k3rnL/open-cinema-hardware/docs/rear-io-mechanical.md

# Current rear I/O mechanical model

Use [A9: PCB and connectors only](pcb-only-assembly-A9.md). The owner designs the backplate and L brackets. The [A8 PCB layout and connector evidence](horizontal-assembly-A8.md) remain applicable; its plate/bracket geometry is historical.
