k3rnL/open-cinema-hardware/boards/rear-io/exports/rear-io-A0-top.png

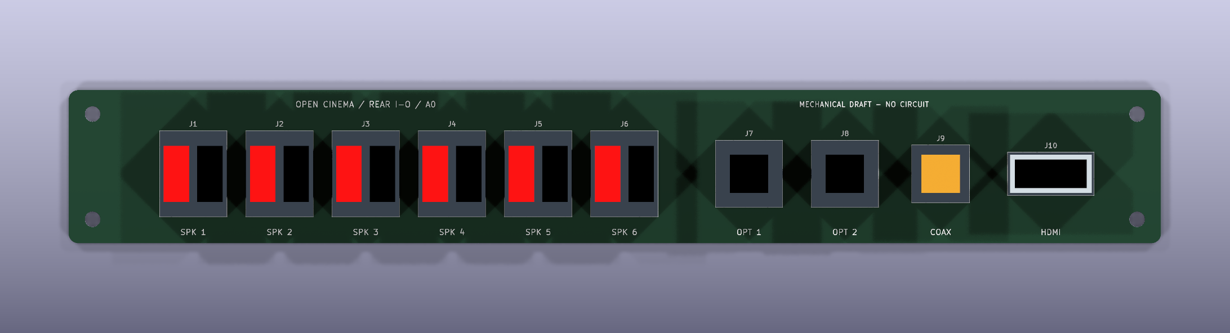
boards/rear-io/exports/rear-io-A0-top.png
