k3rnL/open-cinema-hardware/boards/rear-io/exports/rear-io-A1-front.png

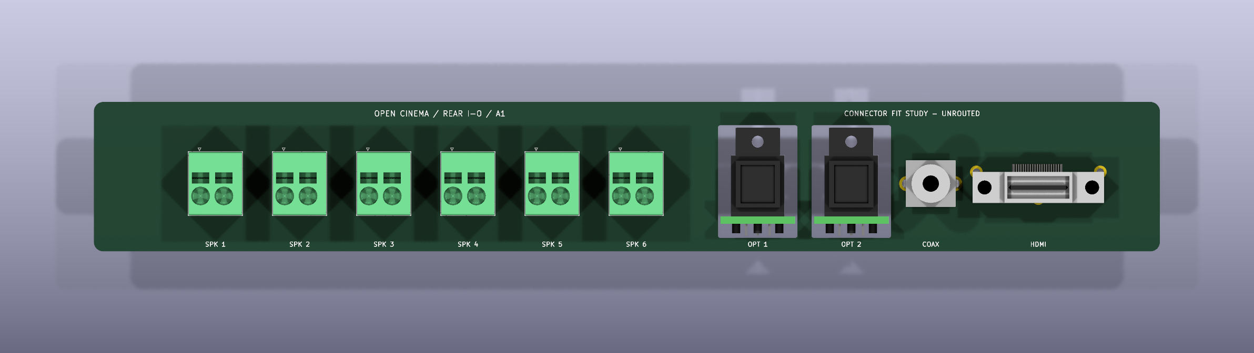
boards/rear-io/exports/rear-io-A1-front.png
