k3rnL/open-cinema-hardware/boards/rear-io/exports/rear-io-A1-oblique.png

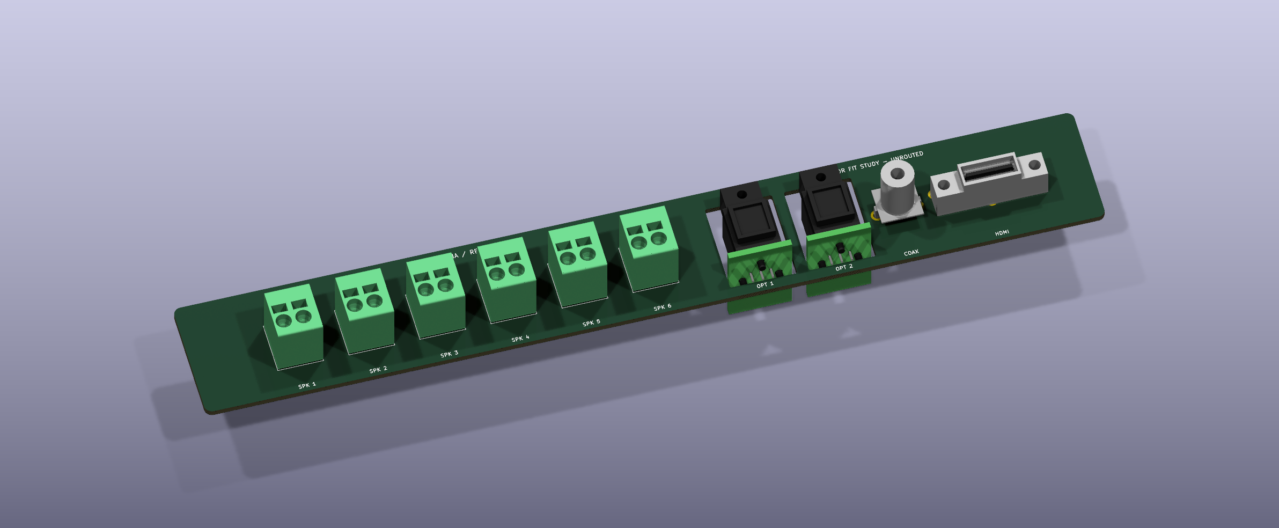
boards/rear-io/exports/rear-io-A1-oblique.png
