k3rnL/open-cinema-hardware/boards/rear-io/exports/rear-io-A3-oblique.png

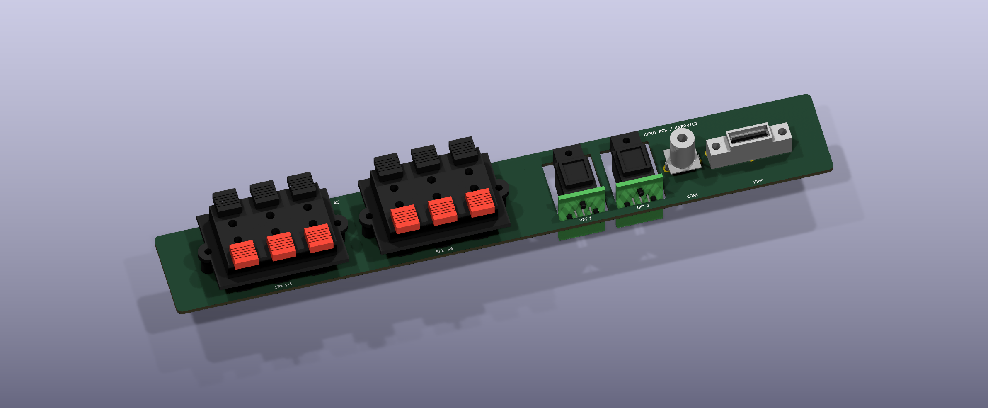
boards/rear-io/exports/rear-io-A3-oblique.png
