k3rnL/open-cinema-hardware/boards/rear-io/exports/rear-io-A8-context.png

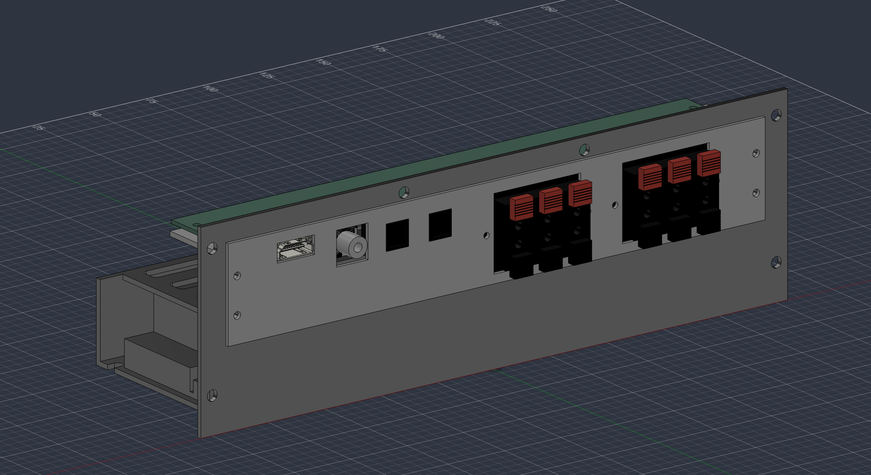
boards/rear-io/exports/rear-io-A8-context.png
