k3rnL/open-cinema-hardware/boards/rear-io/exports/rear-io-A8-live-enclosure.png

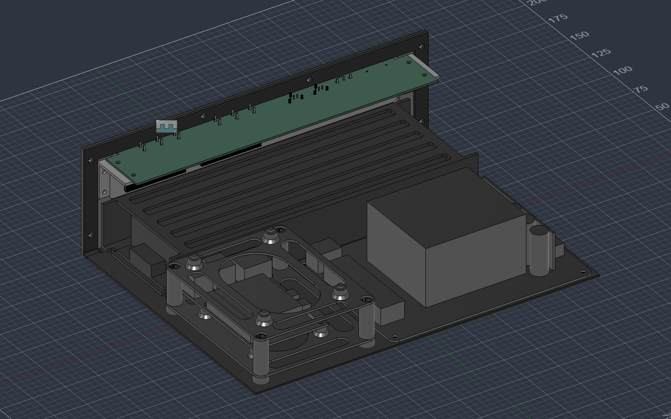
boards/rear-io/exports/rear-io-A8-live-enclosure.png
