k3rnL/open-cinema-hardware/mechanical/reference/2026-11-03-owner-A7-depth-top.png

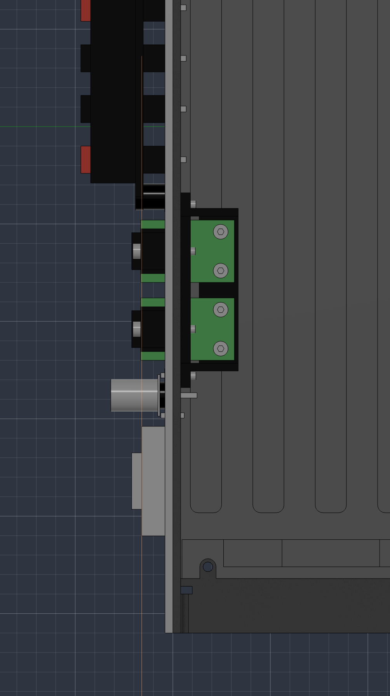
mechanical/reference/2026-11-03-owner-A7-depth-top.png
