k3rnL/open-cinema-hardware/mechanical/reference/rear-panel-220x35.png

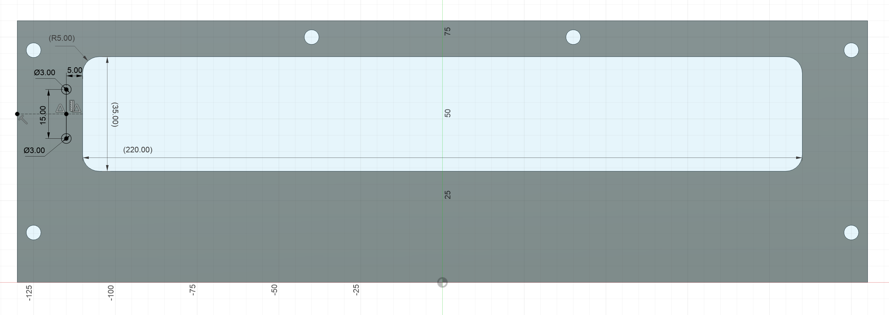
mechanical/reference/rear-panel-220x35.png
