k3rnL/open-cinema-hardware/mechanical/reference/rear-panel-fixing-reference.png

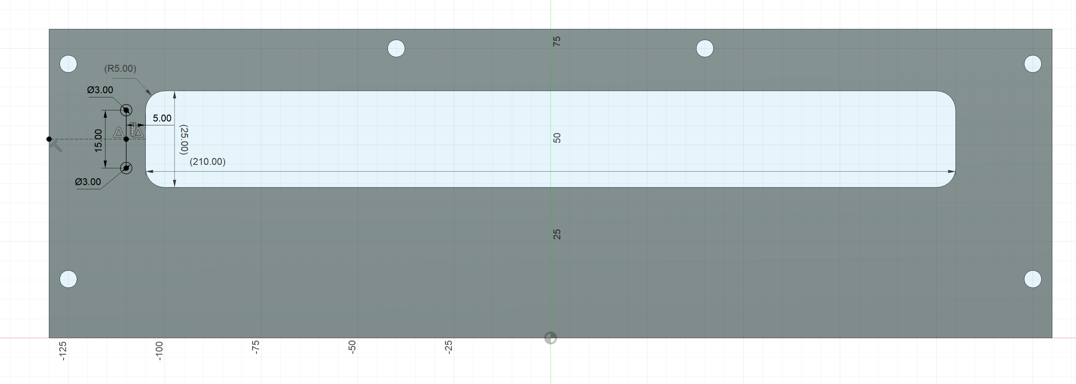
mechanical/reference/rear-panel-fixing-reference.png
