k3rnL/open-cinema-hardware/mechanical/reference/rear-panel-frame.png

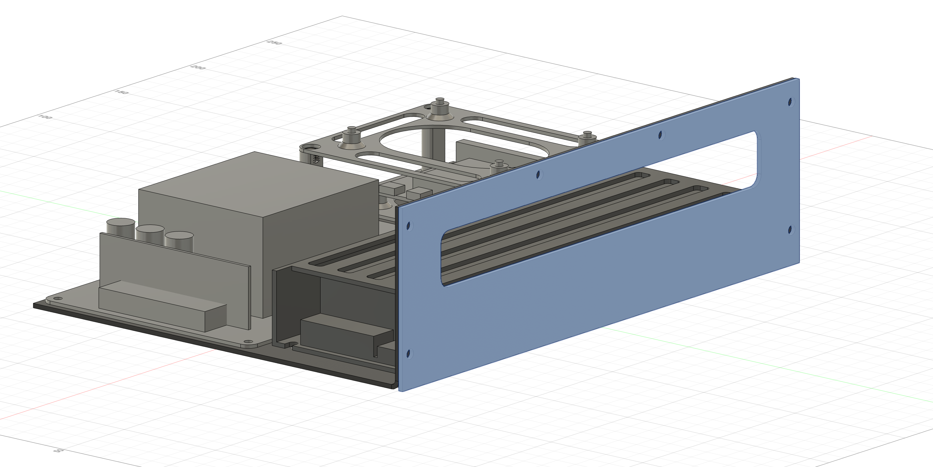
mechanical/reference/rear-panel-frame.png
