k3rnL/open-cinema-hardware/mechanical/reference/rear-panel-free-space.png

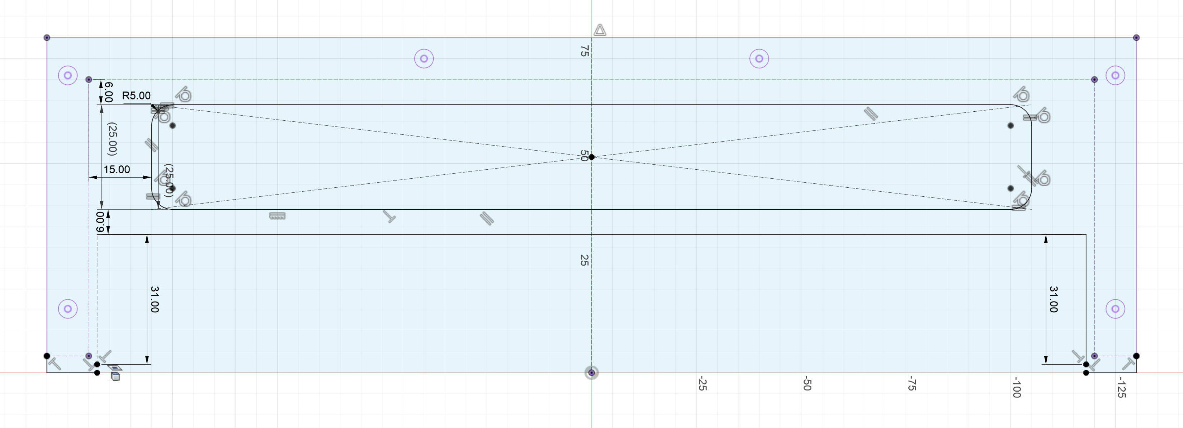
mechanical/reference/rear-panel-free-space.png
