k3rnL/open-cinema-hardware/docs/sourcing-A7.md

# A7 sourcing — accepted FE6930 selection

2026-11-03. JLCPCB is preferred; the owner permits Global Sourcing/pre-order and outside suppliers. No purchases or supplier requests have been made. This worksheet covers the mechanical connector selection, not a finished PCBA BOM.

| Qty | Exact part | Procurement route |
| --- | --- | --- |
| 2 | **Cliff FE6930** eight-contact speaker block | [DigiKey 4654-FE6930-ND](https://www.digikey.com/en/products/detail/cliff-electronic-components-ltd/FE6930/25552004); retrieved page showed active, 151 in stock, minimum 1. Web result can be cached; recheck at checkout. Outside purchase is permitted. No confirmed JLC stock/acceptance claimed |
| 2 | Cliff **FCR684205R / ORJ5** optical receiver | [DigiKey 4654-FCR684205R-ND](https://www.digikey.com/en/products/detail/cliff-electronic-components-ltd/FCR684205R/15283094); distributor stock checked in the earlier same-day A6 audit. JLC Global Sourcing subject to acceptance, otherwise external purchase |
| 1 | Same Sky **RCJ-021** RCA | [JLC C4992555](https://jlcpcb.com/partdetail/CUI-RCJ021/C4992555), zero public stock in A6 audit; external [DigiKey CP-1406-ND](https://www.digikey.co.uk/en/products/detail/same-sky-formerly-cui-devices/RCJ-021/408493) alternative |
| 1 | Amphenol **10078837-001LF** HDMI | [JLC C7159430](https://jlcpcb.com/partdetail/AmphenolICC-10078837001LF/C7159430), 2400 shown in the earlier same-day live catalogue audit; confirm with eventual PCBA order |

FE6930 selection is now accepted for the fit model, superseding A6's unresolved PT-603B candidate. The manufacturer publishes **7 A at 60 V AC**; exact geometry/rating evidence and pair mapping are in [connector selection](connector-selection-A7.md). Do not substitute an unbranded lookalike based only on a photograph.

If JLC cannot procure/assemble these through-hole parts, buy them externally and populate them after PCB manufacture. Consignment is only an option if JLC accepts the parts and process. Distributor stock is not JLC inventory, and Global Sourcing supplies subsequent PCBA rather than loose parts. [Earlier catalogue audit and policy sources](sourcing-A6.md).

The optical cradle and M2 fasteners are separate mechanical purchases; see [assembly](assembly-and-optical-support-A7.md). No cradle manufacturing quote, final speaker fastening stack, physical sample fit, production footprint approval or solder process qualification exists yet. The board has no circuitry and is not ready for a production order.
