k3rnL/open-cinema-hardware/boards/rear-io-A12/bom-draft.csv

ref | value | mpn | fp | dnp | source
U6 | TLV75533PDRVR | TLV75533PDRVR | Package_SON:WSON-6-1EP_2x2mm_P0.65mm_EP1x1.6mm | False | https://www.ti.com/lit/ds/symlink/tlv755p.pdf
J21 | 5V regulated input | TSW-102-07-G-S | Connector_PinHeader_2.54mm:PinHeader_1x02_P2.54mm_Vertical | False | https://www.samtec.com/products/tsw-102-07-g-s
J20 | PI CONTROL / NOT PI PINOUT | TSW-106-07-G-D | Connector_PinHeader_2.54mm:PinHeader_2x06_P2.54mm_Vertical | False | https://www.samtec.com/products/tsw-106-07-g-d
C1 | 4.7uF | CL10A475KO8NNNC | Capacitor_SMD:C_0603_1608Metric | False
C2 | 4.7uF | CL10A475KO8NNNC | Capacitor_SMD:C_0603_1608Metric | False
C3 | 10uF | CL10A106KP8NNNC | Capacitor_SMD:C_0603_1608Metric | False
R1 | 4.7k | RC0603FR-074K7L | Resistor_SMD:R_0603_1608Metric | True
R2 | 4.7k | RC0603FR-074K7L | Resistor_SMD:R_0603_1608Metric | True
R3 | 10k | RC0603FR-0710KL | Resistor_SMD:R_0603_1608Metric | False
R6 | 10k | RC0603FR-0710KL | Resistor_SMD:R_0603_1608Metric | False
U1 | CS8416K-CZZR | CS8416K-CZZR | Package_SO:TSSOP-28_4.4x9.7mm_P0.65mm | False | https://statics.cirrus.com/pubs/proDatasheet/CS8416_DS578F5.pdf
J7 | FCR684205R | FCR684205R | OpenCinema_Connectors:Cliff_FCR684205R | False
C11 | 100nF | CL10B104KB8NNNC | Capacitor_SMD:C_0603_1608Metric | False
C13 | 100nF | CL10B104KB8NNNC | Capacitor_SMD:C_0603_1608Metric | False
C15 | 30pF C0G | CL10C300JB8NNNC | Capacitor_SMD:C_0603_1608Metric | False
J8 | FCR684205R | FCR684205R | OpenCinema_Connectors:Cliff_FCR684205R | False
C12 | 100nF | CL10B104KB8NNNC | Capacitor_SMD:C_0603_1608Metric | False
C14 | 100nF | CL10B104KB8NNNC | Capacitor_SMD:C_0603_1608Metric | False
C16 | 30pF C0G | CL10C300JB8NNNC | Capacitor_SMD:C_0603_1608Metric | False
J9 | RCJ-011 | RCJ-011 | OpenCinema_Connectors:SameSky_RCJ_011_Horizontal_A8 | False
R10 | 75R 1% | RC0603FR-0775RL | Resistor_SMD:R_0603_1608Metric | False
C17 | 10nF | CL10B103KB8NNNC | Capacitor_SMD:C_0603_1608Metric | False
C18 | 10nF | CL10B103KB8NNNC | Capacitor_SMD:C_0603_1608Metric | False
FB1 | 600R @100MHz | BLM18AG601SN1D | Inductor_SMD:L_0603_1608Metric | False
C19 | 100nF | CL10B104KB8NNNC | Capacitor_SMD:C_0603_1608Metric | False
C20 | 10uF | CL10A106KP8NNNC | Capacitor_SMD:C_0603_1608Metric | False
C21 | 100nF | CL10B104KB8NNNC | Capacitor_SMD:C_0603_1608Metric | False
C22 | 100nF | CL10B104KB8NNNC | Capacitor_SMD:C_0603_1608Metric | False
C23 | 1nF C0G | CL10C102JB8NNNC | Capacitor_SMD:C_0603_1608Metric | False
C24 | 22nF X7R | CL10B223KB8NNNC | Capacitor_SMD:C_0603_1608Metric | False
R11 | 3k 1% | RC0603FR-073KL | Resistor_SMD:R_0603_1608Metric | False
R12 | 47k | RC0603FR-0747KL | Resistor_SMD:R_0603_1608Metric | False
R13 | 47k | RC0603FR-0747KL | Resistor_SMD:R_0603_1608Metric | False
R14 | 10k | RC0603FR-0710KL | Resistor_SMD:R_0603_1608Metric | False
R15 | 10k | RC0603FR-0710KL | Resistor_SMD:R_0603_1608Metric | False
U4 | DS90LV047ATMTC/NOPB | DS90LV047ATMTC/NOPB | Package_SO:TSSOP-16_4.4x5mm_P0.65mm | False | https://www.ti.com/lit/ds/symlink/ds90lv047a.pdf
J22 | 3 LVDS PAIRS / PROVISIONAL | TSW-110-07-G-D | Connector_PinHeader_2.54mm:PinHeader_2x10_P2.54mm_Vertical | False | https://www.samtec.com/products/tsw-110-07-g-d
C32 | 100nF | CL10B104KB8NNNC | Capacitor_SMD:C_0603_1608Metric | False
SP1 | KLS1-WP-6P-03B / UNQUALIFIED | L-KLS1-WP-6P-03B-B/R | OpenCinema_Connectors:KLS1_WP_6P_03B_Horizontal_A8 | False
J31 | AMP WIRE SOLDER PADS | PCB_SOLDER_PADS_1SQMM | Connector_Wire:SolderWire-1sqmm_1x06_P5.4mm_D1.4mm_OD2.7mm | False
SP2 | KLS1-WP-6P-03B / UNQUALIFIED | L-KLS1-WP-6P-03B-B/R | OpenCinema_Connectors:KLS1_WP_6P_03B_Horizontal_A8 | False
J32 | AMP WIRE SOLDER PADS | PCB_SOLDER_PADS_1SQMM | Connector_Wire:SolderWire-1sqmm_1x06_P5.4mm_D1.4mm_OD2.7mm | False
U7 | ADV7511KSTZ / ARC candidate | ADV7511KSTZ | Package_QFP:LQFP-100_14x14mm_P0.5mm | False | https://www.analog.com/media/en/technical-documentation/user-guides/ADV7511_Hardware_Users_Guide.pdf
R40 | 887R 1% | RC0603FR-07887RL | Resistor_SMD:R_0603_1608Metric | False
R41 | 2k 1% | RC0603FR-072KL | Resistor_SMD:R_0603_1608Metric | False
R42 | 2k 1% | RC0603FR-072KL | Resistor_SMD:R_0603_1608Metric | False
Y1 | 12 MHz / ASV-12.000MHZ-E-T | ASV-12.000MHZ-E-T | Oscillator:Oscillator_SMD_Abracon_ASV-4Pin_7.0x5.1mm | False | https://abracon.com/Oscillators/ASV.pdf
R43 | 33R | RC0603FR-0733RL | Resistor_SMD:R_0603_1608Metric | False
C40 | 100nF | CL10B104KB8NNNC | Capacitor_SMD:C_0603_1608Metric | False
J10 | 10029449-001RLF / ARC ONLY | 10029449-001RLF | OpenCinema_Connectors:HDMI_A_Amphenol_10029449-x01xLF_Horizontal | False
C41 | 1uF 16V | CL10B105KO8NNNC | Capacitor_SMD:C_0603_1608Metric | False
C42 | 1uF 16V | CL10B105KO8NNNC | Capacitor_SMD:C_0603_1608Metric | False
R44 | 49.9R 1% | RC0603FR-0749R9L | Resistor_SMD:R_0603_1608Metric | False
R45 | 49.9R 1% | RC0603FR-0749R9L | Resistor_SMD:R_0603_1608Metric | False
R46 | 10k | RC0603FR-0710KL | Resistor_SMD:R_0603_1608Metric | False
R47 | 2k 1% | RC0603FR-072KL | Resistor_SMD:R_0603_1608Metric | False
R48 | 2k 1% | RC0603FR-072KL | Resistor_SMD:R_0603_1608Metric | False
R49 | 27k 1% | RC0603FR-0727KL | Resistor_SMD:R_0603_1608Metric | False
D1 | BAS116,215 | BAS116,215 | Package_TO_SOT_SMD:SOT-23 | False | https://assets.nexperia.com/documents/data-sheet/BAS116.pdf
R50 | 33R | RC0603FR-0733RL | Resistor_SMD:R_0603_1608Metric | False
C43 | 100nF | CL10B104KB8NNNC | Capacitor_SMD:C_0603_1608Metric | False
R51 | 0R / chassis bond DNP | RC0603JR-070RL | Resistor_SMD:R_0603_1608Metric | True
U10 | TPD4E05U06DQAR | TPD4E05U06DQAR | Package_SON:USON-10_2.5x1.0mm_P0.5mm | False | https://www.ti.com/lit/ds/symlink/tpd4e05u06.pdf
U11 | TPD4E05U06DQAR | TPD4E05U06DQAR | Package_SON:USON-10_2.5x1.0mm_P0.5mm | False | https://www.ti.com/lit/ds/symlink/tpd4e05u06.pdf
U8 | TLV75518PDRVR | TLV75518PDRVR | Package_SON:WSON-6-1EP_2x2mm_P0.65mm_EP1x1.6mm | False | https://www.ti.com/lit/ds/symlink/tlv755p.pdf
C44 | 4.7uF | CL10A475KO8NNNC | Capacitor_SMD:C_0603_1608Metric | False
C45 | 4.7uF | CL10A475KO8NNNC | Capacitor_SMD:C_0603_1608Metric | False
L1 | 10uH / SRN4018-100M | SRN4018-100M | Inductor_SMD:L_Bourns-SRN4018 | False | https://www.bourns.com/docs/product-datasheets/srn4018.pdf
C46 | 10uF | CL10A106KP8NNNC | Capacitor_SMD:C_0603_1608Metric | False
L2 | 10uH / SRN4018-100M | SRN4018-100M | Inductor_SMD:L_Bourns-SRN4018 | False | https://www.bourns.com/docs/product-datasheets/srn4018.pdf
C47 | 10uF | CL10A106KP8NNNC | Capacitor_SMD:C_0603_1608Metric | False
L3 | 10uH / SRN4018-100M | SRN4018-100M | Inductor_SMD:L_Bourns-SRN4018 | False | https://www.bourns.com/docs/product-datasheets/srn4018.pdf
C48 | 10uF | CL10A106KP8NNNC | Capacitor_SMD:C_0603_1608Metric | False
C50 | 100nF / U7 pin 1 | CL10B104KB8NNNC | Capacitor_SMD:C_0603_1608Metric | False
C51 | 100nF / U7 pin 19 | CL10B104KB8NNNC | Capacitor_SMD:C_0603_1608Metric | False
C52 | 100nF / U7 pin 49 | CL10B104KB8NNNC | Capacitor_SMD:C_0603_1608Metric | False
C53 | 100nF / U7 pin 76 | CL10B104KB8NNNC | Capacitor_SMD:C_0603_1608Metric | False
C54 | 100nF / U7 pin 77 | CL10B104KB8NNNC | Capacitor_SMD:C_0603_1608Metric | False
C55 | 100nF / U7 pin 24 | CL10B104KB8NNNC | Capacitor_SMD:C_0603_1608Metric | False
C56 | 100nF / U7 pin 25 | CL10B104KB8NNNC | Capacitor_SMD:C_0603_1608Metric | False
C57 | 100nF / U7 pin 29 | CL10B104KB8NNNC | Capacitor_SMD:C_0603_1608Metric | False
C58 | 100nF / U7 pin 34 | CL10B104KB8NNNC | Capacitor_SMD:C_0603_1608Metric | False
C59 | 100nF / U7 pin 41 | CL10B104KB8NNNC | Capacitor_SMD:C_0603_1608Metric | False
C60 | 100nF / U7 pin 21 | CL10B104KB8NNNC | Capacitor_SMD:C_0603_1608Metric | False
C61 | 100nF / U7 pin 26 | CL10B104KB8NNNC | Capacitor_SMD:C_0603_1608Metric | False
C62 | 100nF / U7 pin 47 | CL10B104KB8NNNC | Capacitor_SMD:C_0603_1608Metric | False
U9 | TPS2553DBVR | TPS2553DBVR | Package_TO_SOT_SMD:SOT-23-6 | False | https://www.ti.com/lit/ds/symlink/tps2553.pdf
R52 | 226k 1% | RC0603FR-07226KL | Resistor_SMD:R_0603_1608Metric | False
R53 | 10k | RC0603FR-0710KL | Resistor_SMD:R_0603_1608Metric | False
R54 | 10k | RC0603FR-0710KL | Resistor_SMD:R_0603_1608Metric | False
C63 | 1uF 16V | CL10B105KO8NNNC | Capacitor_SMD:C_0603_1608Metric | False
C64 | 100nF | CL10B104KB8NNNC | Capacitor_SMD:C_0603_1608Metric | False
J24 | HDMI POWER FAULT / GND | TSW-102-07-G-S | Connector_PinHeader_2.54mm:PinHeader_1x02_P2.54mm_Vertical | False | https://www.samtec.com/products/tsw-102-07-g-s
D2 | TPD1E10B06DYAR | TPD1E10B06DYAR | Diode_SMD:D_SOD-523 | False | https://www.ti.com/lit/ds/symlink/tpd1e10b06.pdf
