k3rnL/open-cinema-hardware/boards/rear-io/connector-placement.csv

ref | label | footprint | rear_x | depth | angle | mpn
SP1 | 3 speaker pairs - candidate | KLS1_WP_6P_03B_Horizontal_A8 | -75 | 0 | 0 | L-KLS1-WP-6P-03B-B/R
SP2 | 3 speaker pairs - candidate | KLS1_WP_6P_03B_Horizontal_A8 | -18 | 0 | 0 | L-KLS1-WP-6P-03B-B/R
J7 | Optical | Cliff_FCR684205R | 25 | 9 | 0 | FCR684205R
J8 | Optical | Cliff_FCR684205R | 44 | 9 | 0 | FCR684205R
J9 | Coax | SameSky_RCJ_011_Horizontal_A8 | 64 | 7 | 0 | RCJ-011
J10 | HDMI | HDMI_A_Amphenol_10029449-x01xLF_Horizontal | 89 | 2.7 | 180 | 10029449-001RLF
H1 | PCB mounting reference | MountingHole_D3_Reference_A8 | -110 | 12 | 0 | D3 reference
H2 | PCB mounting reference | MountingHole_D3_Reference_A8 | -110 | 30 | 0 | D3 reference
H3 | PCB mounting reference | MountingHole_D3_Reference_A8 | 110 | 12 | 0 | D3 reference
H4 | PCB mounting reference | MountingHole_D3_Reference_A8 | 110 | 30 | 0 | D3 reference
