k3rnL/open-cinema-hardware/boards/rear-io/exports/rear-io-A8-assembly.step

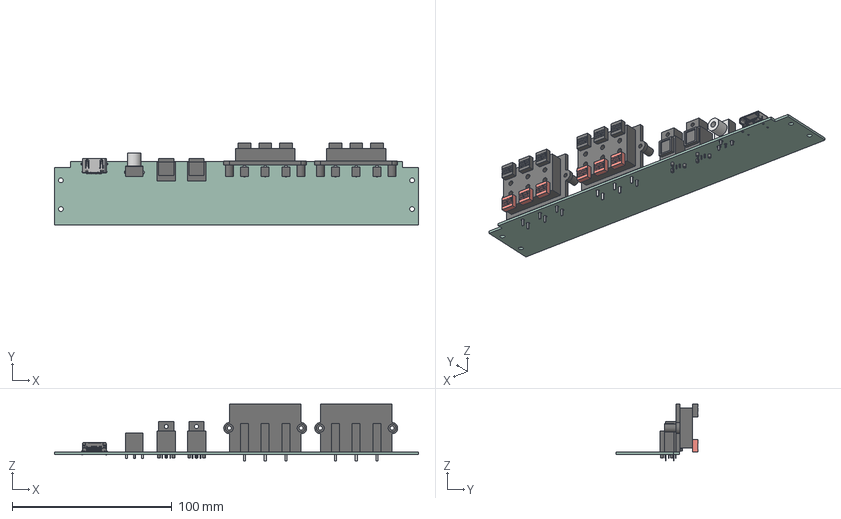
[picture p26: CAD file, 2026-11-03]
boards/rear-io/exports/rear-io-A8-assembly.step
228.0 x 51.4 x 35.5 mm
HDMI_A_Amphenol_10029449-x01xLF_Horizontal
Cliff_FCR684205R x 2
Same Sky RCJ-011 horizontal
KLS right-angle candidate - current rating UNVERIFIED x 2
rear-io_PCB
