k3rnL/open-cinema-hardware/boards/rear-io/exports/rear-io-A7-assembly.step

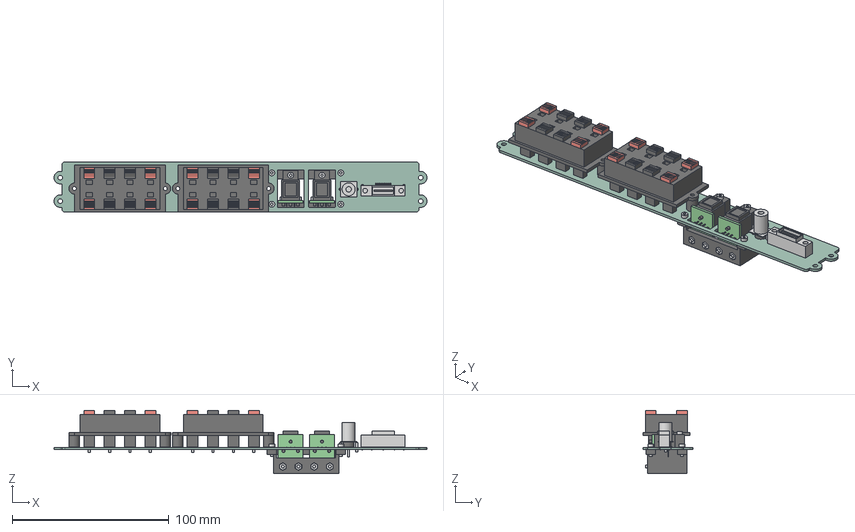
[picture p27: CAD file, 2026-11-03]
boards/rear-io/exports/rear-io-A7-assembly.step
238.0 x 32.0 x 40.4 mm
Cradle_and_M2_fasteners
Optical_daughterboard_assembly x 2
SameSky_RCJ-021
Amphenol_10078837-001LF
Cliff FE6930 - 8 contacts - straight rear tails x 2
rear-io_PCB
