k3rnL/open-cinema-hardware/boards/rear-io/models/optical-daughterboard-assembly.step

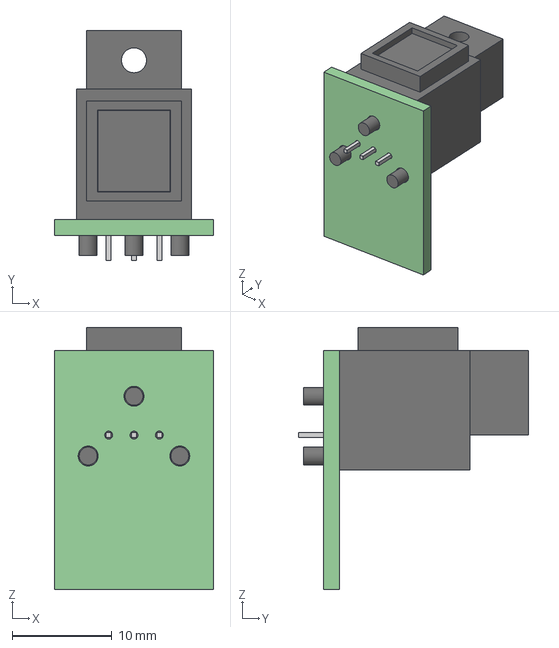
[picture p28: CAD file, 2026-11-03]
boards/rear-io/models/optical-daughterboard-assembly.step
16.0 x 23.1 x 26.3 mm
