k3rnL/open-cinema-hardware/boards/rear-io/exports/rear-io-A4-assembly.step

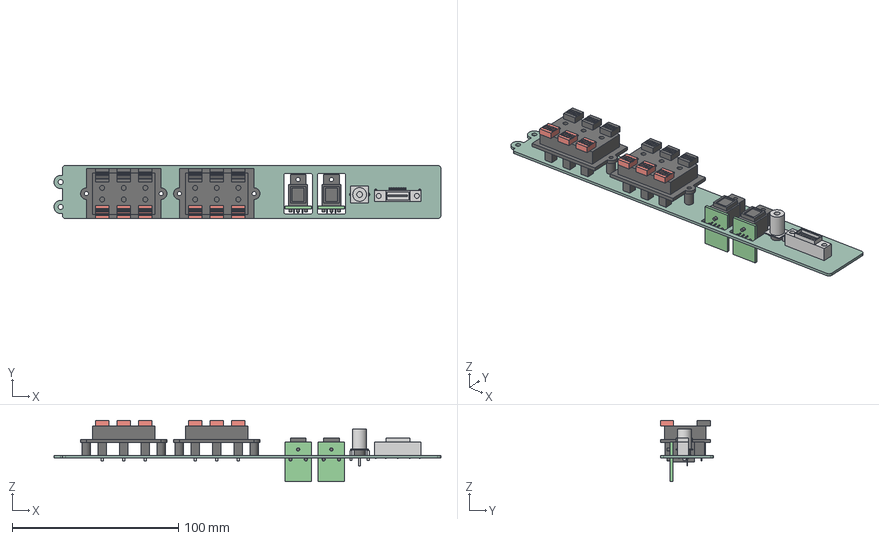
[picture p31: CAD file, 2026-11-03]
boards/rear-io/exports/rear-io-A4-assembly.step
233.0 x 32.0 x 37.0 mm
Optical_daughterboard_assembly x 2
DragonCity_PT-603B - straight rear tails x 2
SameSky_RCJ-021
Amphenol_10078837-001LF
rear-io_PCB
