k3rnL/open-cinema-hardware/boards/rear-io/exports/rear-io-A2-assembly.step

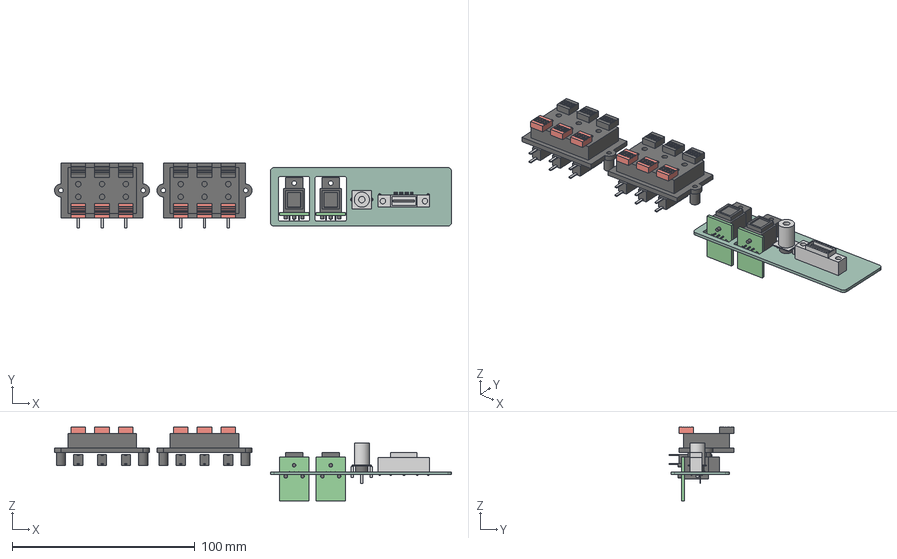
[picture p32: CAD file, 2026-11-03]
boards/rear-io/exports/rear-io-A2-assembly.step
217.0 x 35.5 x 40.2 mm
Optical_daughterboard_assembly x 2
KLS1-WP-6P-03B - mechanical candidate x 2
Amphenol_10078837-001LF
SameSky_RCJ-021
rear-io_PCB
