k3rnL/open-cinema-hardware/boards/rear-io/exports/rear-io-A1-assembly.step

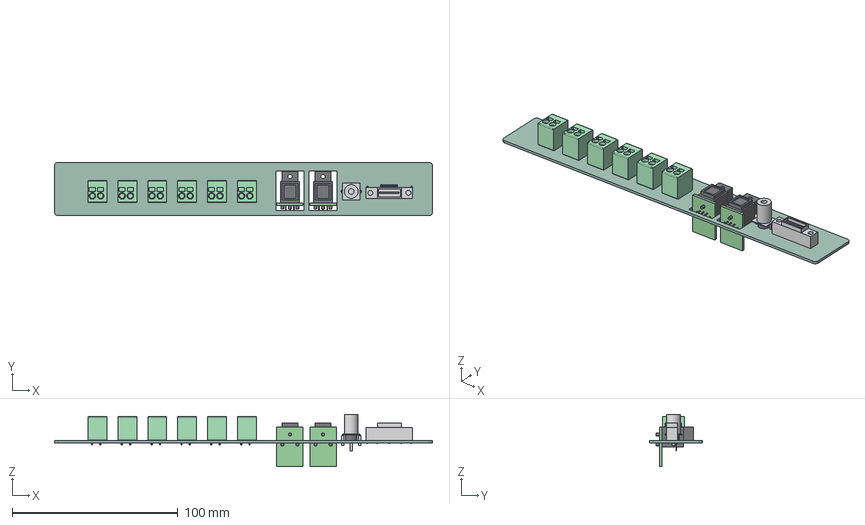
[picture p33: CAD file, 2026-11-03]
boards/rear-io/exports/rear-io-A1-assembly.step
228.0 x 32.0 x 31.6 mm
Amphenol_10078837-001LF
a63837e4-a09d-11ed-8f45-a0cec80452fd_part x 6
a6383c44-a09d-11ed-8f45-a0cec80452fd_part x 6
a6383f14-a09d-11ed-8f45-a0cec80452fd_part x 6
Optical_daughterboard_assembly x 2
SameSky_RCJ-021
rear-io_PCB
