k3rnL/open-cinema-hardware/boards/rear-io-A10/exports/rear-io-A10-rigid.step

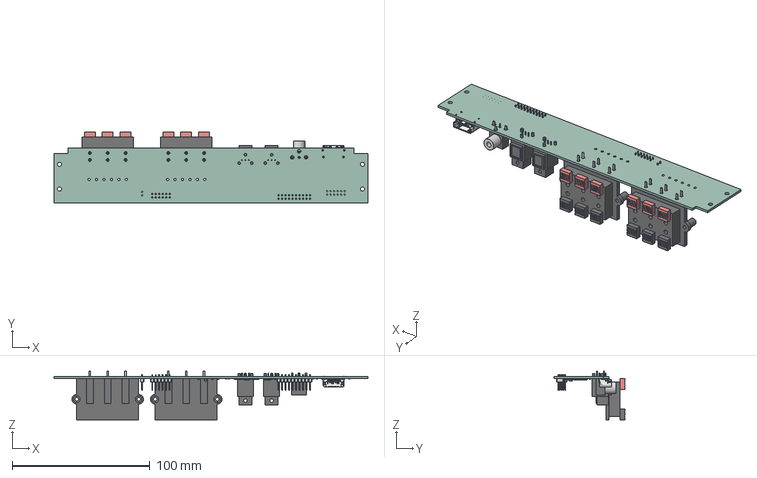
[picture p34: CAD file, 2026-11-03]
boards/rear-io-A10/exports/rear-io-A10-rigid.step
228.0 x 51.4 x 35.5 mm
