k3rnL/open-cinema-hardware/boards/rear-io-A10/models/SOT-23-5.step

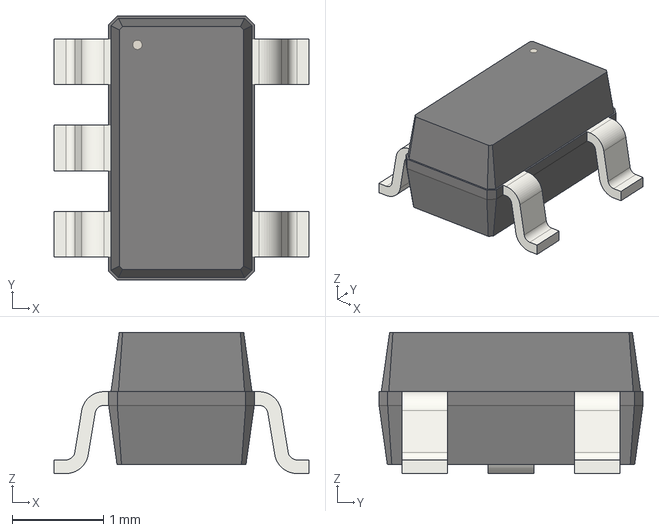
[picture p35: CAD file, 2026-11-03]
boards/rear-io-A10/models/SOT-23-5.step
2.80 x 2.90 x 1.55 mm
