k3rnL/open-cinema-hardware/boards/rear-io-A12/exports/rear-io-A12-rigid.step

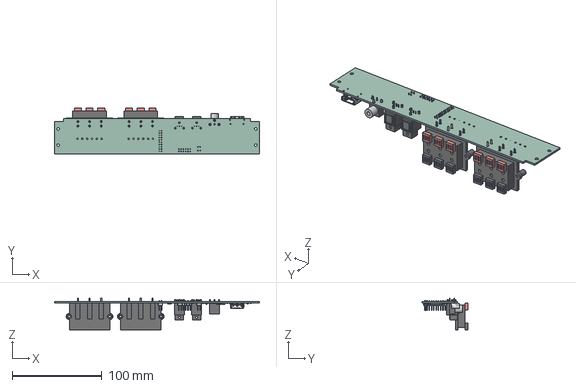
[picture p37: CAD file, 2026-11-04]
boards/rear-io-A12/exports/rear-io-A12-rigid.step
228.0 x 51.4 x 35.5 mm
