k3rnL/open-cinema-hardware/boards/rear-io-A12/models/D_SOD-523.step

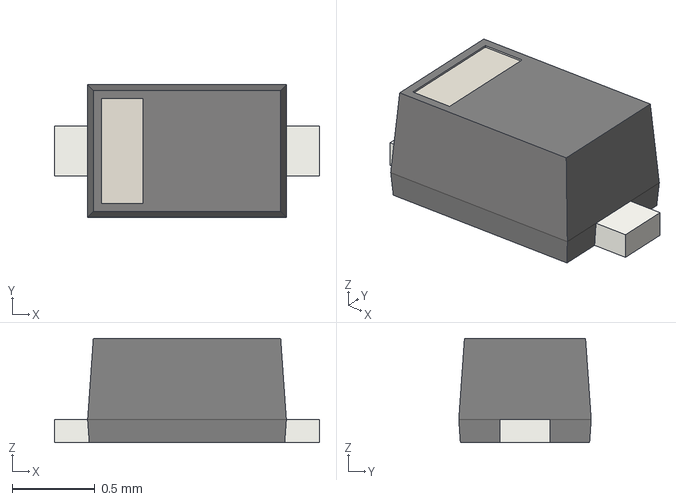
[picture p38: CAD file, 2026-11-04]
boards/rear-io-A12/models/D_SOD-523.step
1.60 x 0.8 x 0.63 mm
