k3rnL/open-cinema-hardware/boards/rear-io/models/RCJ-011_A8.step

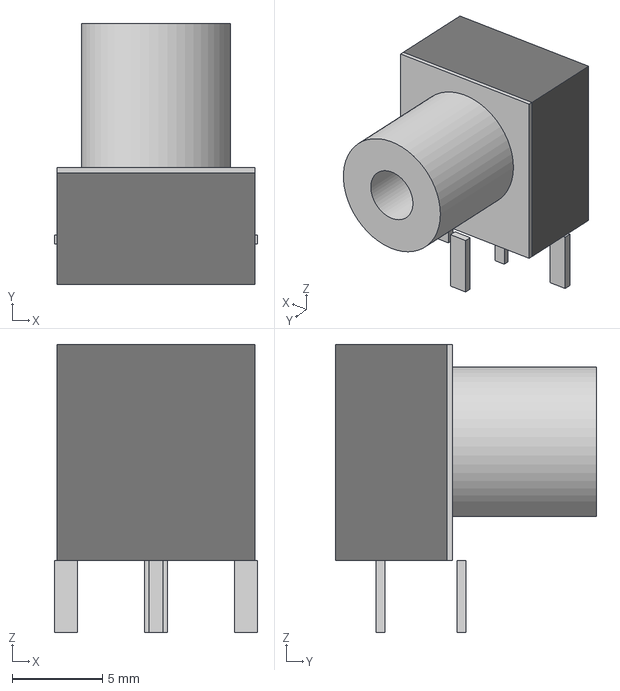
[picture p39: CAD file, 2026-11-03]
boards/rear-io/models/RCJ-011_A8.step
11.3 x 14.5 x 16.0 mm
