k3rnL/open-cinema-hardware/boards/rear-io-A12/models/SOT-23-6.step

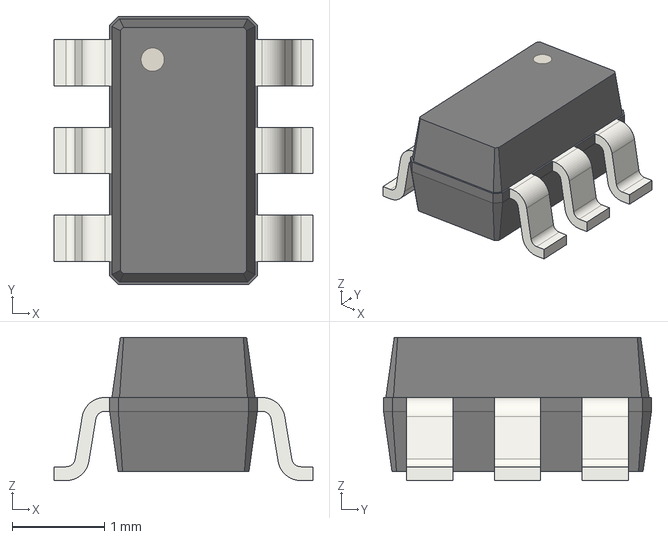
[picture p40: CAD file, 2026-11-04]
boards/rear-io-A12/models/SOT-23-6.step
2.80 x 2.90 x 1.55 mm
