k3rnL/open-cinema-hardware/boards/rear-io/models/HDMI_A_Amphenol_10029449-x01xLF_Horizontal.step

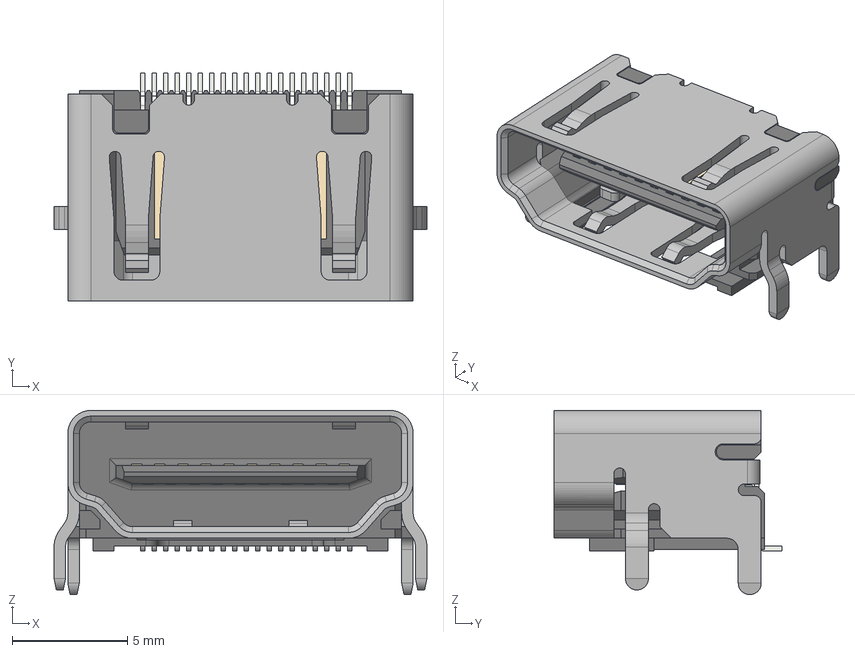
[picture p41: CAD file, 2026-11-03]
boards/rear-io/models/HDMI_A_Amphenol_10029449-x01xLF_Horizontal.step
16.2 x 9.90 x 8.00 mm
