k3rnL/open-cinema-hardware/boards/rear-io-A12/models/USON-10_2.5x1.0mm_P0.5mm.step

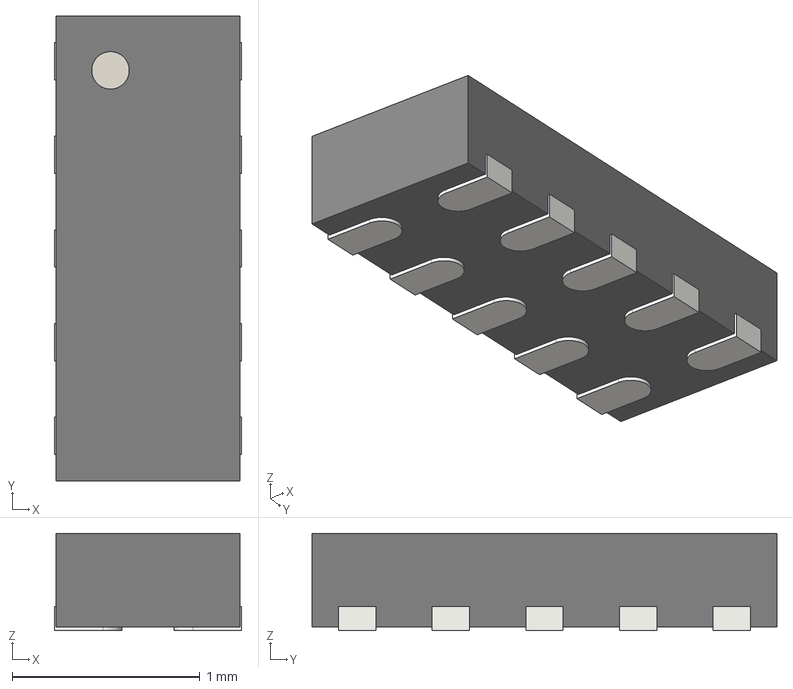
[picture p42: CAD file, 2026-11-04]
boards/rear-io-A12/models/USON-10_2.5x1.0mm_P0.5mm.step
1.00 x 2.48 x 0.52 mm
