k3rnL/open-cinema-hardware/boards/rear-io/models/KLS1-WP-6P-03B_horizontal_A8.step

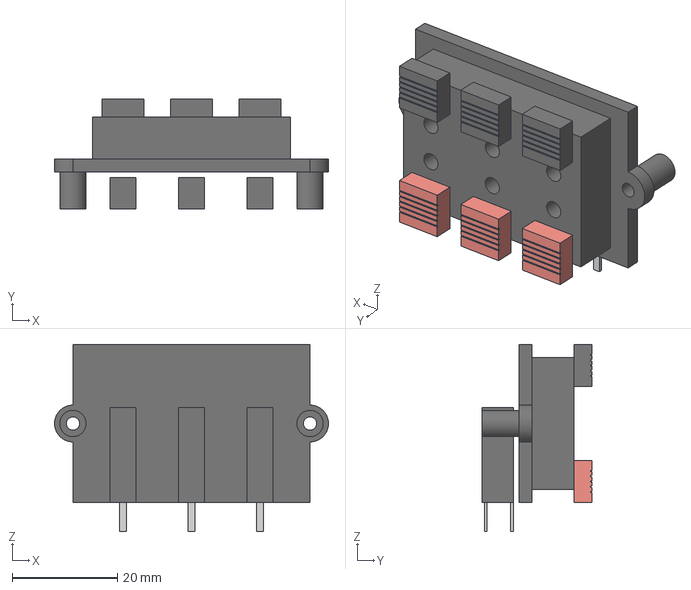
[picture p43: CAD file, 2026-11-03]
boards/rear-io/models/KLS1-WP-6P-03B_horizontal_A8.step
52.0 x 20.9 x 35.5 mm
