k3rnL/open-cinema-hardware/boards/rear-io-A12/models/WSON-6-1EP_2x2mm_P0.65mm_EP1x1.6mm.step

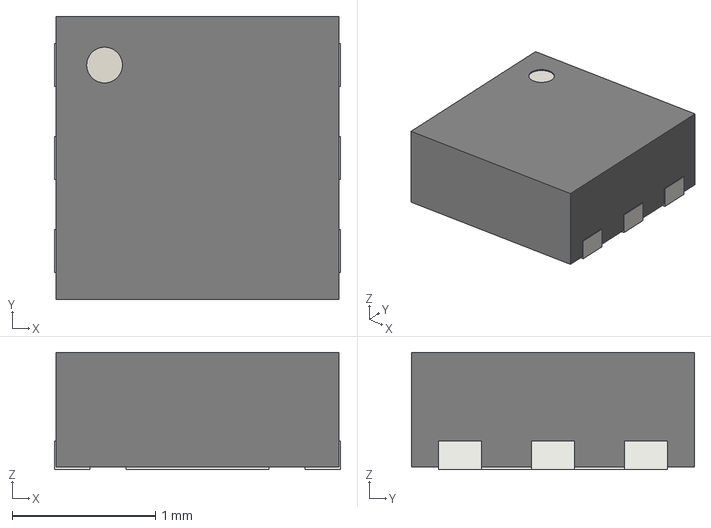
[picture p44: CAD file, 2026-11-04]
boards/rear-io-A12/models/WSON-6-1EP_2x2mm_P0.65mm_EP1x1.6mm.step
2.00 x 1.98 x 0.82 mm
