k3rnL/open-cinema-hardware/boards/rear-io/exports/rear-io-A8-outline.dxf

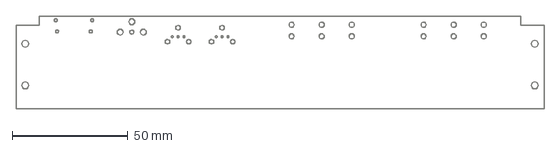
[picture p45: CAD file, 2026-11-03]
boards/rear-io/exports/rear-io-A8-outline.dxf
228.0 x 39.8 mm
