k3rnL/open-cinema-hardware/boards/rear-io/models/Cliff_FE6930.step

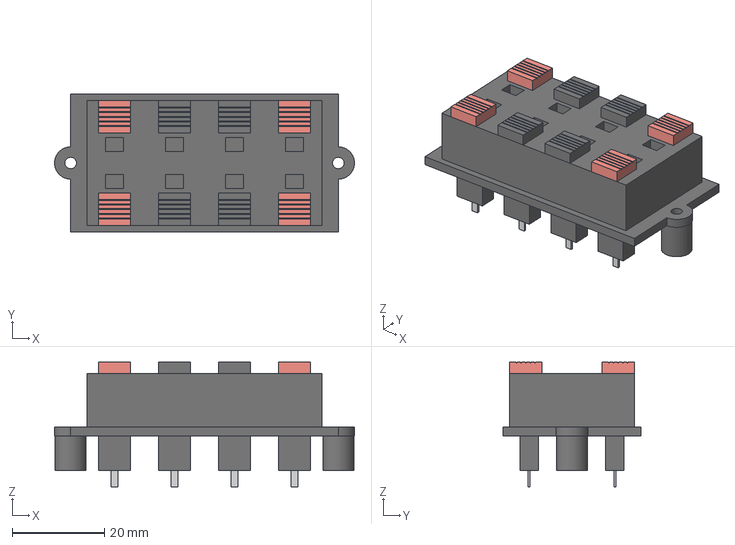
[picture p46: CAD file, 2026-11-03]
boards/rear-io/models/Cliff_FE6930.step
65.0 x 30.0 x 27.0 mm
