k3rnL/open-cinema-hardware/boards/rear-io-A12/models/SOT-23.step

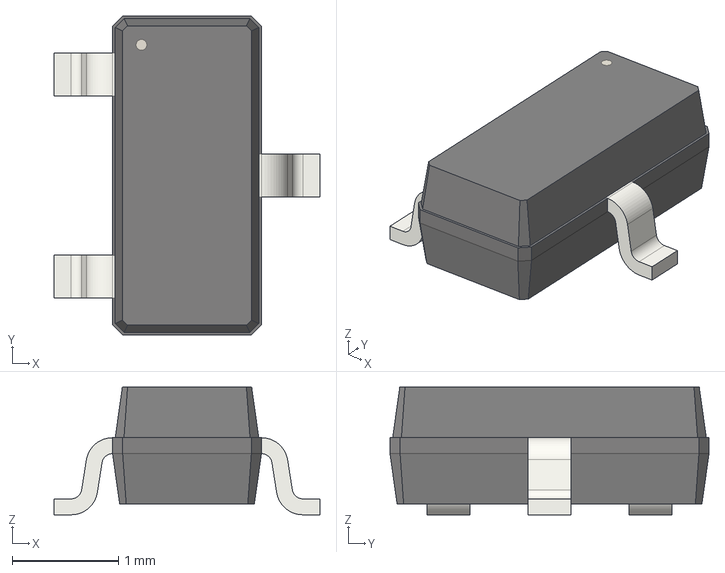
[picture p47: CAD file, 2026-11-04]
boards/rear-io-A12/models/SOT-23.step
2.50 x 3.00 x 1.20 mm
