k3rnL/open-cinema-hardware/boards/rear-io/exports/rear-io-A8-board-only.step

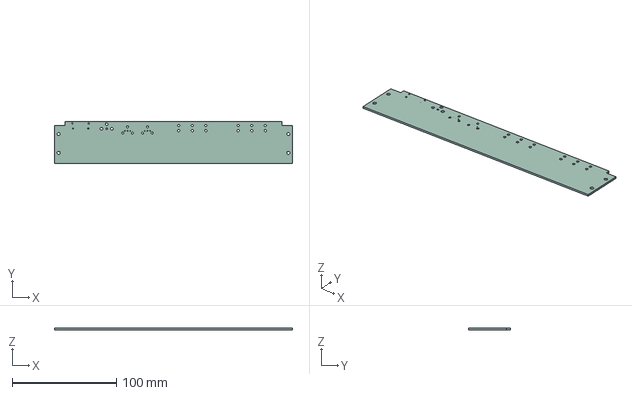
[picture p48: CAD file, 2026-11-03]
boards/rear-io/exports/rear-io-A8-board-only.step
228.0 x 39.8 x 1.51 mm
