k3rnL/open-cinema-hardware/boards/rear-io-A12/models/LQFP-100_14x14mm_P0.5mm.step

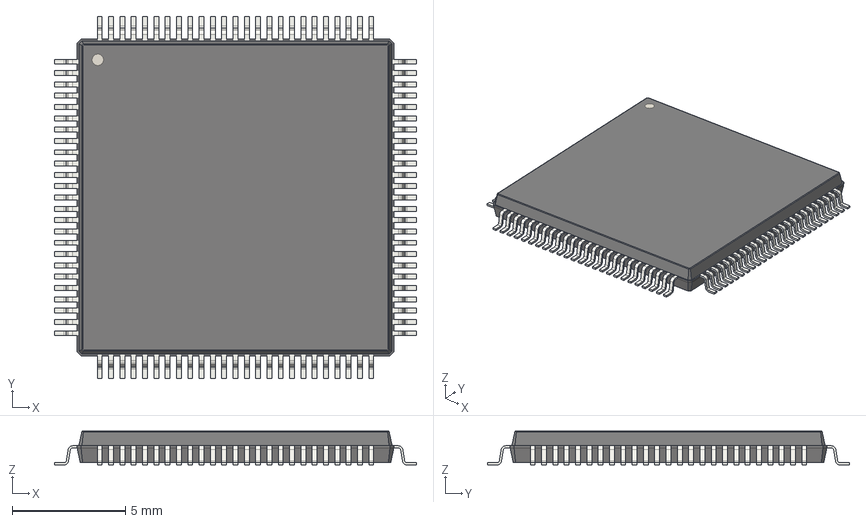
[picture p49: CAD file, 2026-11-04]
boards/rear-io-A12/models/LQFP-100_14x14mm_P0.5mm.step
16.0 x 16.0 x 1.50 mm
