k3rnL/open-cinema-hardware/boards/rear-io/exports/rear-io-A8-connection-plate.step

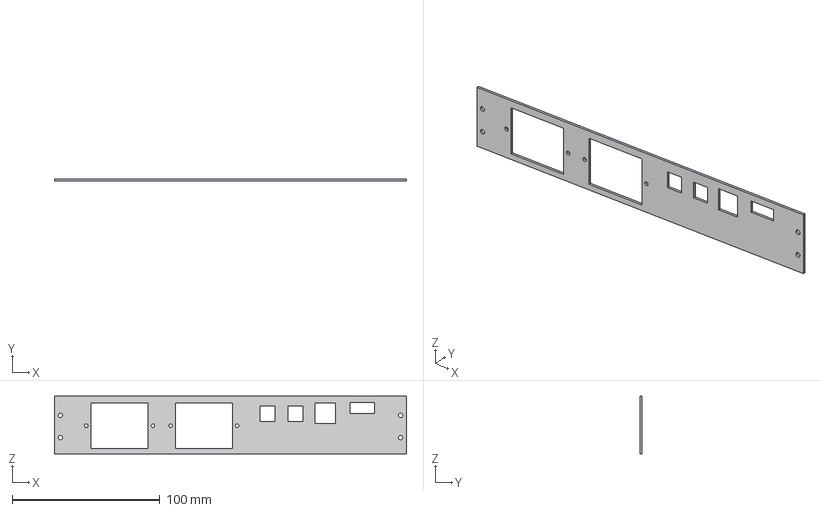
[picture p50: CAD file, 2026-11-03]
boards/rear-io/exports/rear-io-A8-connection-plate.step
238.0 x 1.50 x 39.0 mm
