k3rnL/open-cinema-hardware/boards/rear-io/models/optical-cradle-with-fasteners-A6.step

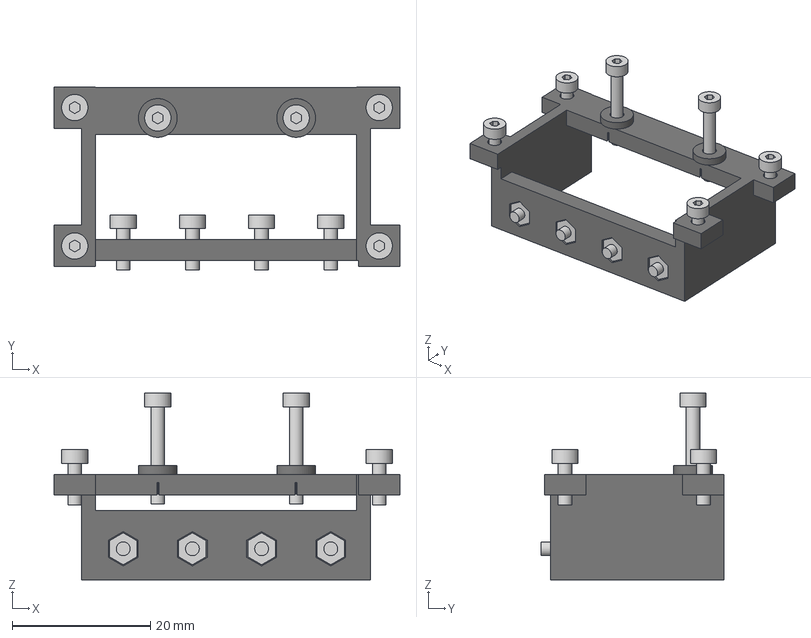
[picture p51: CAD file, 2026-11-03]
boards/rear-io/models/optical-cradle-with-fasteners-A6.step
50.0 x 26.5 x 27.0 mm
