k3rnL/open-cinema-hardware/boards/rear-io-A12/models/Oscillator_SMD_Abracon_ASV-4Pin_7.0x5.1mm.step

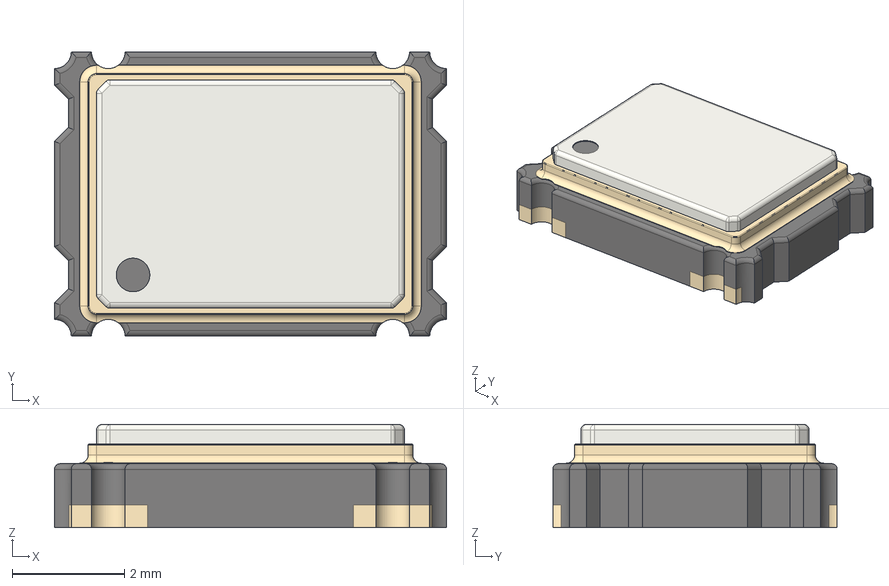
[picture p52: CAD file, 2026-11-04]
boards/rear-io-A12/models/Oscillator_SMD_Abracon_ASV-4Pin_7.0x5.1mm.step
7.00 x 5.08 x 1.84 mm
