k3rnL/open-cinema-hardware/boards/rear-io/models/optical-cradle-A6.step

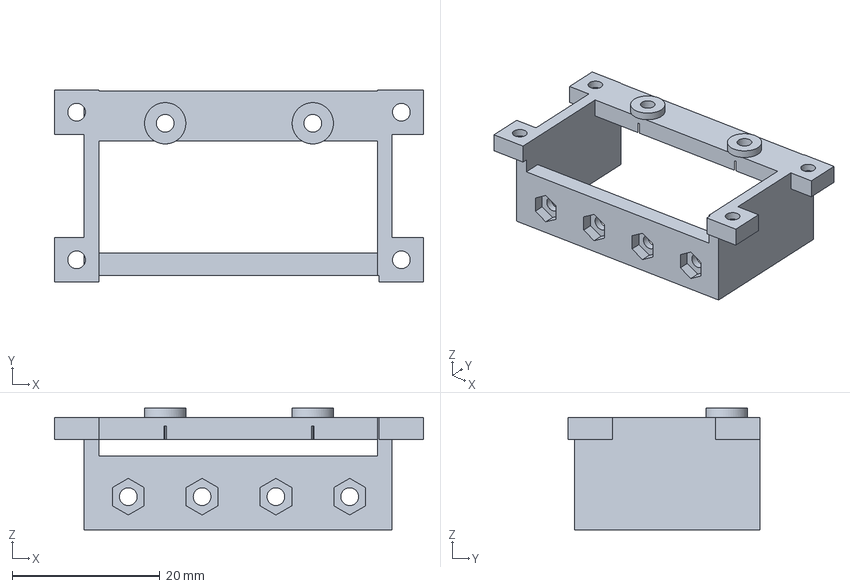
[picture p53: CAD file, 2026-11-03]
boards/rear-io/models/optical-cradle-A6.step
50.0 x 26.0 x 16.5 mm
