k3rnL/open-cinema-hardware/boards/rear-io-A12/models/L_Bourns-SRN4018.step

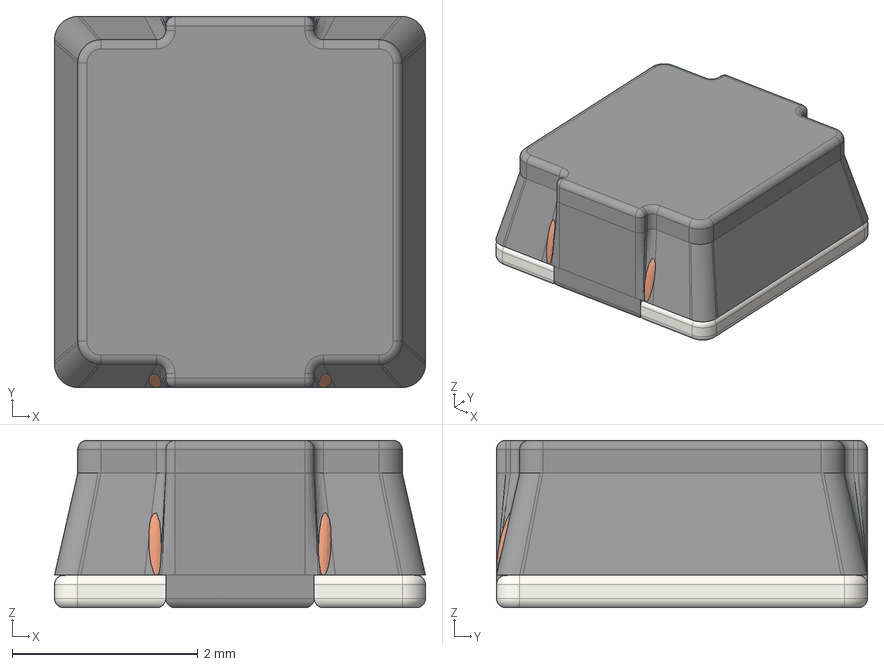
[picture p54: CAD file, 2026-11-04]
boards/rear-io-A12/models/L_Bourns-SRN4018.step
4.00 x 4.00 x 1.80 mm
