k3rnL/open-cinema-hardware/boards/rear-io/exports/rear-io-A8-rigid.step

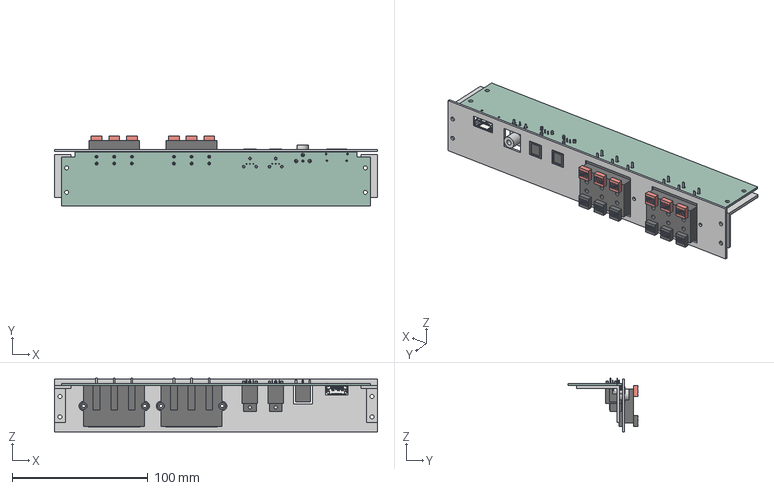
[picture p55: CAD file, 2026-11-03]
boards/rear-io/exports/rear-io-A8-rigid.step
238.0 x 51.4 x 39.5 mm
