k3rnL/open-cinema-hardware/boards/rear-io/models/DragonCity_PT-603B.step

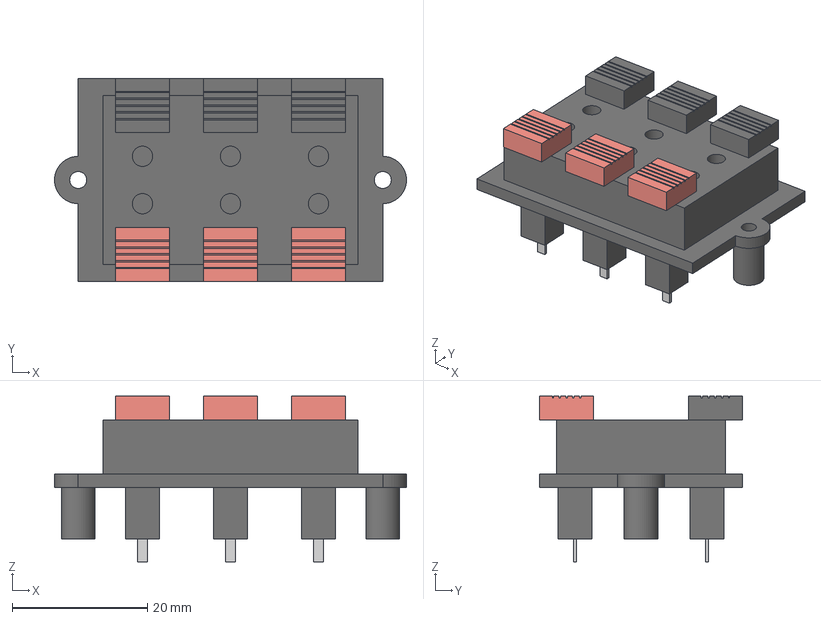
[picture p56: CAD file, 2026-11-03]
boards/rear-io/models/DragonCity_PT-603B.step
52.0 x 30.0 x 24.5 mm
