k3rnL/open-cinema-hardware/boards/rear-io-A12/models/TSSOP-28_4.4x9.7mm_P0.65mm.step

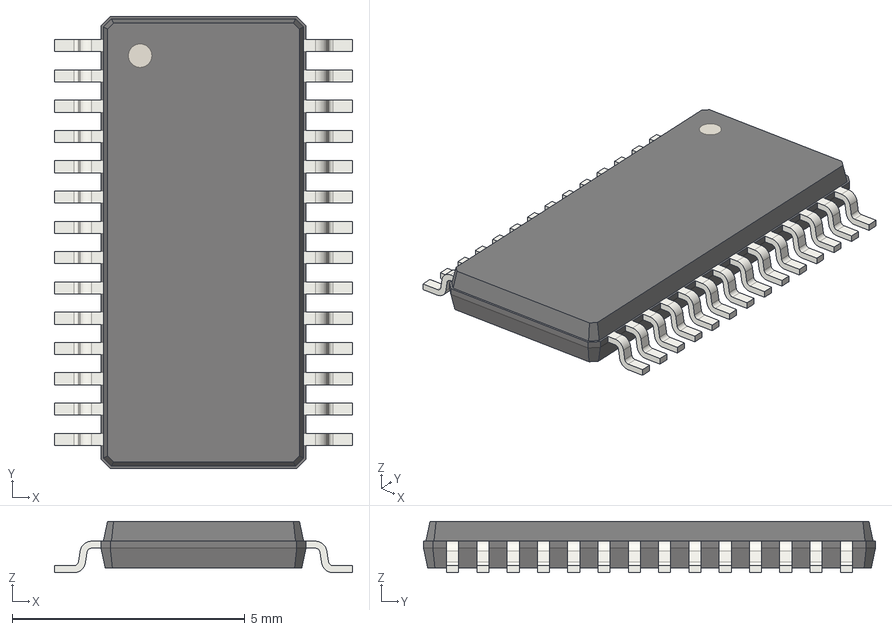
[picture p57: CAD file, 2026-11-03]
boards/rear-io-A12/models/TSSOP-28_4.4x9.7mm_P0.65mm.step
6.40 x 9.70 x 1.10 mm
