k3rnL/open-cinema-hardware/boards/rear-io-A12/models/TSSOP-16_4.4x5mm_P0.65mm.step

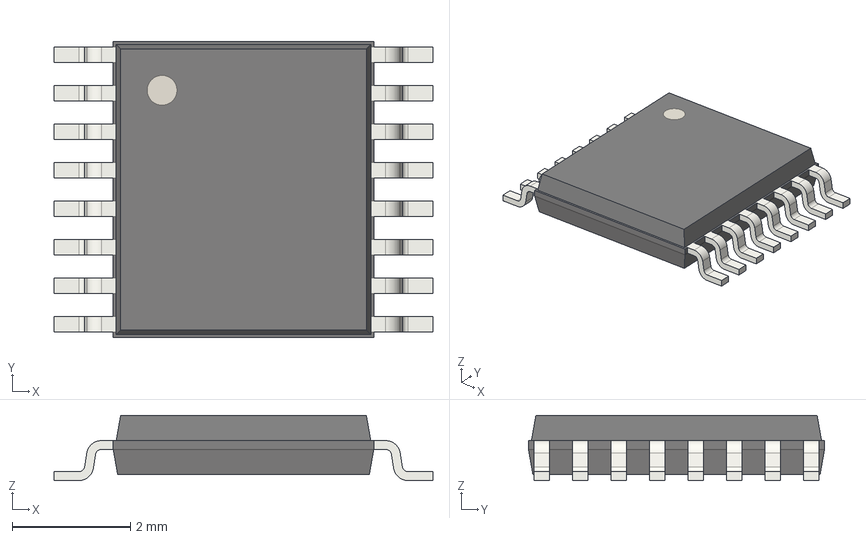
[picture p58: CAD file, 2026-11-03]
boards/rear-io-A12/models/TSSOP-16_4.4x5mm_P0.65mm.step
6.40 x 5.00 x 1.10 mm
