k3rnL/open-cinema-hardware/boards/rear-io/exports/rear-io-A7-board-only.step

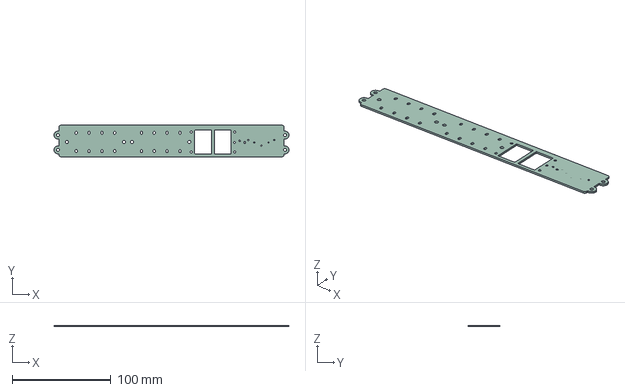
[picture p59: CAD file, 2026-11-03]
boards/rear-io/exports/rear-io-A7-board-only.step
238.0 x 32.0 x 1.51 mm
