k3rnL/open-cinema-hardware/boards/rear-io-A12/models/PinHeader_2x06_P2.54mm_Vertical.step

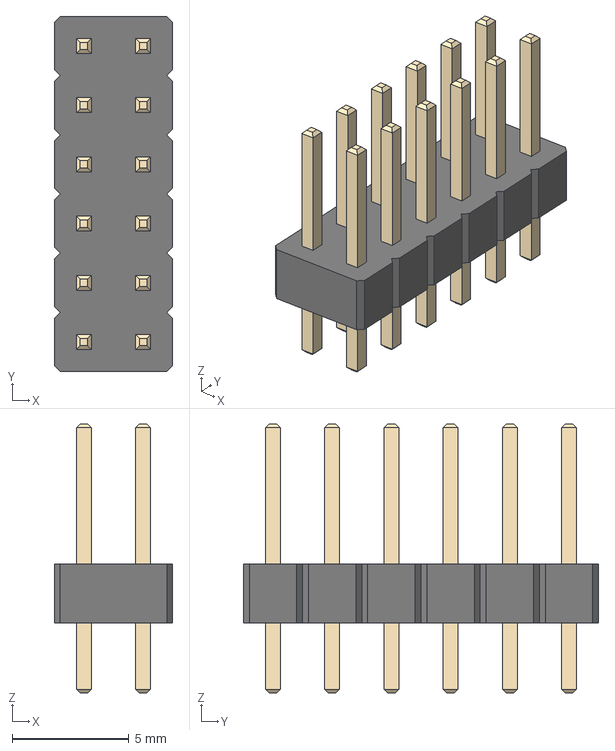
[picture p60: CAD file, 2026-11-03]
boards/rear-io-A12/models/PinHeader_2x06_P2.54mm_Vertical.step
5.08 x 15.2 x 11.5 mm
