k3rnL/open-cinema-hardware/boards/rear-io-A12/models/PinHeader_1x02_P2.54mm_Vertical.step

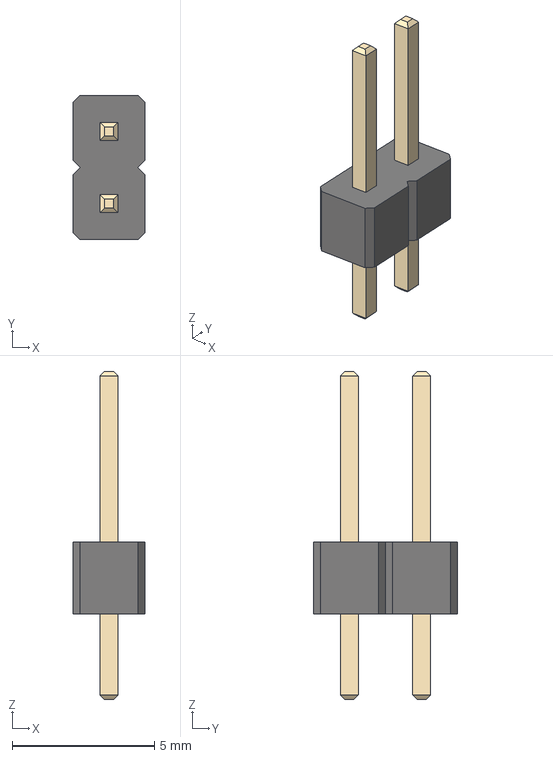
[picture p61: CAD file, 2026-11-03]
boards/rear-io-A12/models/PinHeader_1x02_P2.54mm_Vertical.step
2.54 x 5.08 x 11.5 mm
