k3rnL/open-cinema-hardware/boards/rear-io/exports/rear-io-A7-outline.dxf

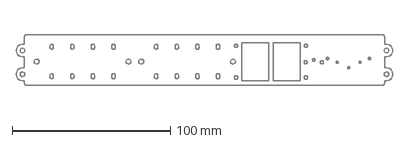
[picture p62: CAD file, 2026-11-03]
boards/rear-io/exports/rear-io-A7-outline.dxf
238.0 x 32.0 mm
