k3rnL/open-cinema-hardware/boards/rear-io-A12/models/R_0603_1608Metric.step

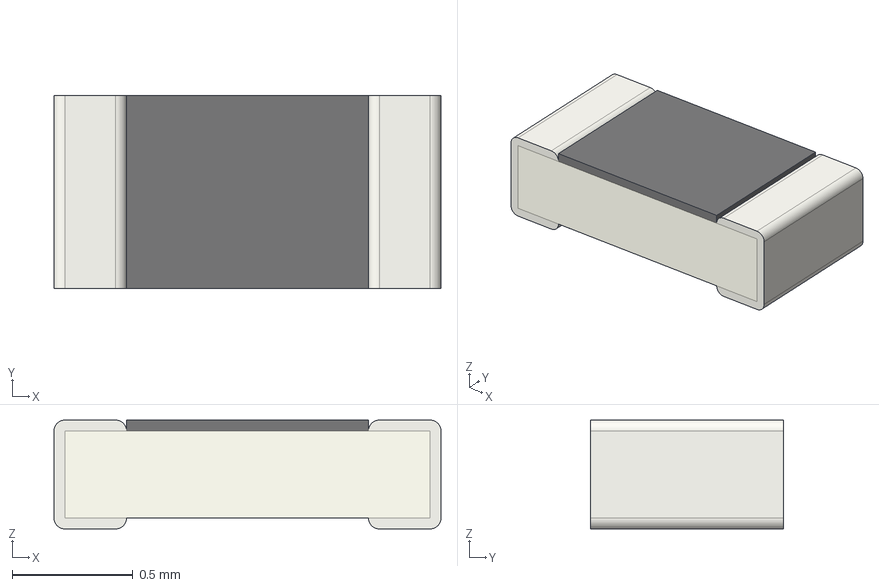
[picture p63: CAD file, 2026-11-03]
boards/rear-io-A12/models/R_0603_1608Metric.step
1.60 x 0.8 x 0.45 mm
