k3rnL/open-cinema-hardware/boards/rear-io/models/RCJ-021.step

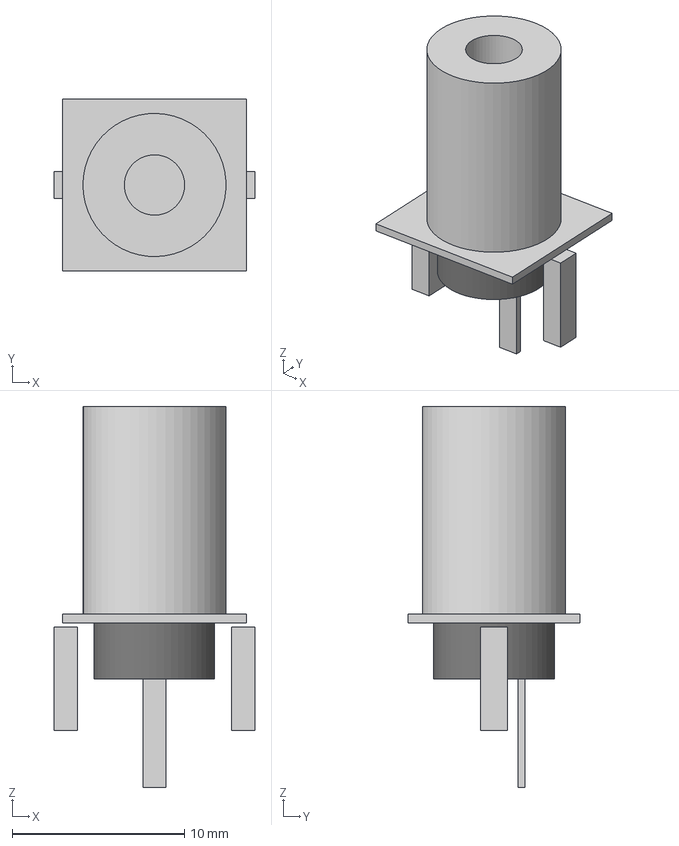
[picture p64: CAD file, 2026-11-03]
boards/rear-io/models/RCJ-021.step
11.7 x 10.0 x 22.1 mm
