k3rnL/open-cinema-hardware/boards/rear-io-A12/models/PinHeader_2x10_P2.54mm_Vertical.step

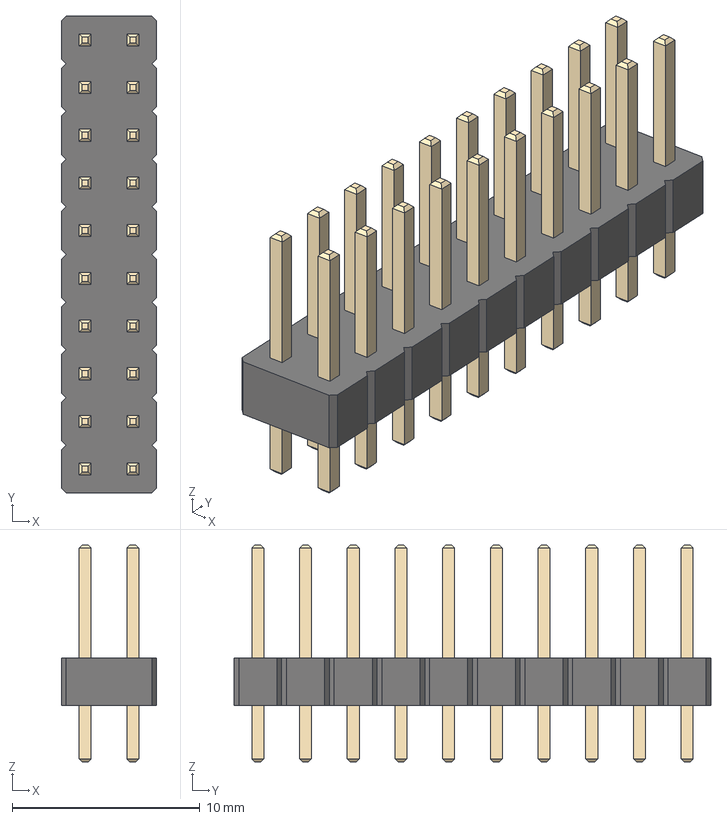
[picture p65: CAD file, 2026-11-03]
boards/rear-io-A12/models/PinHeader_2x10_P2.54mm_Vertical.step
5.08 x 25.4 x 11.5 mm
