k3rnL/open-cinema-hardware/boards/rear-io/exports/rear-io-A6-outline.dxf

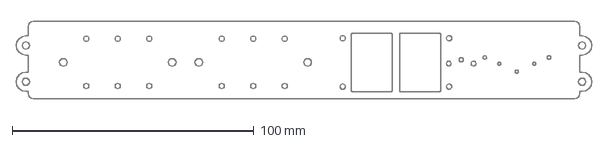
[picture p66: CAD file, 2026-11-03]
boards/rear-io/exports/rear-io-A6-outline.dxf
238.0 x 32.0 mm
