k3rnL/open-cinema-hardware/boards/rear-io-A12/models/L_0603_1608Metric.step

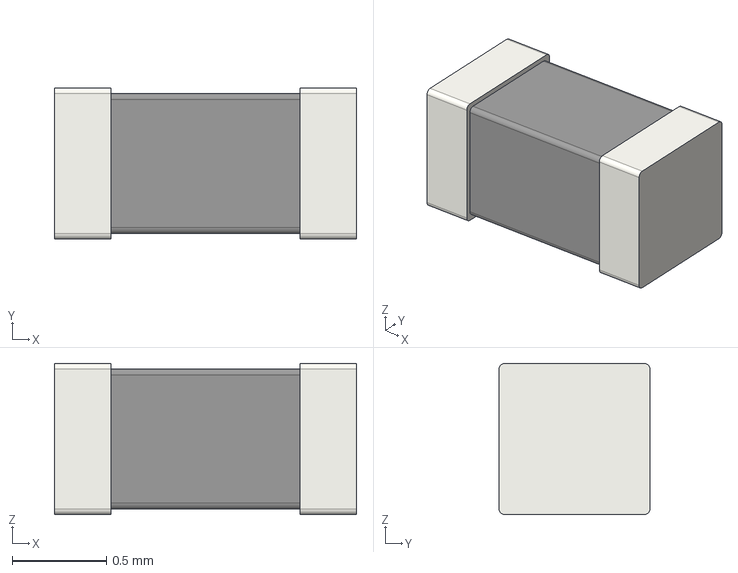
[picture p67: CAD file, 2026-11-03]
boards/rear-io-A12/models/L_0603_1608Metric.step
1.60 x 0.8 x 0.8 mm
