k3rnL/open-cinema-hardware/boards/rear-io/models/coax.step

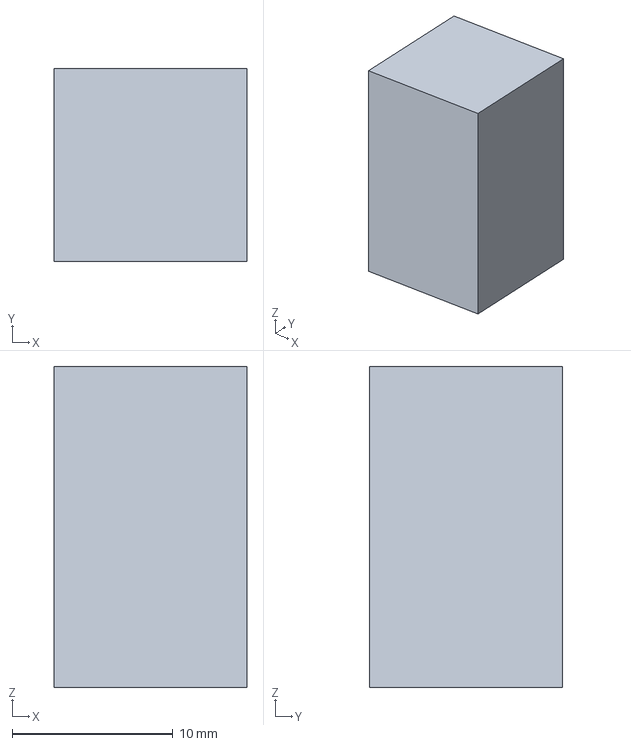
[picture p68: CAD file, 2026-11-03]
boards/rear-io/models/coax.step
12.0 x 12.0 x 20.0 mm
