k3rnL/open-cinema-hardware/boards/rear-io/models/optical.step

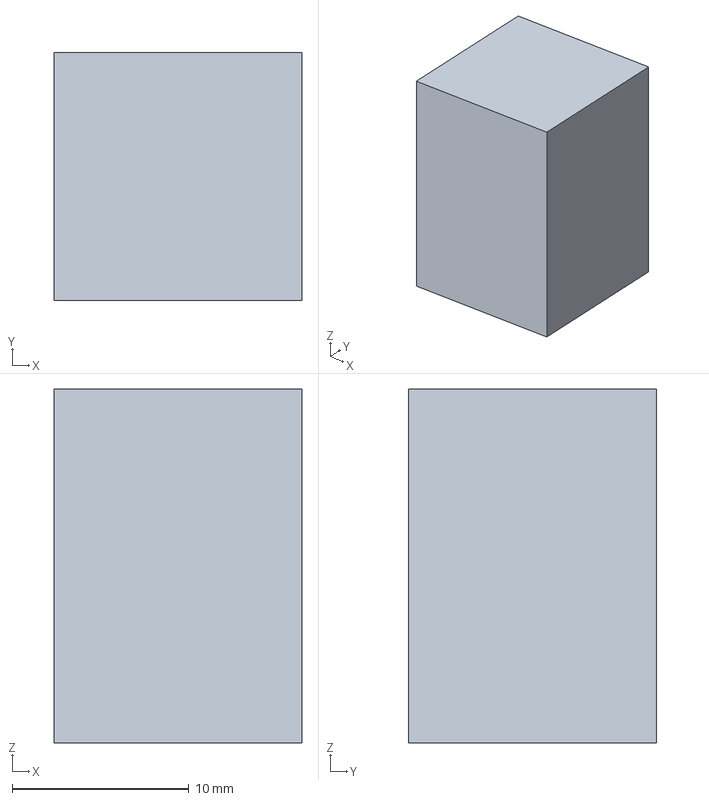
[picture p69: CAD file, 2026-11-03]
boards/rear-io/models/optical.step
14.0 x 14.0 x 20.0 mm
