k3rnL/open-cinema-hardware/boards/rear-io/models/speaker.step

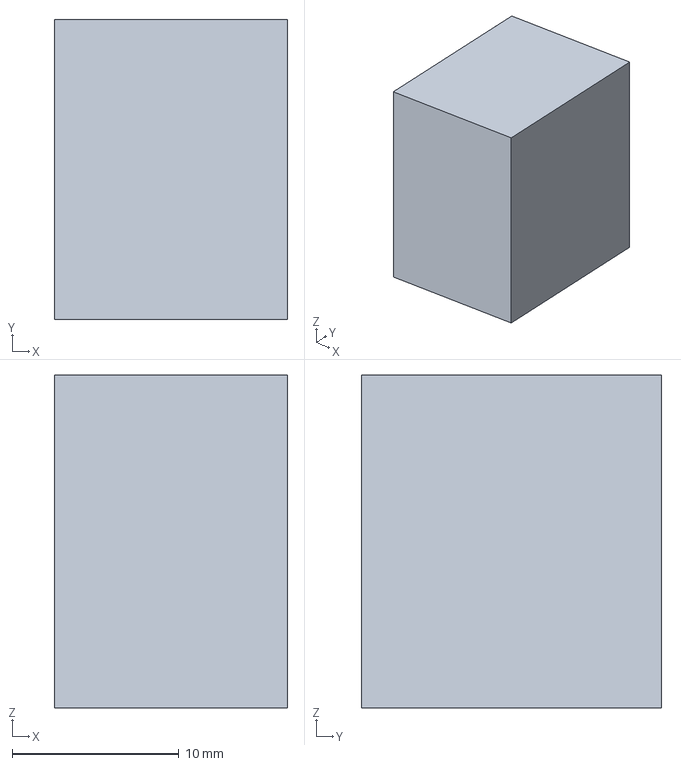
[picture p70: CAD file, 2026-11-03]
boards/rear-io/models/speaker.step
14.0 x 18.0 x 20.0 mm
