k3rnL/open-cinema-hardware/boards/rear-io/models/hdmi.step

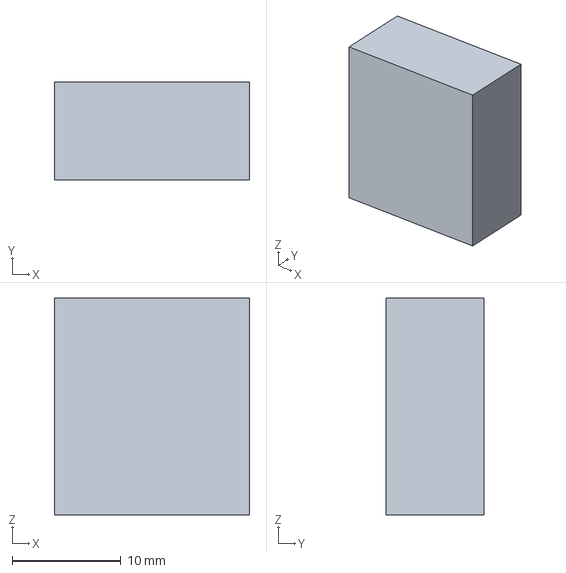
[picture p71: CAD file, 2026-11-03]
boards/rear-io/models/hdmi.step
18.0 x 9.00 x 20.0 mm
