k3rnL/open-cinema-hardware/boards/rear-io/exports/rear-io-A4-outline.dxf

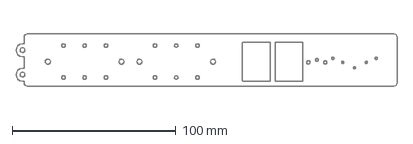
[picture p73: CAD file, 2026-11-03]
boards/rear-io/exports/rear-io-A4-outline.dxf
233.0 x 32.0 mm
