k3rnL/open-cinema-hardware/boards/rear-io/exports/rear-io-A4-board-only.step

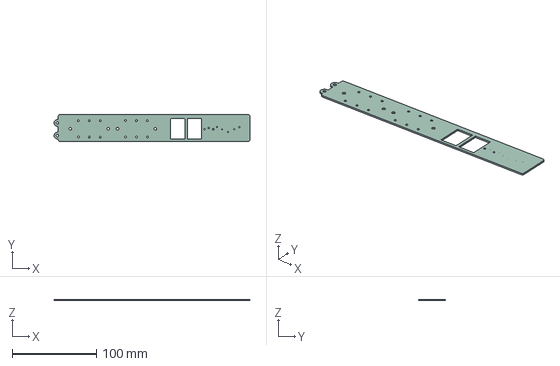
[picture p74: CAD file, 2026-11-03]
boards/rear-io/exports/rear-io-A4-board-only.step
233.0 x 32.0 x 1.51 mm
