k3rnL/open-cinema-hardware/boards/rear-io/exports/rear-io-A2-outline.dxf

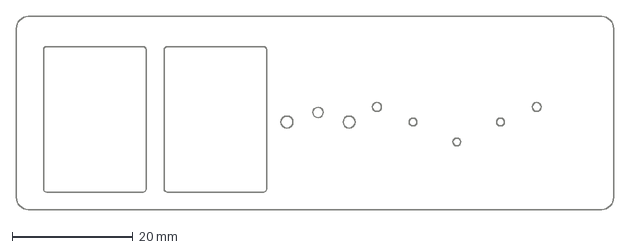
[picture p76: CAD file, 2026-11-03]
boards/rear-io/exports/rear-io-A2-outline.dxf
99.0 x 32.0 mm
