k3rnL/open-cinema-hardware/boards/rear-io/exports/rear-io-A1-outline.dxf

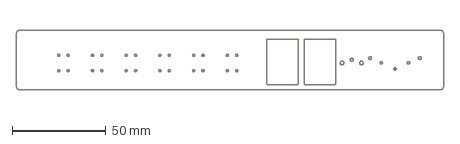
[picture p78: CAD file, 2026-11-03]
boards/rear-io/exports/rear-io-A1-outline.dxf
228.0 x 32.0 mm
