k3rnL/open-cinema-hardware/boards/rear-io/exports/rear-io-A0-outline.dxf

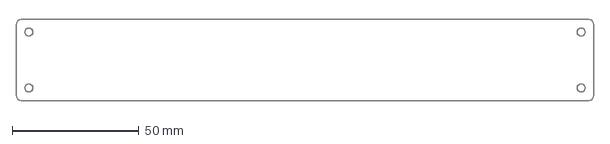
[picture p79: CAD file, 2026-11-03]
boards/rear-io/exports/rear-io-A0-outline.dxf
228.0 x 32.0 mm
