k3rnL/open-cinema-hardware/boards/rear-io/exports/rear-io-A0-board-only.step

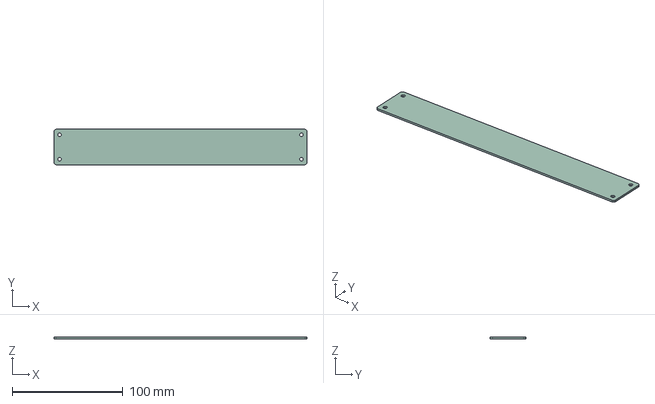
[picture p80: CAD file, 2026-11-03]
boards/rear-io/exports/rear-io-A0-board-only.step
228.0 x 32.0 x 1.51 mm
