k3rnL/open-cinema-hardware/boards/rear-io/exports/rear-io-A0-envelopes.step

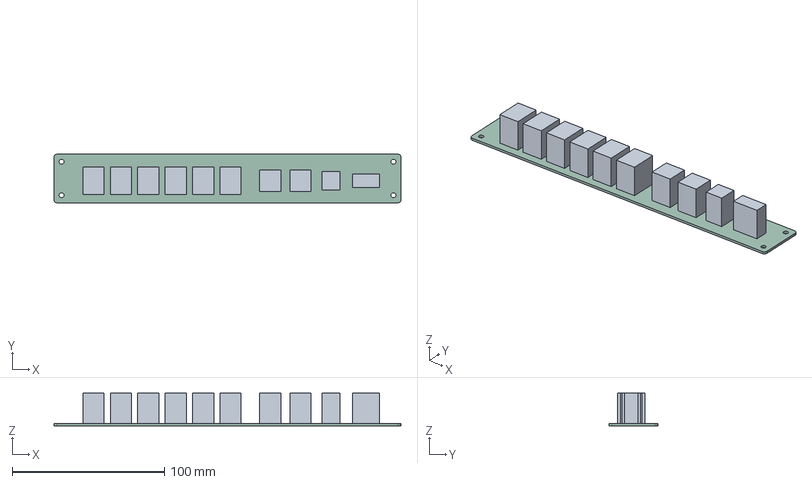
[picture p81: CAD file, 2026-11-03]
boards/rear-io/exports/rear-io-A0-envelopes.step
228.0 x 32.0 x 21.6 mm
speaker x 6
hdmi
optical x 2
coax
rear-io_PCB
