k3rnL/open-cinema-hardware/(list of files, cad)

Other CAD files:
boards/rear-io/exports/rear-io-A3-assembly.step
boards/optical-input/optical-input-A7.step
boards/rear-io/exports/rear-io-A9-rigid.step
boards/optical-input/optical-input-A6.step
boards/optical-input/optical-input-A1.step
boards/rear-io/exports/rear-io-A8-board-rigid.step
boards/rear-io/models/optical-daughterboard-supported-A6.step
boards/rear-io/models/KLS1-WP-6P-03B.step
boards/rear-io/exports/rear-io-A7-rigid.step
boards/rear-io/exports/rear-io-A6-board-only.step
boards/rear-io-A12/models/C_0603_1608Metric.step
boards/rear-io/exports/rear-io-A6-rigid.step
boards/rear-io/exports/rear-io-A5-board-only.step
boards/rear-io/exports/rear-io-A3-board-only.step
boards/rear-io/exports/rear-io-A1-board-only.step
boards/rear-io-A10/exports/rear-io-A10-rigid.f3d
boards/rear-io-A11/exports/rear-io-A11-rigid.f3d
boards/rear-io-A12/exports/rear-io-A12-rigid.f3d
boards/rear-io/exports/rear-io-A6-rigid.f3d
boards/rear-io/exports/rear-io-A7-rigid.f3d
boards/rear-io/exports/rear-io-A8-legacy-frame.step
boards/rear-io/exports/rear-io-A8-rigid.f3d
boards/rear-io/exports/rear-io-A9-legacy-frame.step
boards/rear-io/exports/rear-io-A9-rigid.f3d
boards/rear-io/models/10078837-001LF.step
boards/rear-io/models/1732496.step
boards/rear-io/models/FCR684205R.step
boards/rear-io/models/optical-cradle-A6.stl
