k3rnL/open-cinema-hardware/boards/rear-io-A10/exports/rear-io-A10-installed-front.png

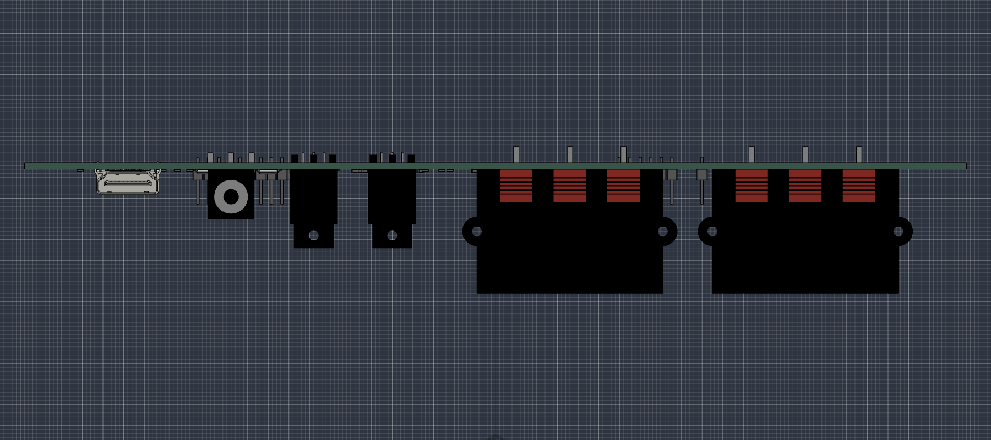
boards/rear-io-A10/exports/rear-io-A10-installed-front.png
