k3rnL/open-cinema-hardware/boards/rear-io-A11/exports/rear-io-A11-installed-front.png

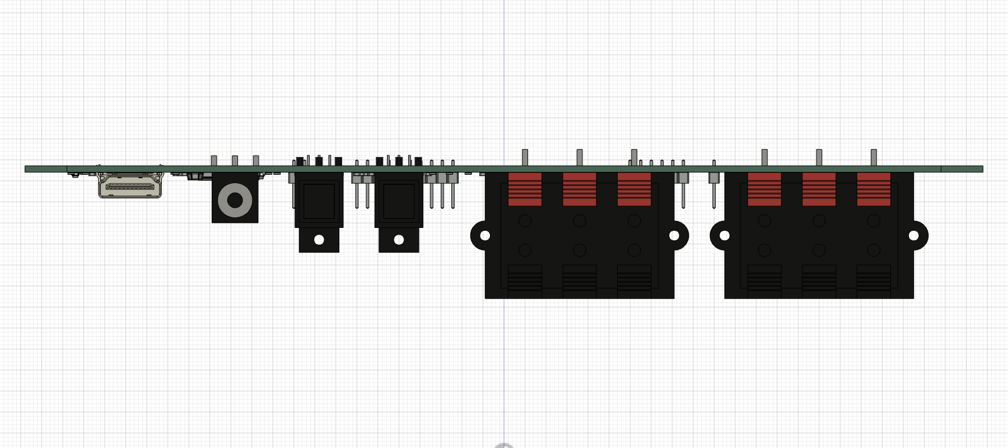
boards/rear-io-A11/exports/rear-io-A11-installed-front.png
