k3rnL/open-cinema-hardware/boards/rear-io/exports/rear-io-A8-installed-oblique.png

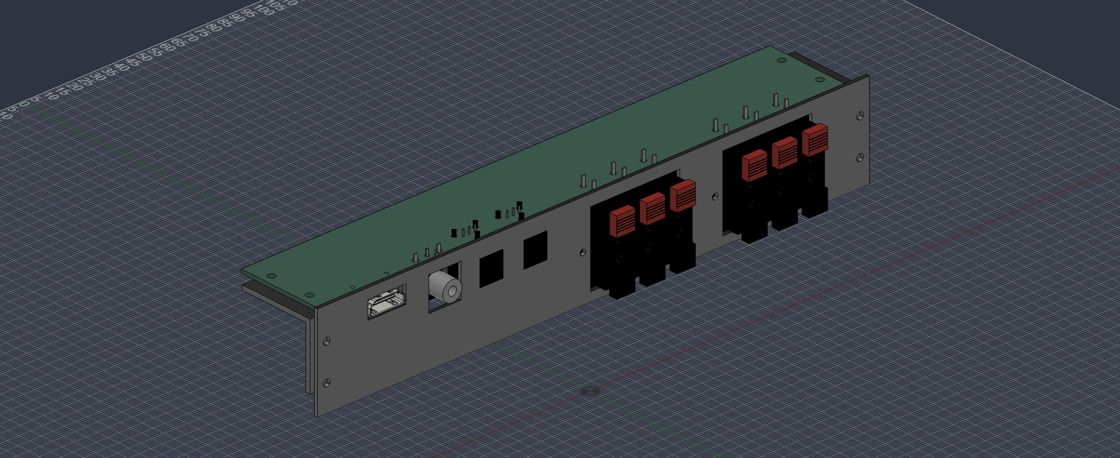
boards/rear-io/exports/rear-io-A8-installed-oblique.png
