k3rnL/open-cinema-hardware/boards/rear-io-A12/rear-io-A12.kicad_pcb

## KiCad design boards/rear-io-A12/rear-io-A12.kicad_pcb (2026-11-04)

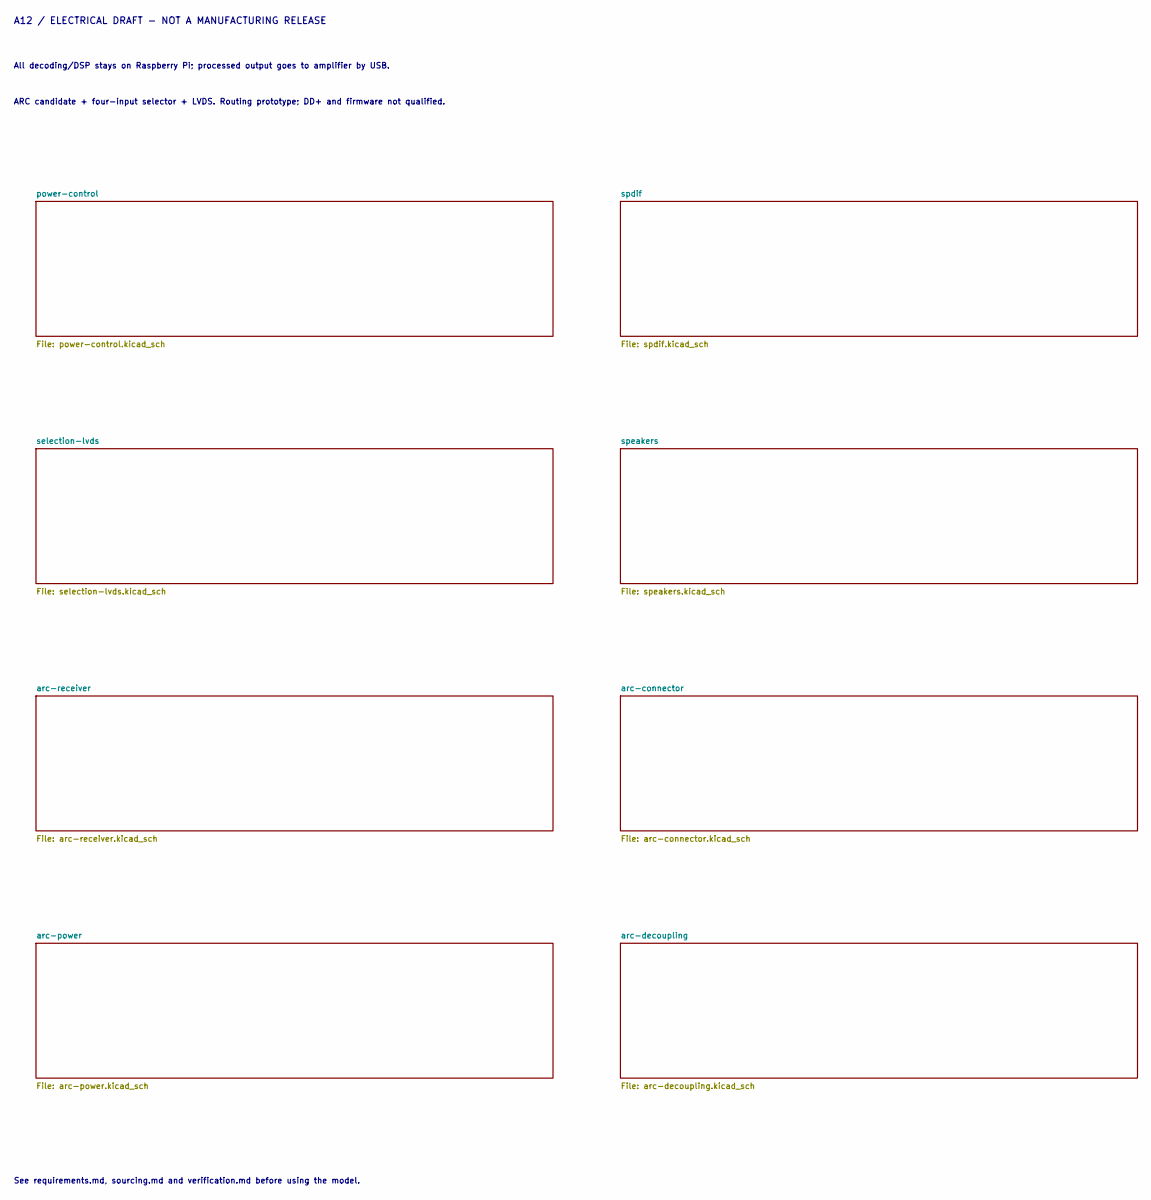
[picture p106: schematic rear-io-A12.kicad_sch, Open Cinema rear I/O electrical study]

Notes on the sheet:
A12 / ELECTRICAL DRAFT - NOT A MANUFACTURING RELEASE
All decoding/DSP stays on Raspberry Pi; processed output goes to amplifier by USB.
ARC candidate + four-input selector + LVDS. Routing prototype; DD+ and firmware not qualified.
See requirements.md, sourcing.md and verification.md before using the model.

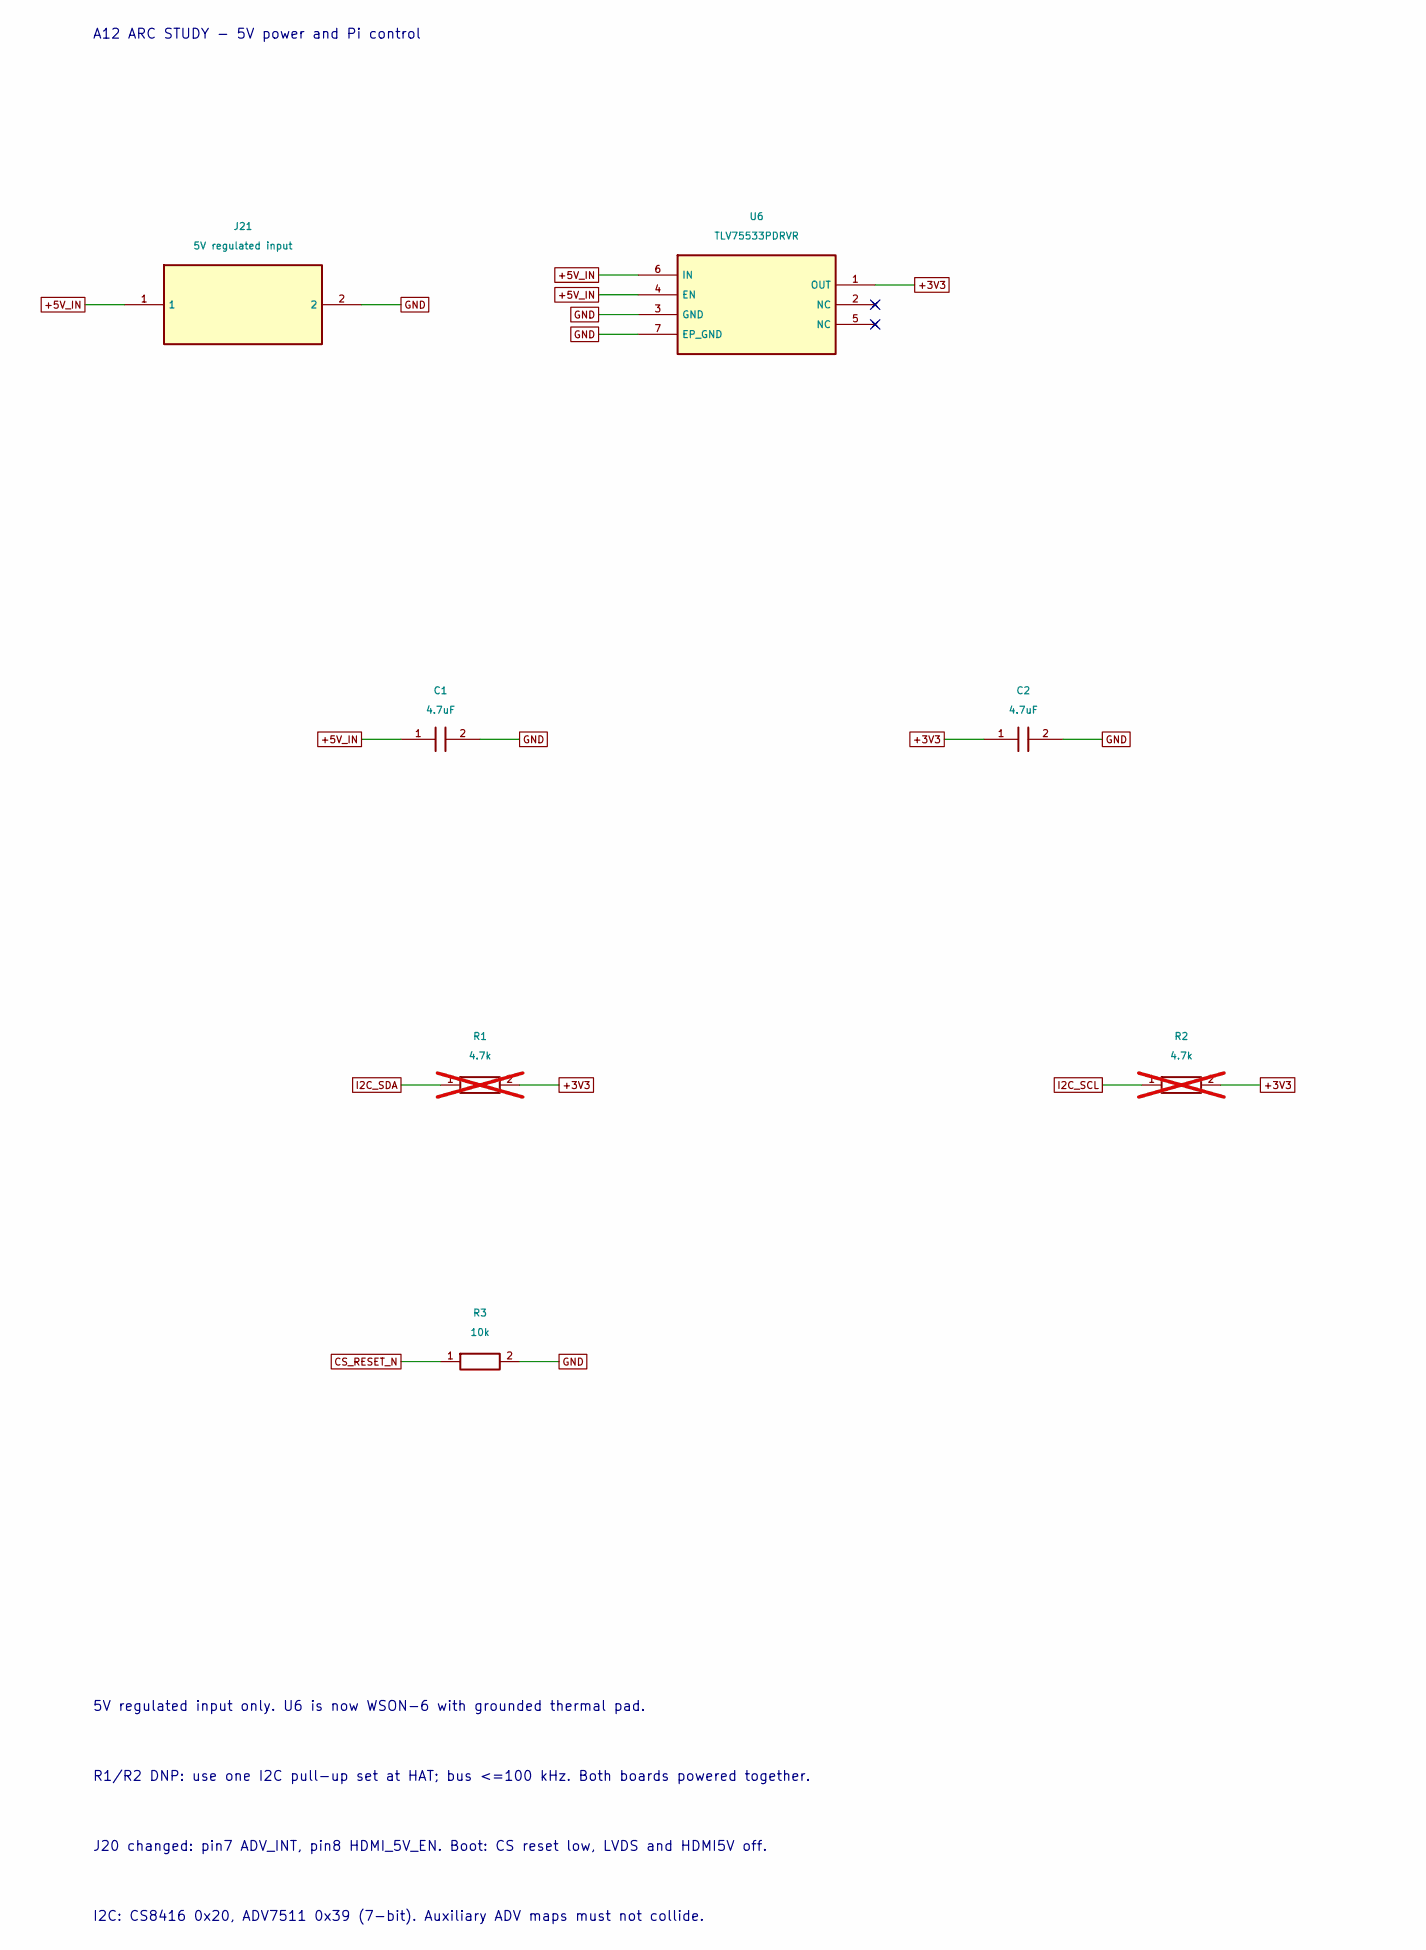
[picture p107: schematic power-control.kicad_sch, Open Cinema - power-control, part in row 1, column 1]

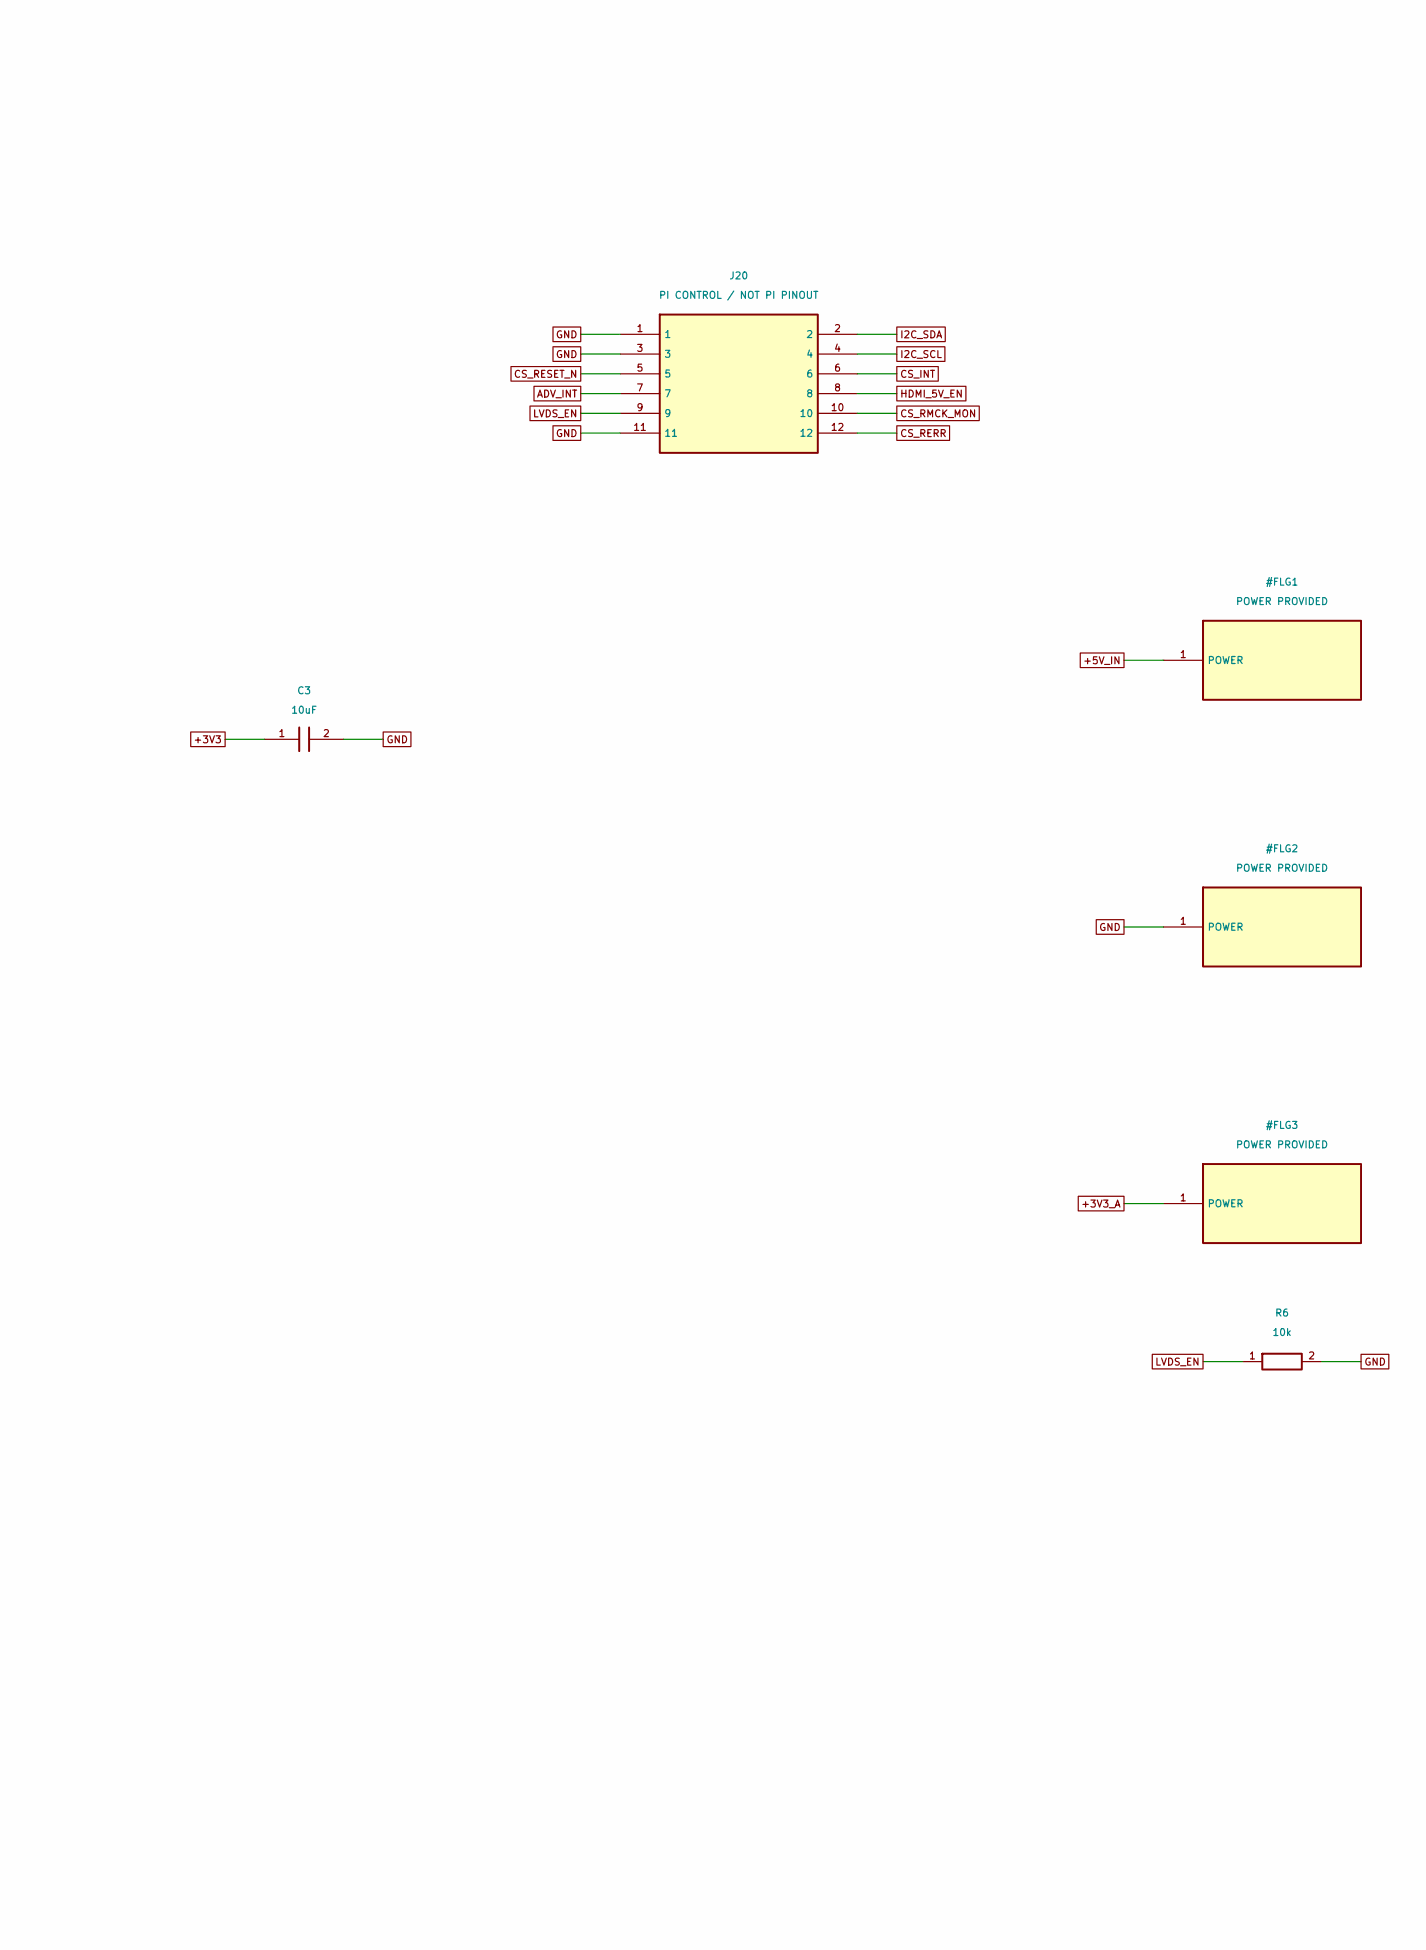
[picture p108: schematic power-control.kicad_sch, Open Cinema - power-control, part in row 1, column 2]

Parts:
C1, C2: 4.7uF; C_0603_1608Metric; MPN CL10A475KO8NNNC
C3: 10uF; C_0603_1608Metric; MPN CL10A106KP8NNNC
J20: PI CONTROL / NOT PI PINOUT; PinHeader_2x06_P2.54mm_Vertical; MPN TSW-106-07-G-D
J21: 5V regulated input; PinHeader_1x02_P2.54mm_Vertical; MPN TSW-102-07-G-S
R1, R2: 4.7k; R_0603_1608Metric; MPN RC0603FR-074K7L; not fitted
R3, R6: 10k; R_0603_1608Metric; MPN RC0603FR-0710KL
U6: TLV75533PDRVR; WSON-6-1EP_2x2mm_P0.65mm_EP1x1.6mm; MPN TLV75533PDRVR

Connections:
+3V3: C2.1, C3.1, R1.2, R2.2, U6.1 (OUT); also elsewhere on the board
+5V_IN: C1.1, J21.1, U6.4 (EN), U6.6 (IN); also elsewhere on the board
ADV_INT: J20.7; also elsewhere on the board
CS_INT: J20.6; also elsewhere on the board
CS_RERR: J20.12; also elsewhere on the board
CS_RESET_N: J20.5, R3.1; also elsewhere on the board
CS_RMCK_MON: J20.10; also elsewhere on the board
GND: C1.2, C2.2, C3.2, J20.1, J20.3, J20.11, J21.2, R3.2, R6.2, U6.3 (GND), U6.7 (EP_GND); also elsewhere on the board
HDMI_5V_EN: J20.8; also elsewhere on the board
I2C_SCL: J20.4, R2.1; also elsewhere on the board
I2C_SDA: J20.2, R1.1; also elsewhere on the board
LVDS_EN: J20.9, R6.1; also elsewhere on the board

Notes on the sheet:
A12 ARC STUDY - 5V power and Pi control
5V regulated input only. U6 is now WSON-6 with grounded thermal pad.
R1/R2 DNP: use one I2C pull-up set at HAT; bus <=100 kHz. Both boards powered together.
J20 changed: pin7 ADV_INT, pin8 HDMI_5V_EN. Boot: CS reset low, LVDS and HDMI5V off.
I2C: CS8416 0x20, ADV7511 0x39 (7-bit). Auxiliary ADV maps must not collide.

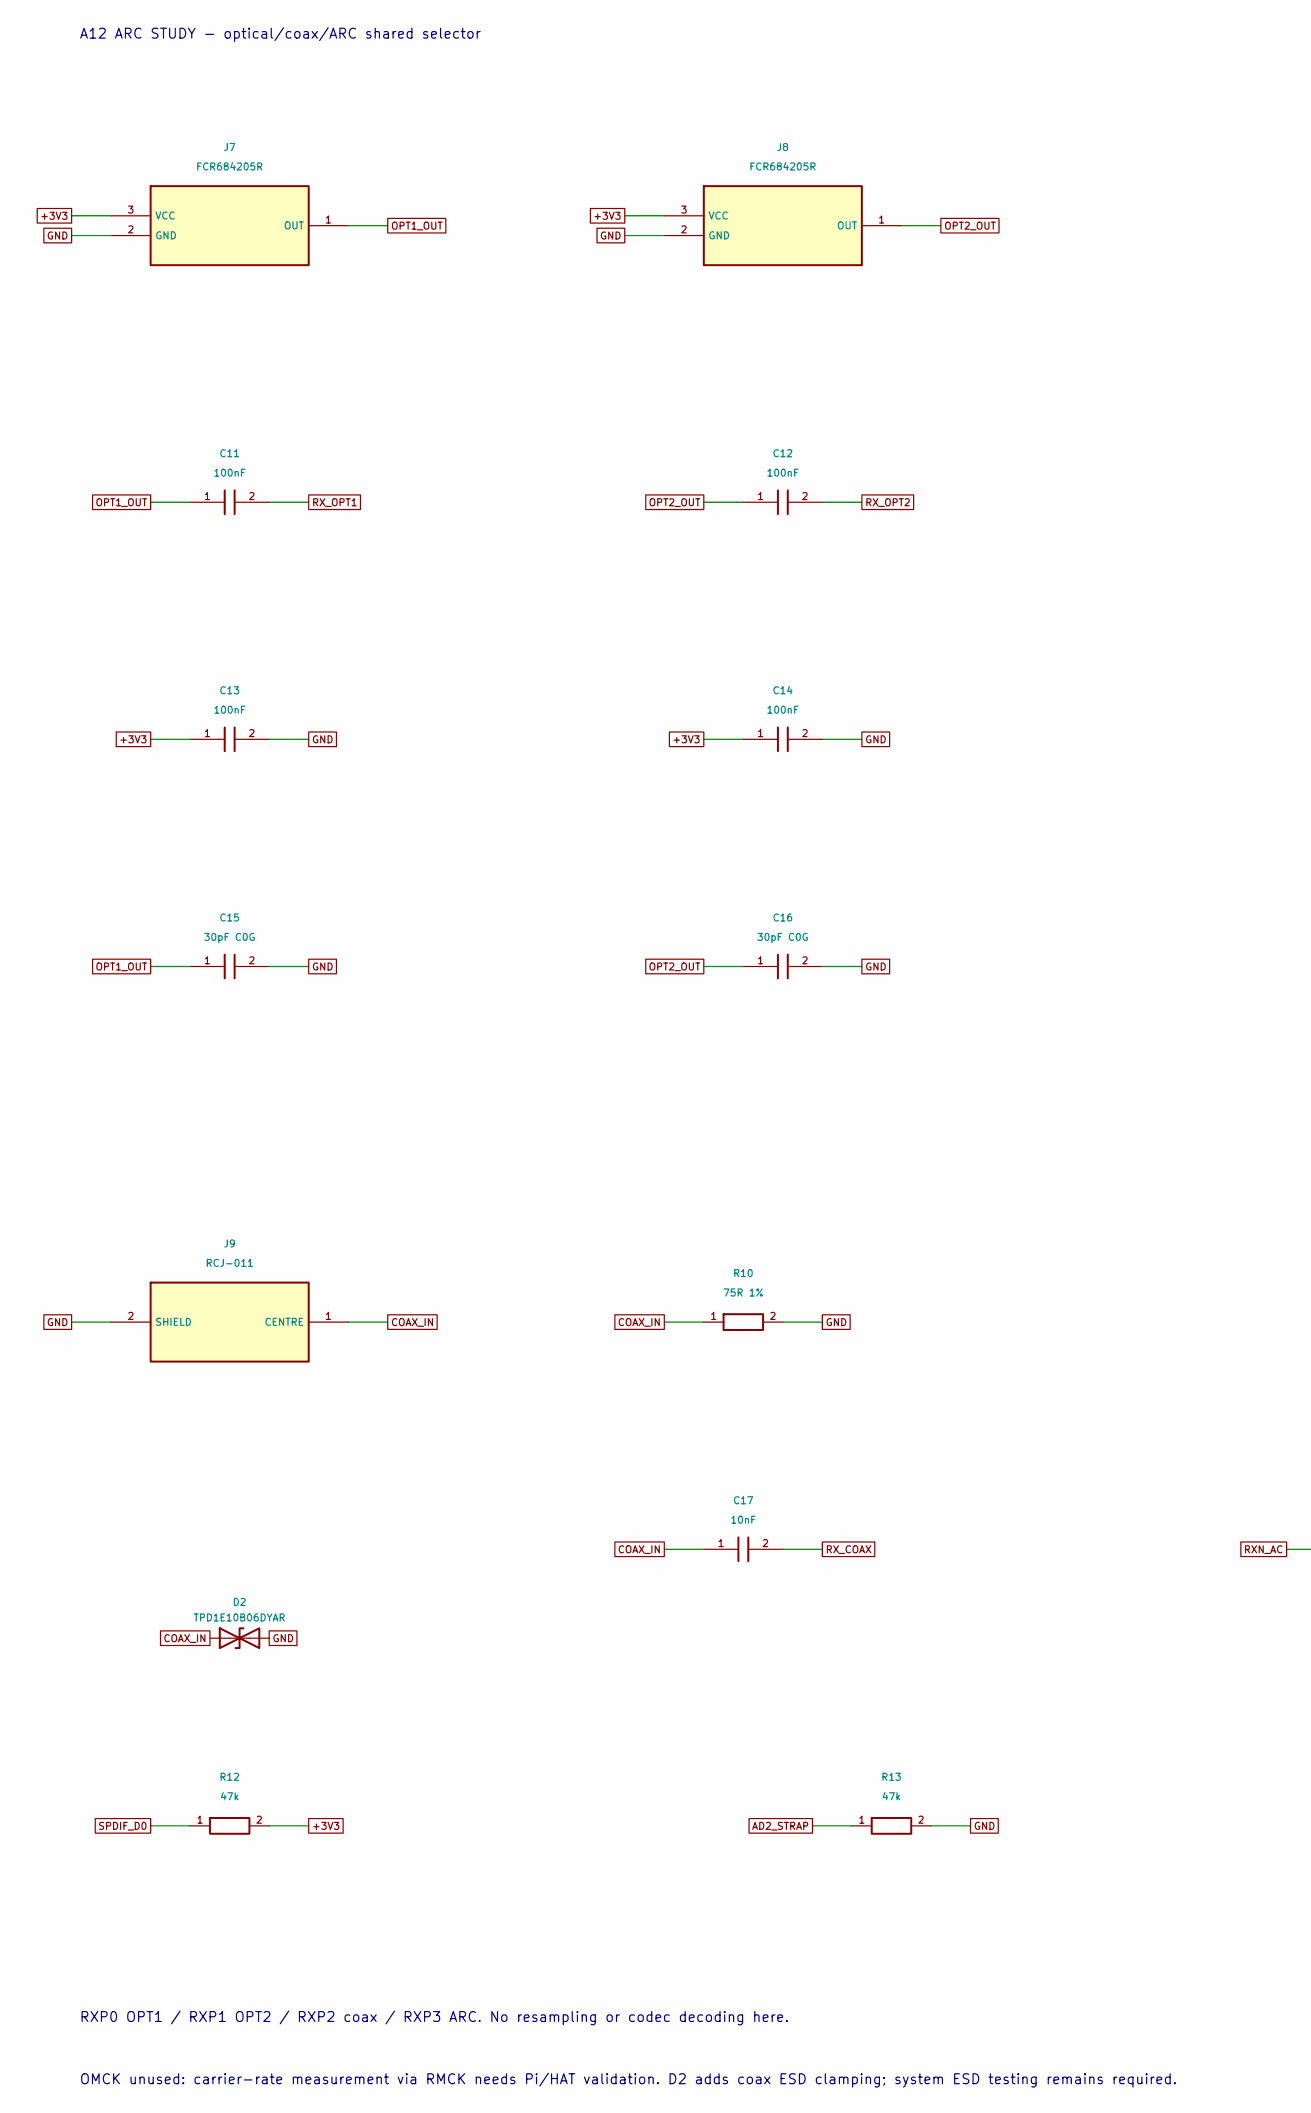
[picture p109: schematic spdif.kicad_sch, Open Cinema - spdif, part in row 1, column 1]

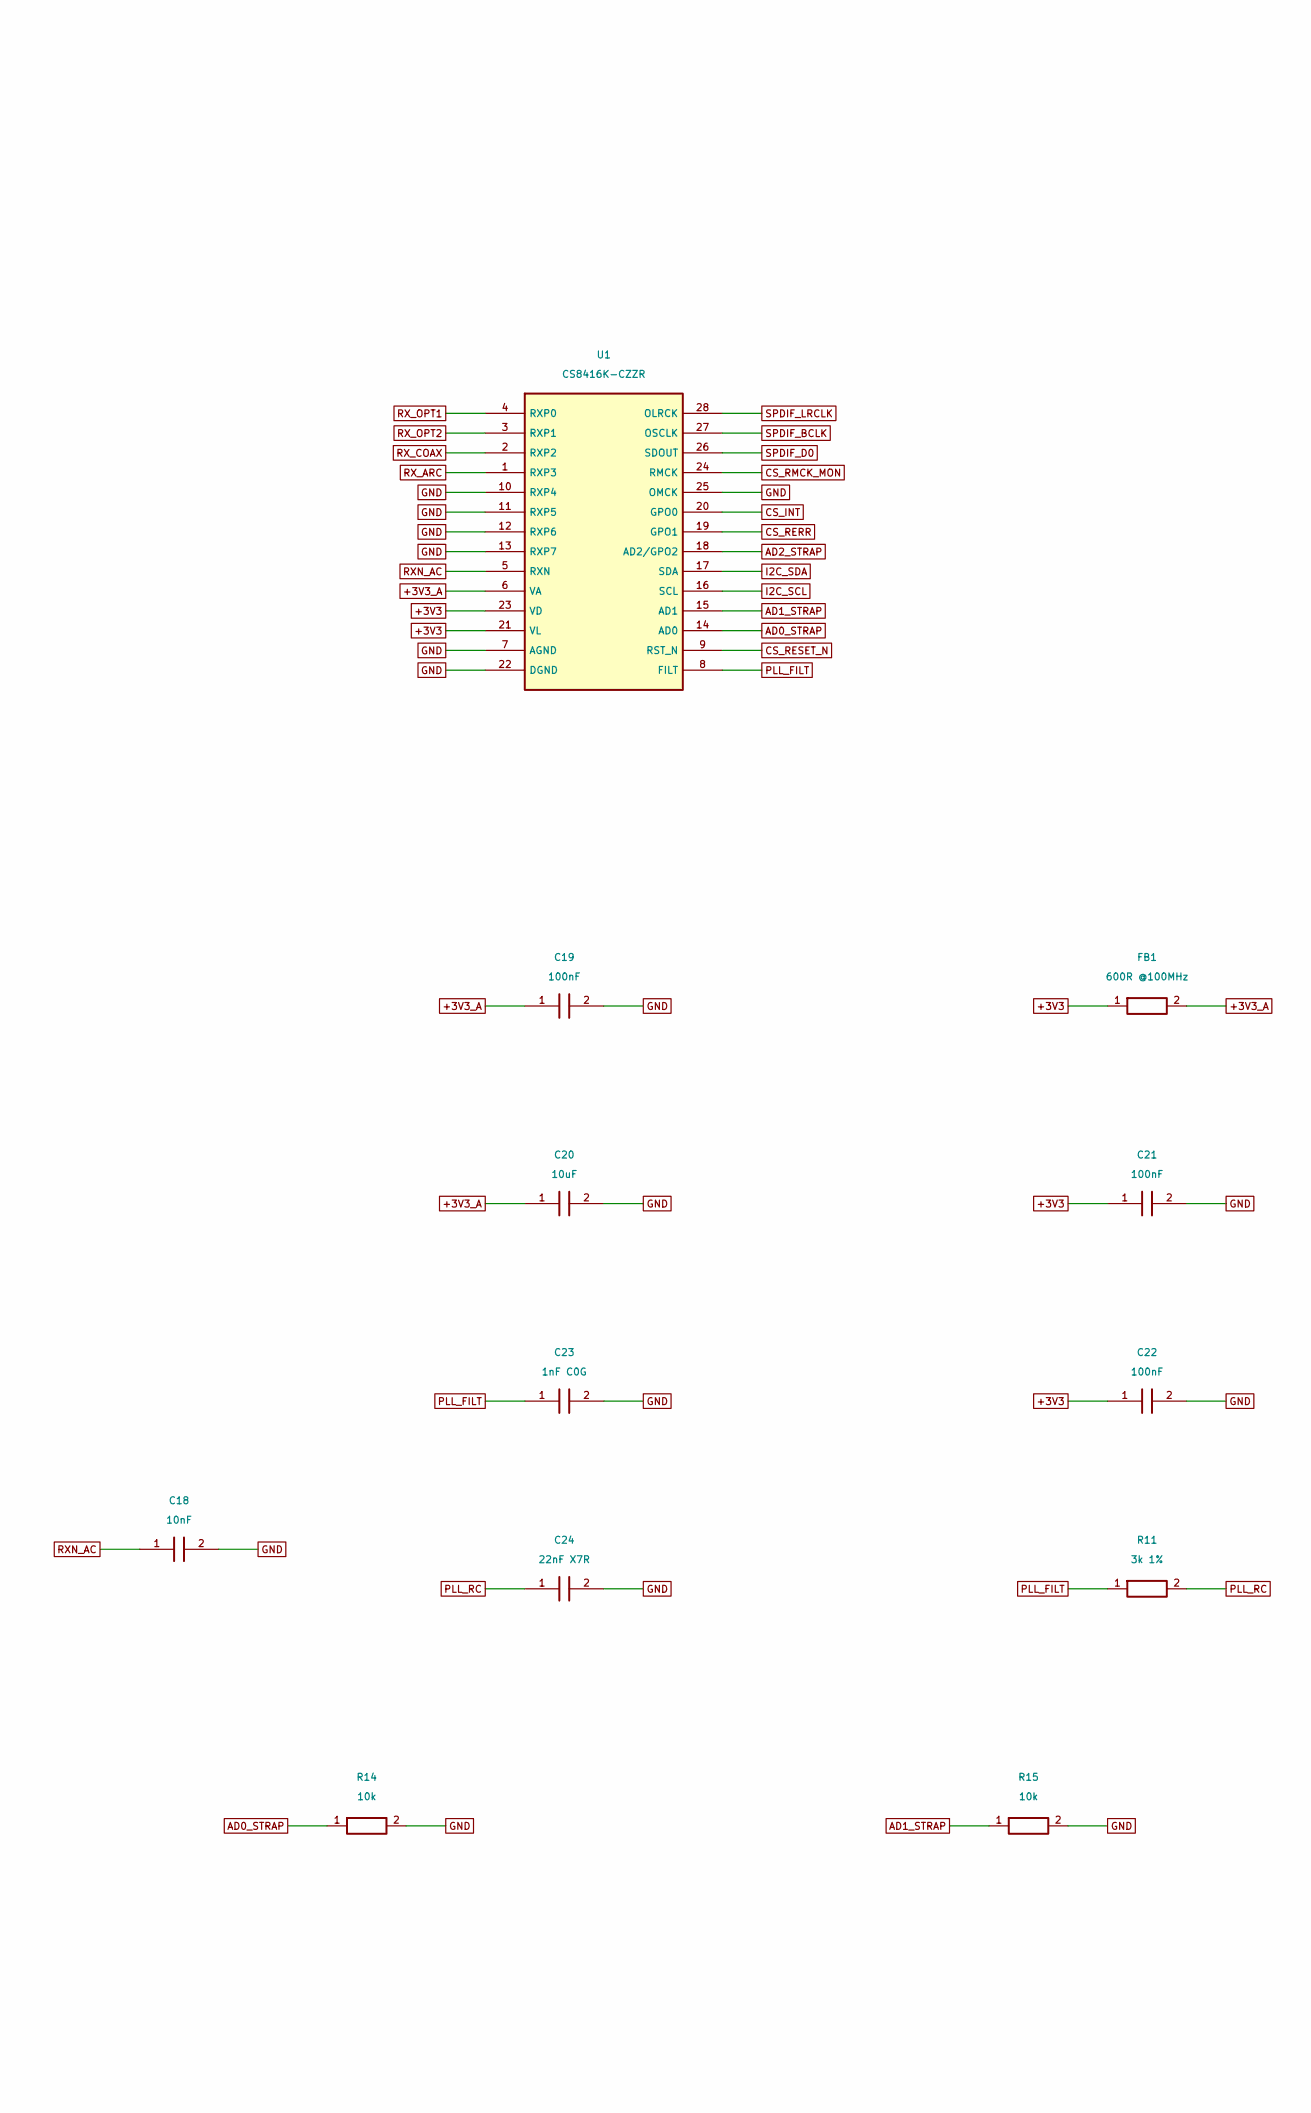
[picture p110: schematic spdif.kicad_sch, Open Cinema - spdif, part in row 1, column 2]

Parts:
C11, C12, C13, C14, C19, C21, C22: 100nF; C_0603_1608Metric; MPN CL10B104KB8NNNC
C15, C16: 30pF C0G; C_0603_1608Metric; MPN CL10C300JB8NNNC
C17, C18: 10nF; C_0603_1608Metric; MPN CL10B103KB8NNNC
C20: 10uF; C_0603_1608Metric; MPN CL10A106KP8NNNC
C23: 1nF C0G; C_0603_1608Metric; MPN CL10C102JB8NNNC
C24: 22nF X7R; C_0603_1608Metric; MPN CL10B223KB8NNNC
D2: TPD1E10B06DYAR; D_SOD-523; MPN TPD1E10B06DYAR
FB1: 600R @100MHz; L_0603_1608Metric; MPN BLM18AG601SN1D
J7, J8: FCR684205R; Cliff_FCR684205R; MPN FCR684205R
J9: RCJ-011; SameSky_RCJ_011_Horizontal_A8; MPN RCJ-011
R10: 75R 1%; R_0603_1608Metric; MPN RC0603FR-0775RL
R11: 3k 1%; R_0603_1608Metric; MPN RC0603FR-073KL
R12, R13: 47k; R_0603_1608Metric; MPN RC0603FR-0747KL
R14, R15: 10k; R_0603_1608Metric; MPN RC0603FR-0710KL
U1: CS8416K-CZZR; TSSOP-28_4.4x9.7mm_P0.65mm; MPN CS8416K-CZZR

Connections:
+3V3: C13.1, C14.1, C21.1, C22.1, FB1.1, J7.3 (VCC), J8.3 (VCC), R12.2, U1.21 (VL), U1.23 (VD); also elsewhere on the board
+3V3_A: C19.1, C20.1, FB1.2, U1.6 (VA)
AD0_STRAP: R14.1, U1.14 (AD0)
AD1_STRAP: R15.1, U1.15 (AD1)
AD2_STRAP: R13.1, U1.18 (AD2/GPO2)
COAX_IN: C17.1, D2.1 (A1), J9.1 (CENTRE), R10.1
CS_INT: U1.20 (GPO0); also elsewhere on the board
CS_RERR: U1.19 (GPO1); also elsewhere on the board
CS_RESET_N: U1.9 (RST_N); also elsewhere on the board
CS_RMCK_MON: U1.24 (RMCK); also elsewhere on the board
GND: C13.2, C14.2, C15.2, C16.2, C18.2, C19.2, C20.2, C21.2, C22.2, C23.2, C24.2, D2.2 (A2), J7.2 (GND), J8.2 (GND), J9.2 (SHIELD), R10.2, R13.2, R14.2, R15.2, U1.7 (AGND), U1.10 (RXP4), U1.11 (RXP5), U1.12 (RXP6), U1.13 (RXP7), U1.22 (DGND), U1.25 (OMCK); also elsewhere on the board
I2C_SCL: U1.16 (SCL); also elsewhere on the board
I2C_SDA: U1.17 (SDA); also elsewhere on the board
OPT1_OUT: C11.1, C15.1, J7.1 (OUT)
OPT2_OUT: C12.1, C16.1, J8.1 (OUT)
PLL_FILT: C23.1, R11.1, U1.8 (FILT)
PLL_RC: C24.1, R11.2
RXN_AC: C18.1, U1.5 (RXN)
RX_ARC: U1.1 (RXP3); also elsewhere on the board
RX_COAX: C17.2, U1.2 (RXP2)
RX_OPT1: C11.2, U1.4 (RXP0)
RX_OPT2: C12.2, U1.3 (RXP1)
SPDIF_BCLK: U1.27 (OSCLK); also elsewhere on the board
SPDIF_D0: R12.1, U1.26 (SDOUT); also elsewhere on the board
SPDIF_LRCLK: U1.28 (OLRCK); also elsewhere on the board

Notes on the sheet:
A12 ARC STUDY - optical/coax/ARC shared selector
RXP0 OPT1 / RXP1 OPT2 / RXP2 coax / RXP3 ARC. No resampling or codec decoding here.
OMCK unused: carrier-rate measurement via RMCK needs Pi/HAT validation. D2 adds coax ESD clamping; system ESD testing remains required.

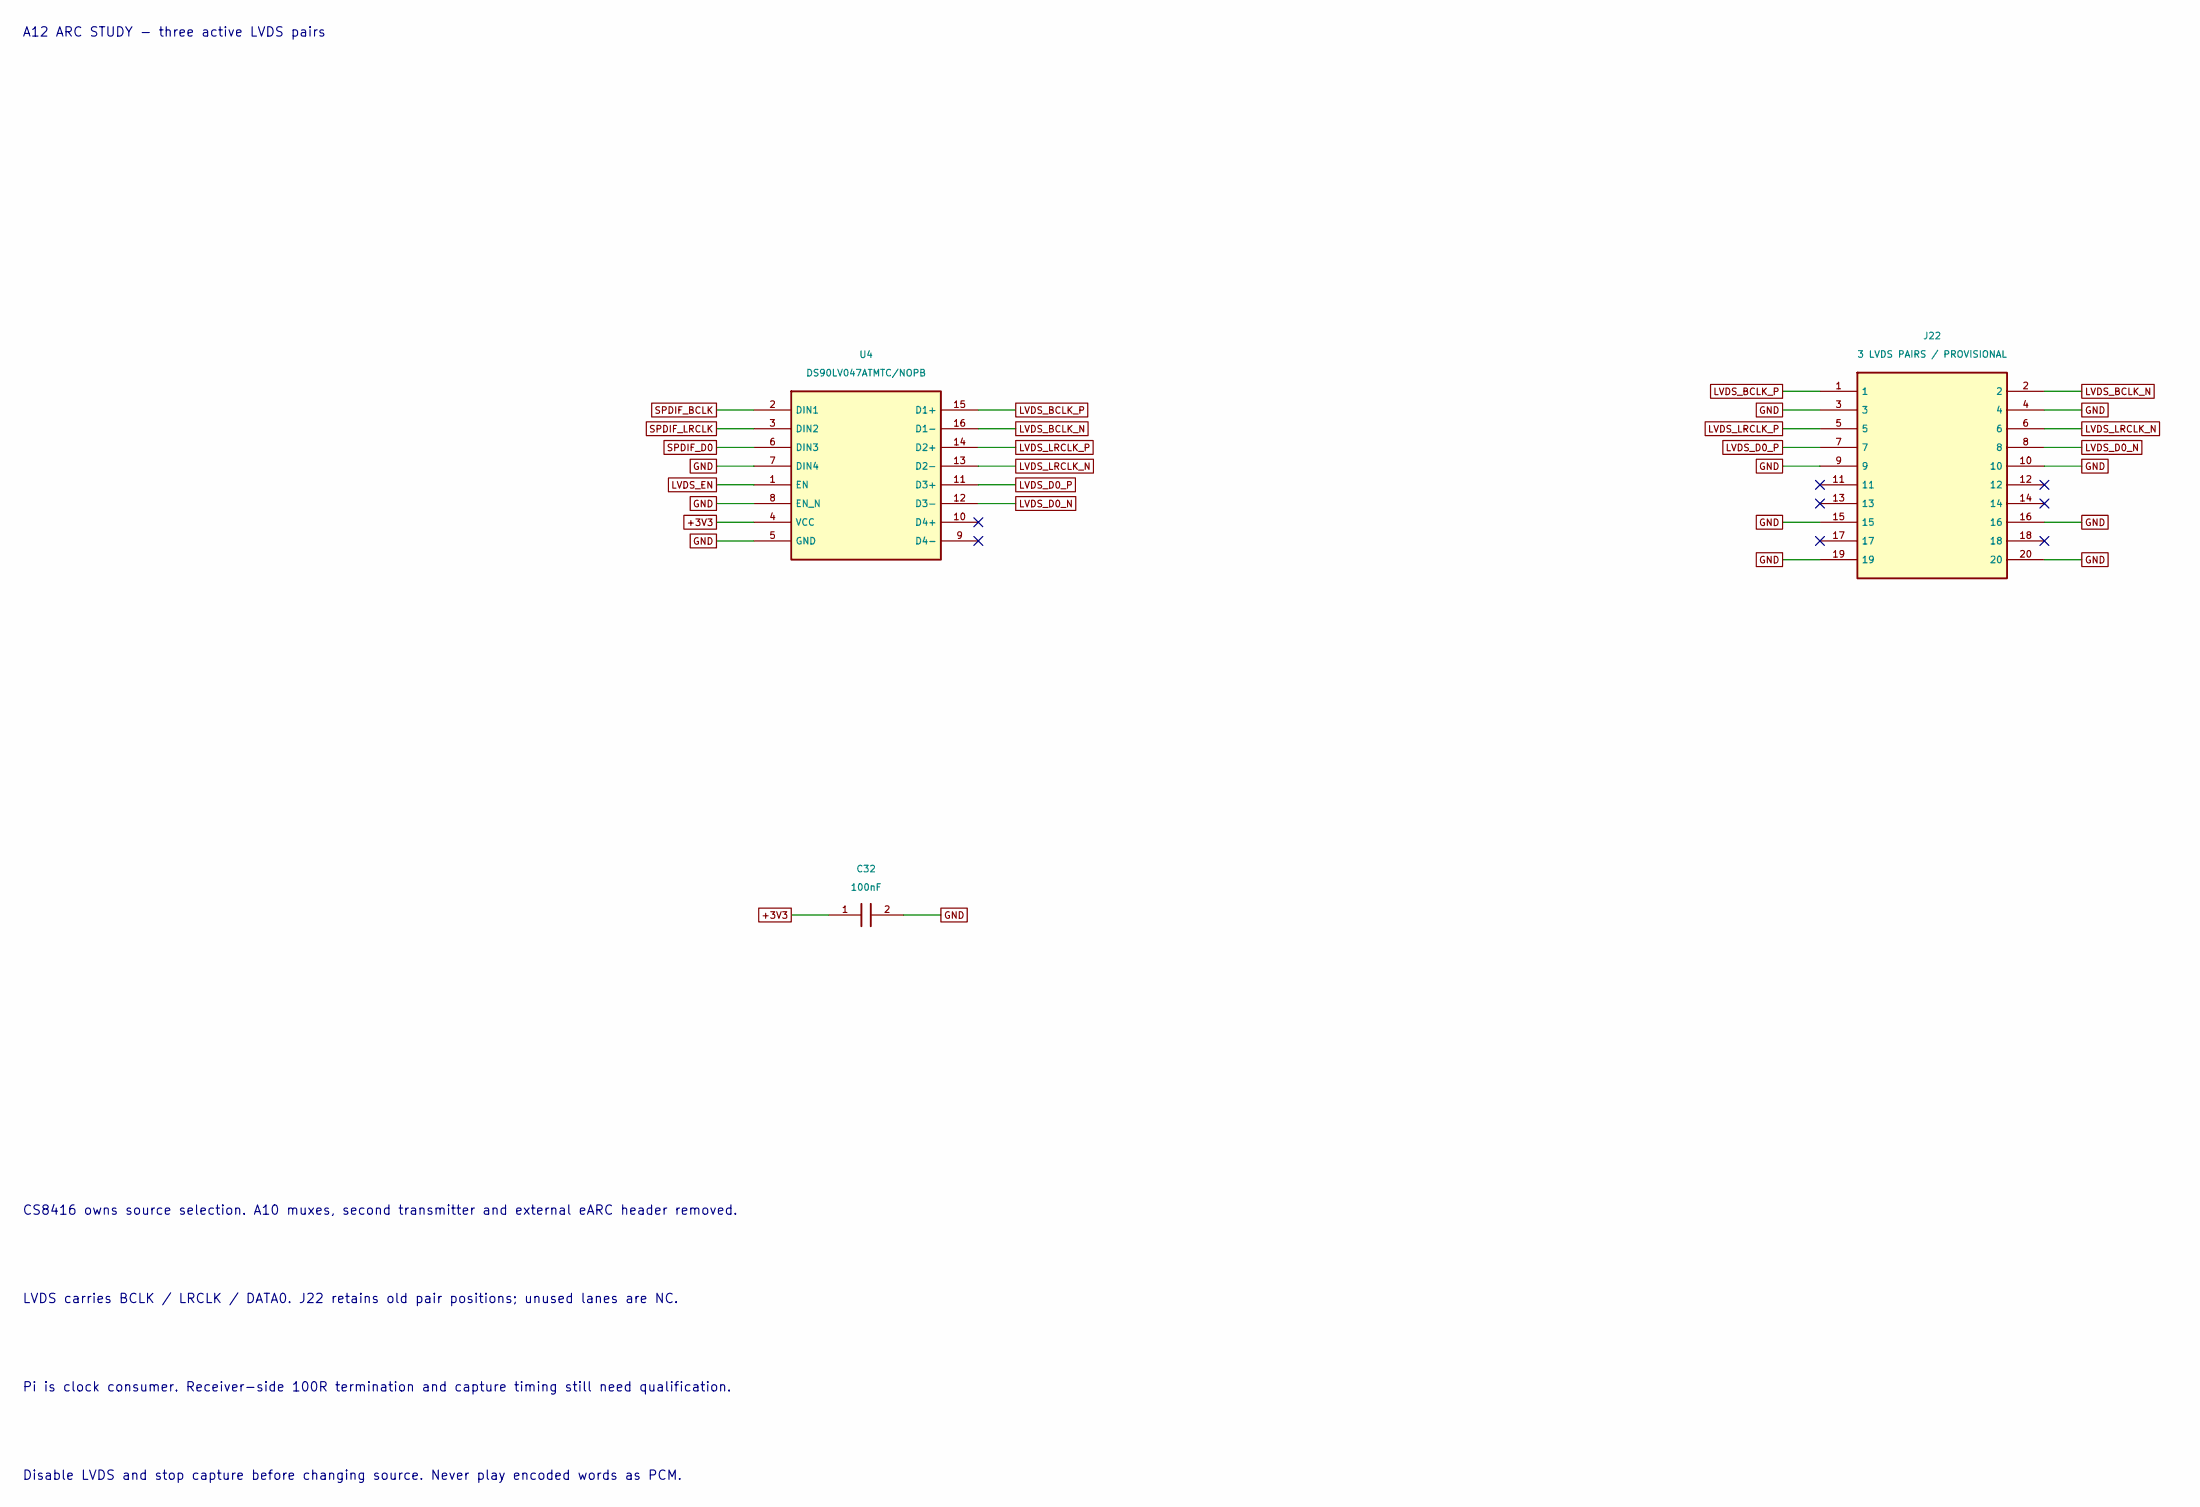
[picture p111: schematic selection-lvds.kicad_sch, Open Cinema - selection-lvds]

Parts:
C32: 100nF; C_0603_1608Metric; MPN CL10B104KB8NNNC
J22: 3 LVDS PAIRS / PROVISIONAL; PinHeader_2x10_P2.54mm_Vertical; MPN TSW-110-07-G-D
U4: DS90LV047ATMTC/NOPB; TSSOP-16_4.4x5mm_P0.65mm; MPN DS90LV047ATMTC/NOPB

Connections:
+3V3: C32.1, U4.4 (VCC); also elsewhere on the board
GND: C32.2, J22.3, J22.4, J22.9, J22.10, J22.15, J22.16, J22.19, J22.20, U4.5 (GND), U4.7 (DIN4), U4.8 (EN_N); also elsewhere on the board
LVDS_BCLK_N: J22.2, U4.16 (D1-)
LVDS_BCLK_P: J22.1, U4.15 (D1+)
LVDS_D0_N: J22.8, U4.12 (D3-)
LVDS_D0_P: J22.7, U4.11 (D3+)
LVDS_EN: U4.1 (EN); also elsewhere on the board
LVDS_LRCLK_N: J22.6, U4.13 (D2-)
LVDS_LRCLK_P: J22.5, U4.14 (D2+)
SPDIF_BCLK: U4.2 (DIN1); also elsewhere on the board
SPDIF_D0: U4.6 (DIN3); also elsewhere on the board
SPDIF_LRCLK: U4.3 (DIN2); also elsewhere on the board

Notes on the sheet:
A12 ARC STUDY - three active LVDS pairs
CS8416 owns source selection. A10 muxes, second transmitter and external eARC header removed.
LVDS carries BCLK / LRCLK / DATA0. J22 retains old pair positions; unused lanes are NC.
Pi is clock consumer. Receiver-side 100R termination and capture timing still need qualification.
Disable LVDS and stop capture before changing source. Never play encoded words as PCM.

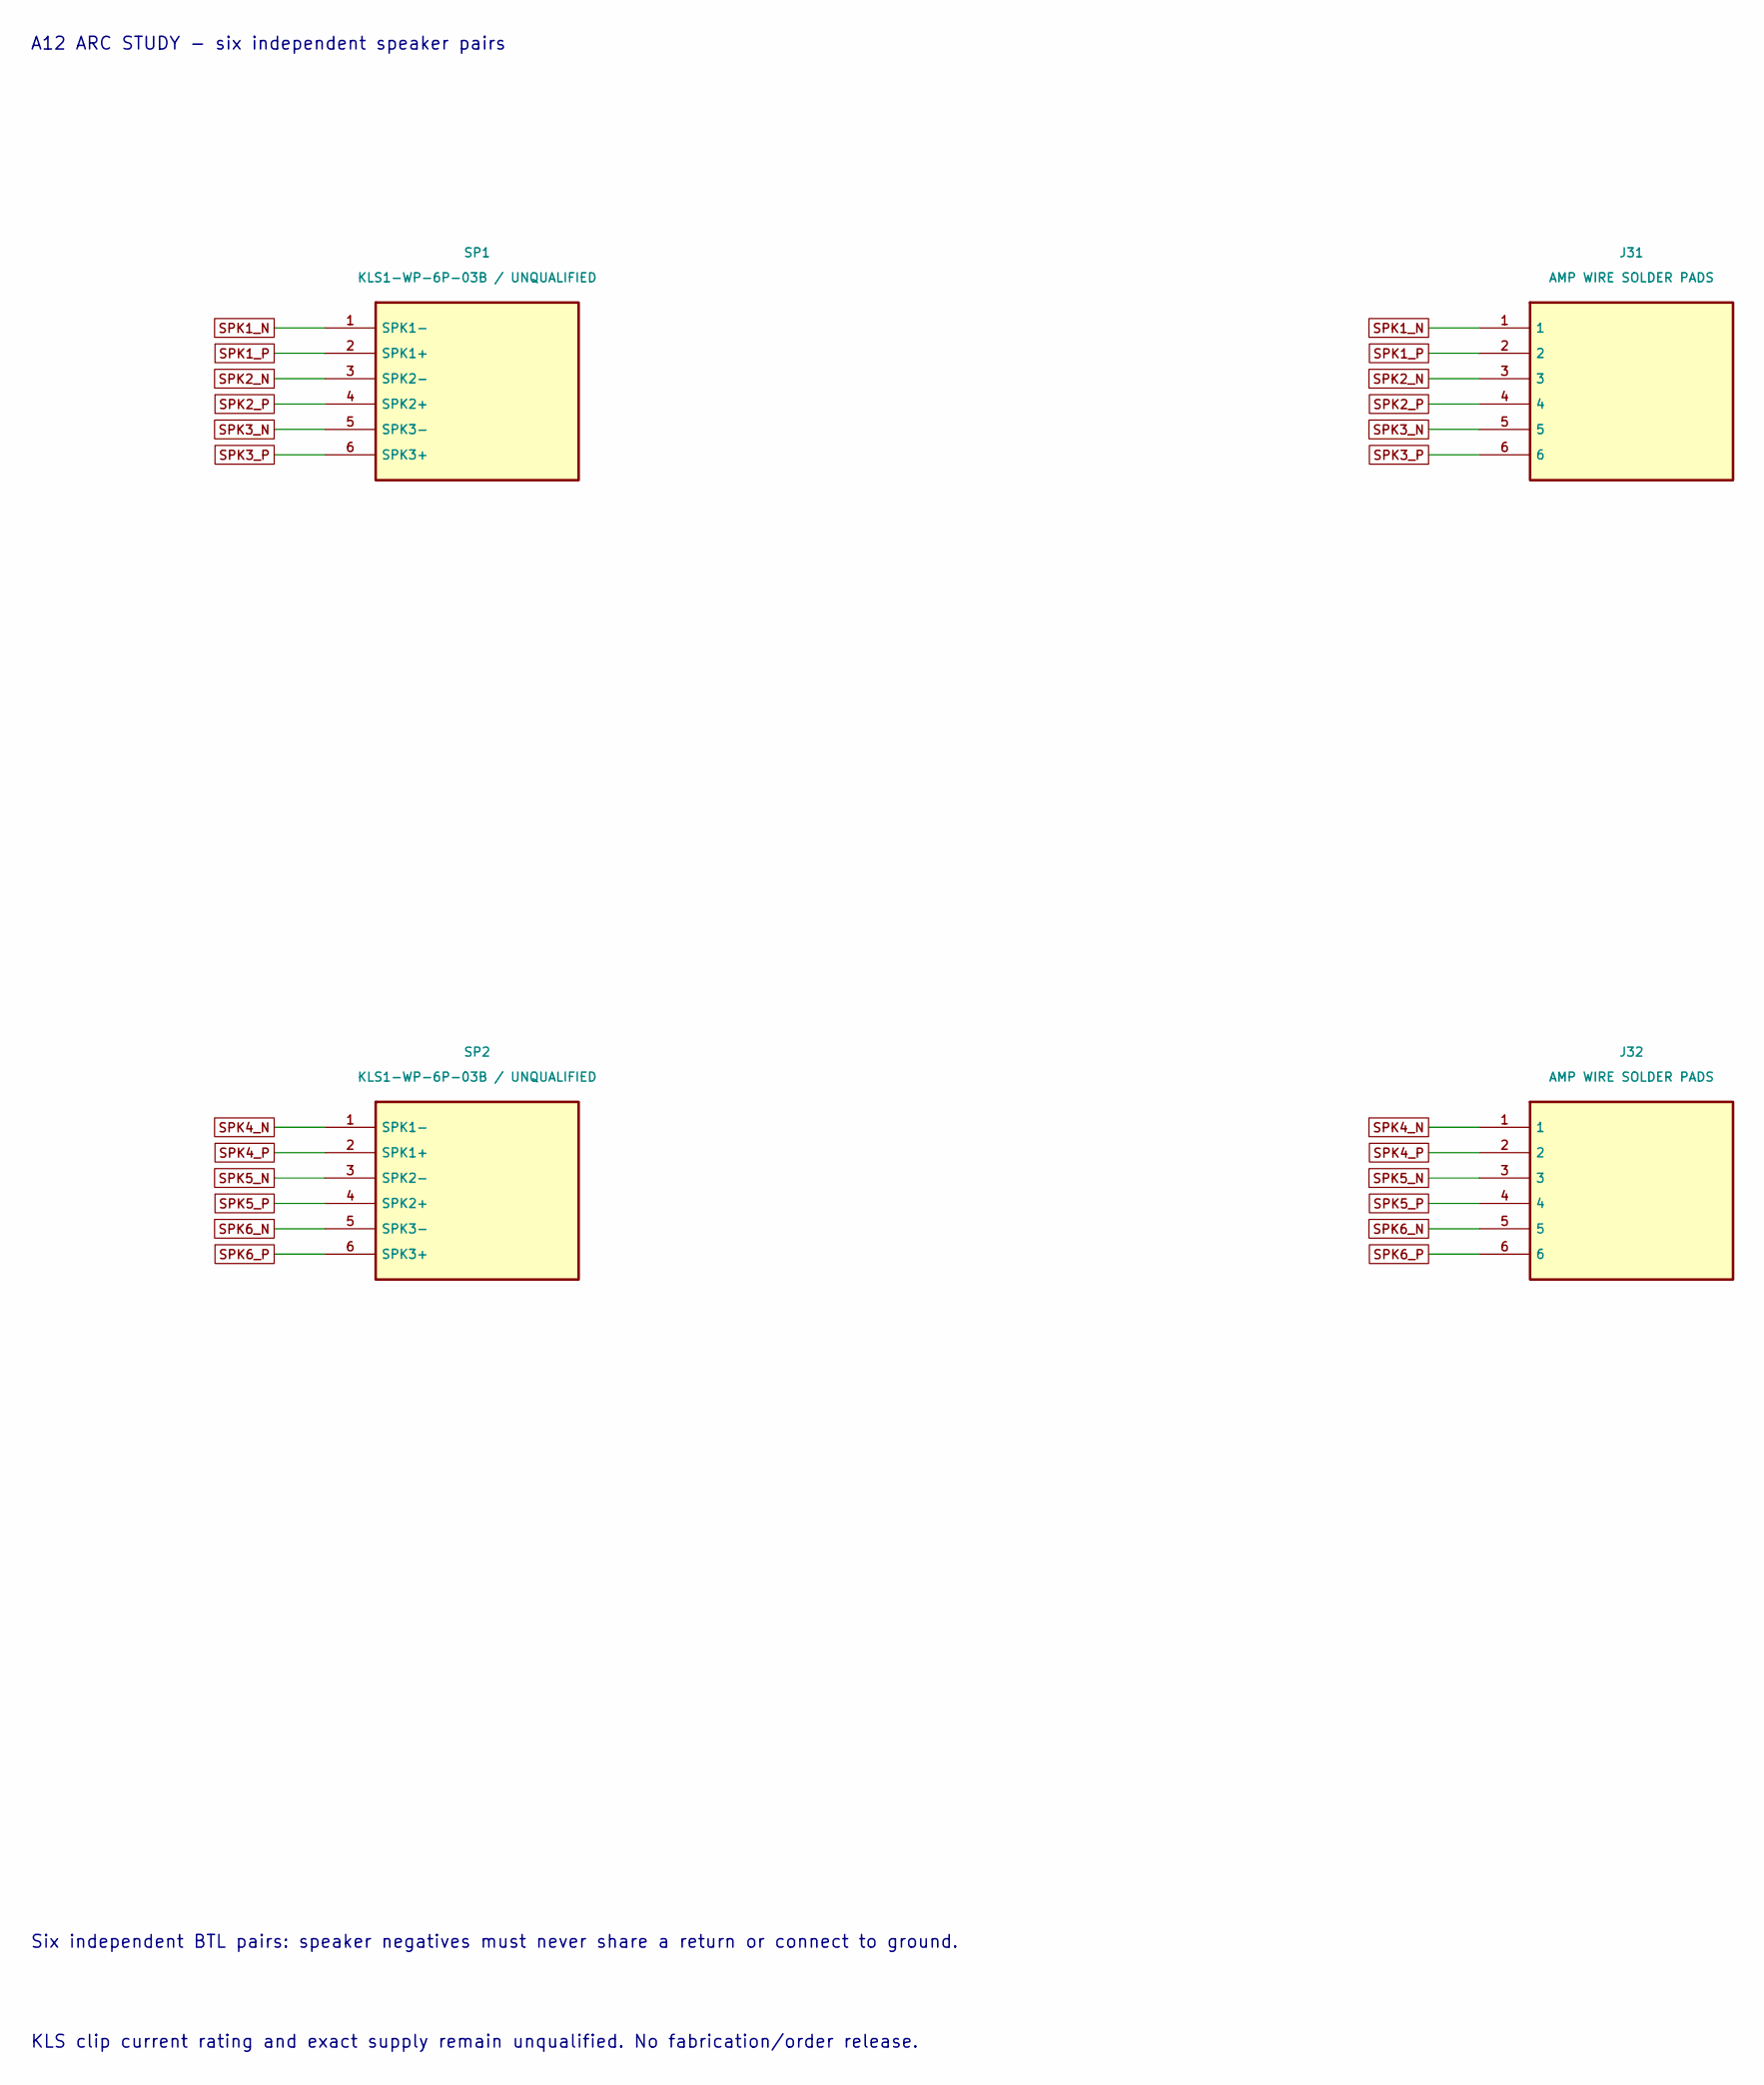
[picture p112: schematic speakers.kicad_sch, Open Cinema - speakers]

Parts:
J31, J32: AMP WIRE SOLDER PADS; SolderWire-1sqmm_1x06_P5.4mm_D1.4mm_OD2.7mm; MPN PCB_SOLDER_PADS_1SQMM
SP1, SP2: KLS1-WP-6P-03B / UNQUALIFIED; KLS1_WP_6P_03B_Horizontal_A8; MPN L-KLS1-WP-6P-03B-B/R

Connections:
SPK1_N: J31.1, SP1.1 (SPK1-)
SPK1_P: J31.2, SP1.2 (SPK1+)
SPK2_N: J31.3, SP1.3 (SPK2-)
SPK2_P: J31.4, SP1.4 (SPK2+)
SPK3_N: J31.5, SP1.5 (SPK3-)
SPK3_P: J31.6, SP1.6 (SPK3+)
SPK4_N: J32.1, SP2.1 (SPK1-)
SPK4_P: J32.2, SP2.2 (SPK1+)
SPK5_N: J32.3, SP2.3 (SPK2-)
SPK5_P: J32.4, SP2.4 (SPK2+)
SPK6_N: J32.5, SP2.5 (SPK3-)
SPK6_P: J32.6, SP2.6 (SPK3+)

Notes on the sheet:
A12 ARC STUDY - six independent speaker pairs
Six independent BTL pairs: speaker negatives must never share a return or connect to ground.
KLS clip current rating and exact supply remain unqualified. No fabrication/order release.
