k3rnL/open-cinema-hardware/boards/rear-io-A12/rear-io-A12.kicad_pcb

## KiCad design boards/rear-io-A12/rear-io-A12.kicad_pcb (continued)

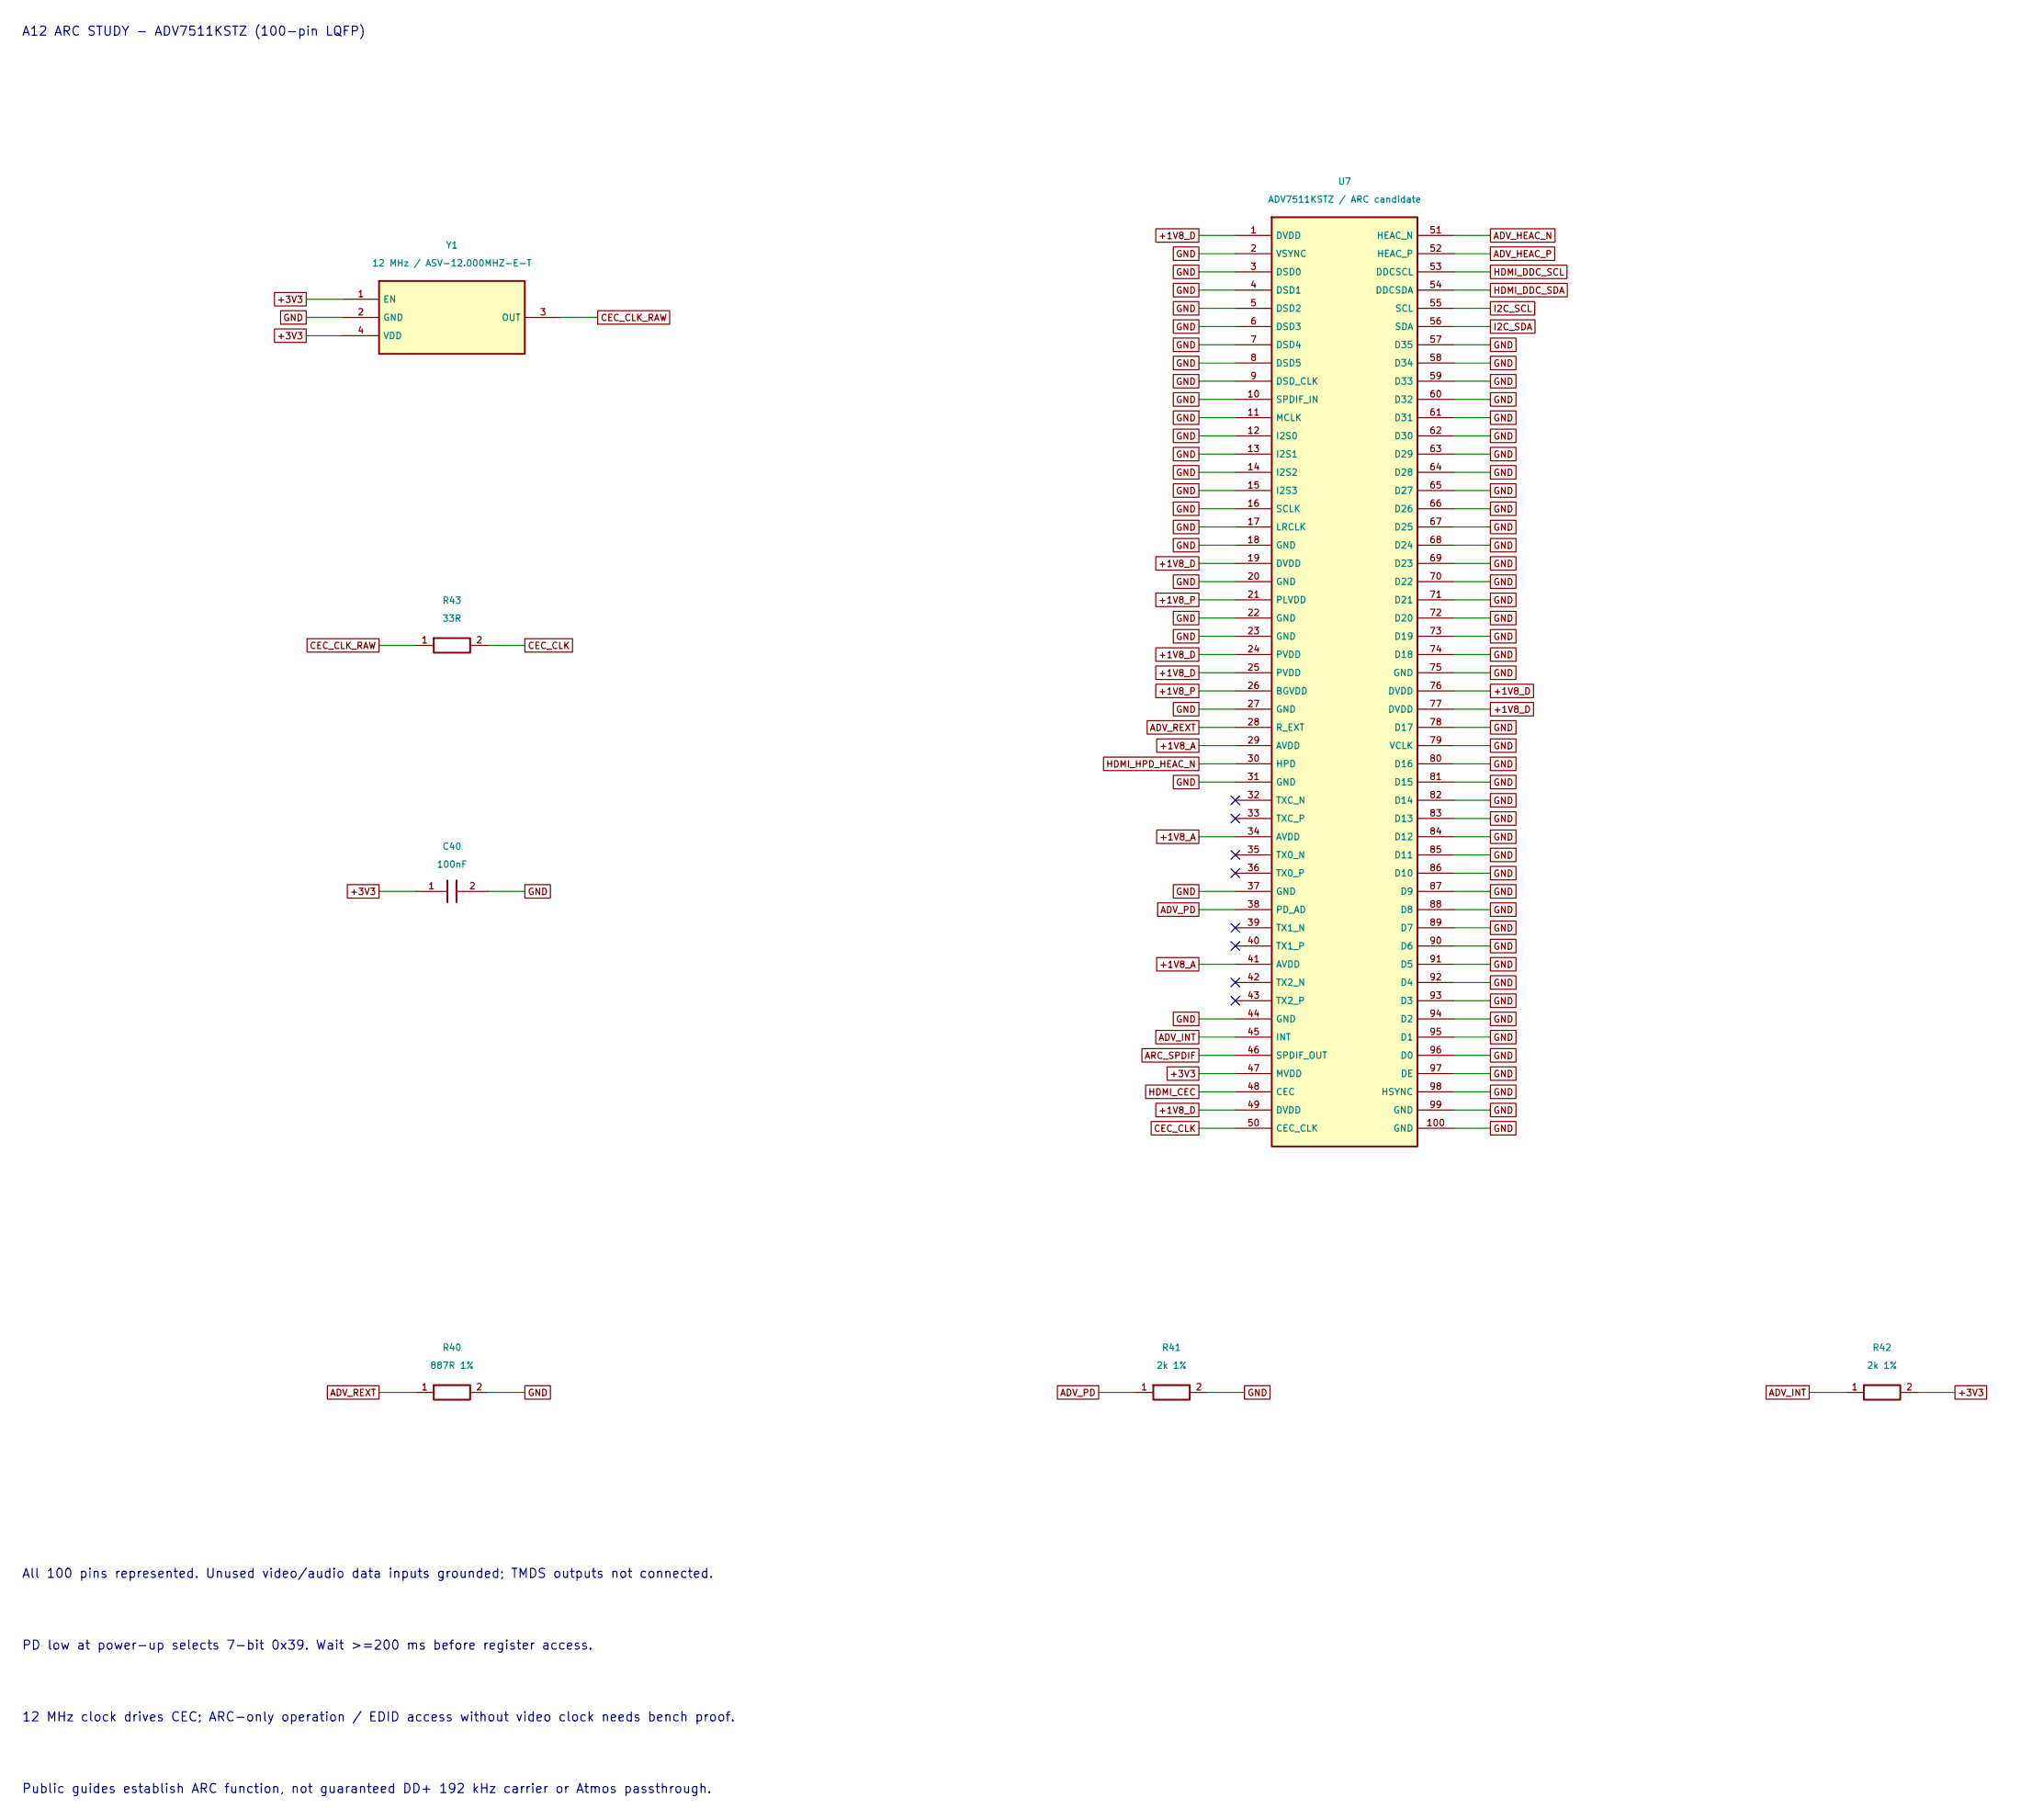
[picture p113: schematic arc-receiver.kicad_sch, Open Cinema - arc-receiver]

Parts:
C40: 100nF; C_0603_1608Metric; MPN CL10B104KB8NNNC
R40: 887R 1%; R_0603_1608Metric; MPN RC0603FR-07887RL
R41, R42: 2k 1%; R_0603_1608Metric; MPN RC0603FR-072KL
R43: 33R; R_0603_1608Metric; MPN RC0603FR-0733RL
U7: ADV7511KSTZ / ARC candidate; LQFP-100_14x14mm_P0.5mm; MPN ADV7511KSTZ
Y1: 12 MHz / ASV-12.000MHZ-E-T; Oscillator_SMD_Abracon_ASV-4Pin_7.0x5.1mm; MPN ASV-12.000MHZ-E-T

Connections:
+1V8_A: U7.29 (AVDD), U7.34 (AVDD), U7.41 (AVDD); also elsewhere on the board
+1V8_D: U7.1 (DVDD), U7.19 (DVDD), U7.24 (PVDD), U7.25 (PVDD), U7.49 (DVDD), U7.76 (DVDD), U7.77 (DVDD); also elsewhere on the board
+1V8_P: U7.21 (PLVDD), U7.26 (BGVDD); also elsewhere on the board
+3V3: C40.1, R42.2, U7.47 (MVDD), Y1.1 (EN), Y1.4 (VDD); also elsewhere on the board
ADV_HEAC_N: U7.51 (HEAC_N); also elsewhere on the board
ADV_HEAC_P: U7.52 (HEAC_P); also elsewhere on the board
ADV_INT: R42.1, U7.45 (INT); also elsewhere on the board
ADV_PD: R41.1, U7.38 (PD_AD)
ADV_REXT: R40.1, U7.28 (R_EXT)
ARC_SPDIF: U7.46 (SPDIF_OUT); also elsewhere on the board
CEC_CLK: R43.2, U7.50 (CEC_CLK)
CEC_CLK_RAW: R43.1, Y1.3 (OUT)
GND: C40.2, R40.2, R41.2, U7.2 (VSYNC), U7.3 (DSD0), U7.4 (DSD1), U7.5 (DSD2), U7.6 (DSD3), U7.7 (DSD4), U7.8 (DSD5), U7.9 (DSD_CLK), U7.10 (SPDIF_IN), U7.11 (MCLK), U7.12 (I2S0), U7.13 (I2S1), U7.14 (I2S2), U7.15 (I2S3), U7.16 (SCLK), U7.17 (LRCLK), U7.18 (GND), U7.20 (GND), U7.22 (GND), U7.23 (GND), U7.27 (GND), U7.31 (GND), U7.37 (GND), U7.44 (GND), U7.57 (D35), U7.58 (D34), U7.59 (D33), U7.60 (D32), U7.61 (D31), U7.62 (D30), U7.63 (D29), U7.64 (D28), U7.65 (D27), U7.66 (D26), U7.67 (D25), U7.68 (D24), U7.69 (D23), U7.70 (D22), U7.71 (D21), U7.72 (D20), U7.73 (D19), U7.74 (D18), U7.75 (GND), U7.78 (D17), U7.79 (VCLK), U7.80 (D16), U7.81 (D15), U7.82 (D14), U7.83 (D13), U7.84 (D12), U7.85 (D11), U7.86 (D10), U7.87 (D9), U7.88 (D8), U7.89 (D7), U7.90 (D6), U7.91 (D5), U7.92 (D4), U7.93 (D3), U7.94 (D2), U7.95 (D1), U7.96 (D0), U7.97 (DE), U7.98 (HSYNC), U7.99 (GND), U7.100 (GND), Y1.2 (GND); also elsewhere on the board
HDMI_CEC: U7.48 (CEC); also elsewhere on the board
HDMI_DDC_SCL: U7.53 (DDCSCL); also elsewhere on the board
HDMI_DDC_SDA: U7.54 (DDCSDA); also elsewhere on the board
HDMI_HPD_HEAC_N: U7.30 (HPD); also elsewhere on the board
I2C_SCL: U7.55 (SCL); also elsewhere on the board
I2C_SDA: U7.56 (SDA); also elsewhere on the board

Notes on the sheet:
A12 ARC STUDY - ADV7511KSTZ (100-pin LQFP)
All 100 pins represented. Unused video/audio data inputs grounded; TMDS outputs not connected.
PD low at power-up selects 7-bit 0x39. Wait >=200 ms before register access.
12 MHz clock drives CEC; ARC-only operation / EDID access without video clock needs bench proof.
Public guides establish ARC function, not guaranteed DD+ 192 kHz carrier or Atmos passthrough.

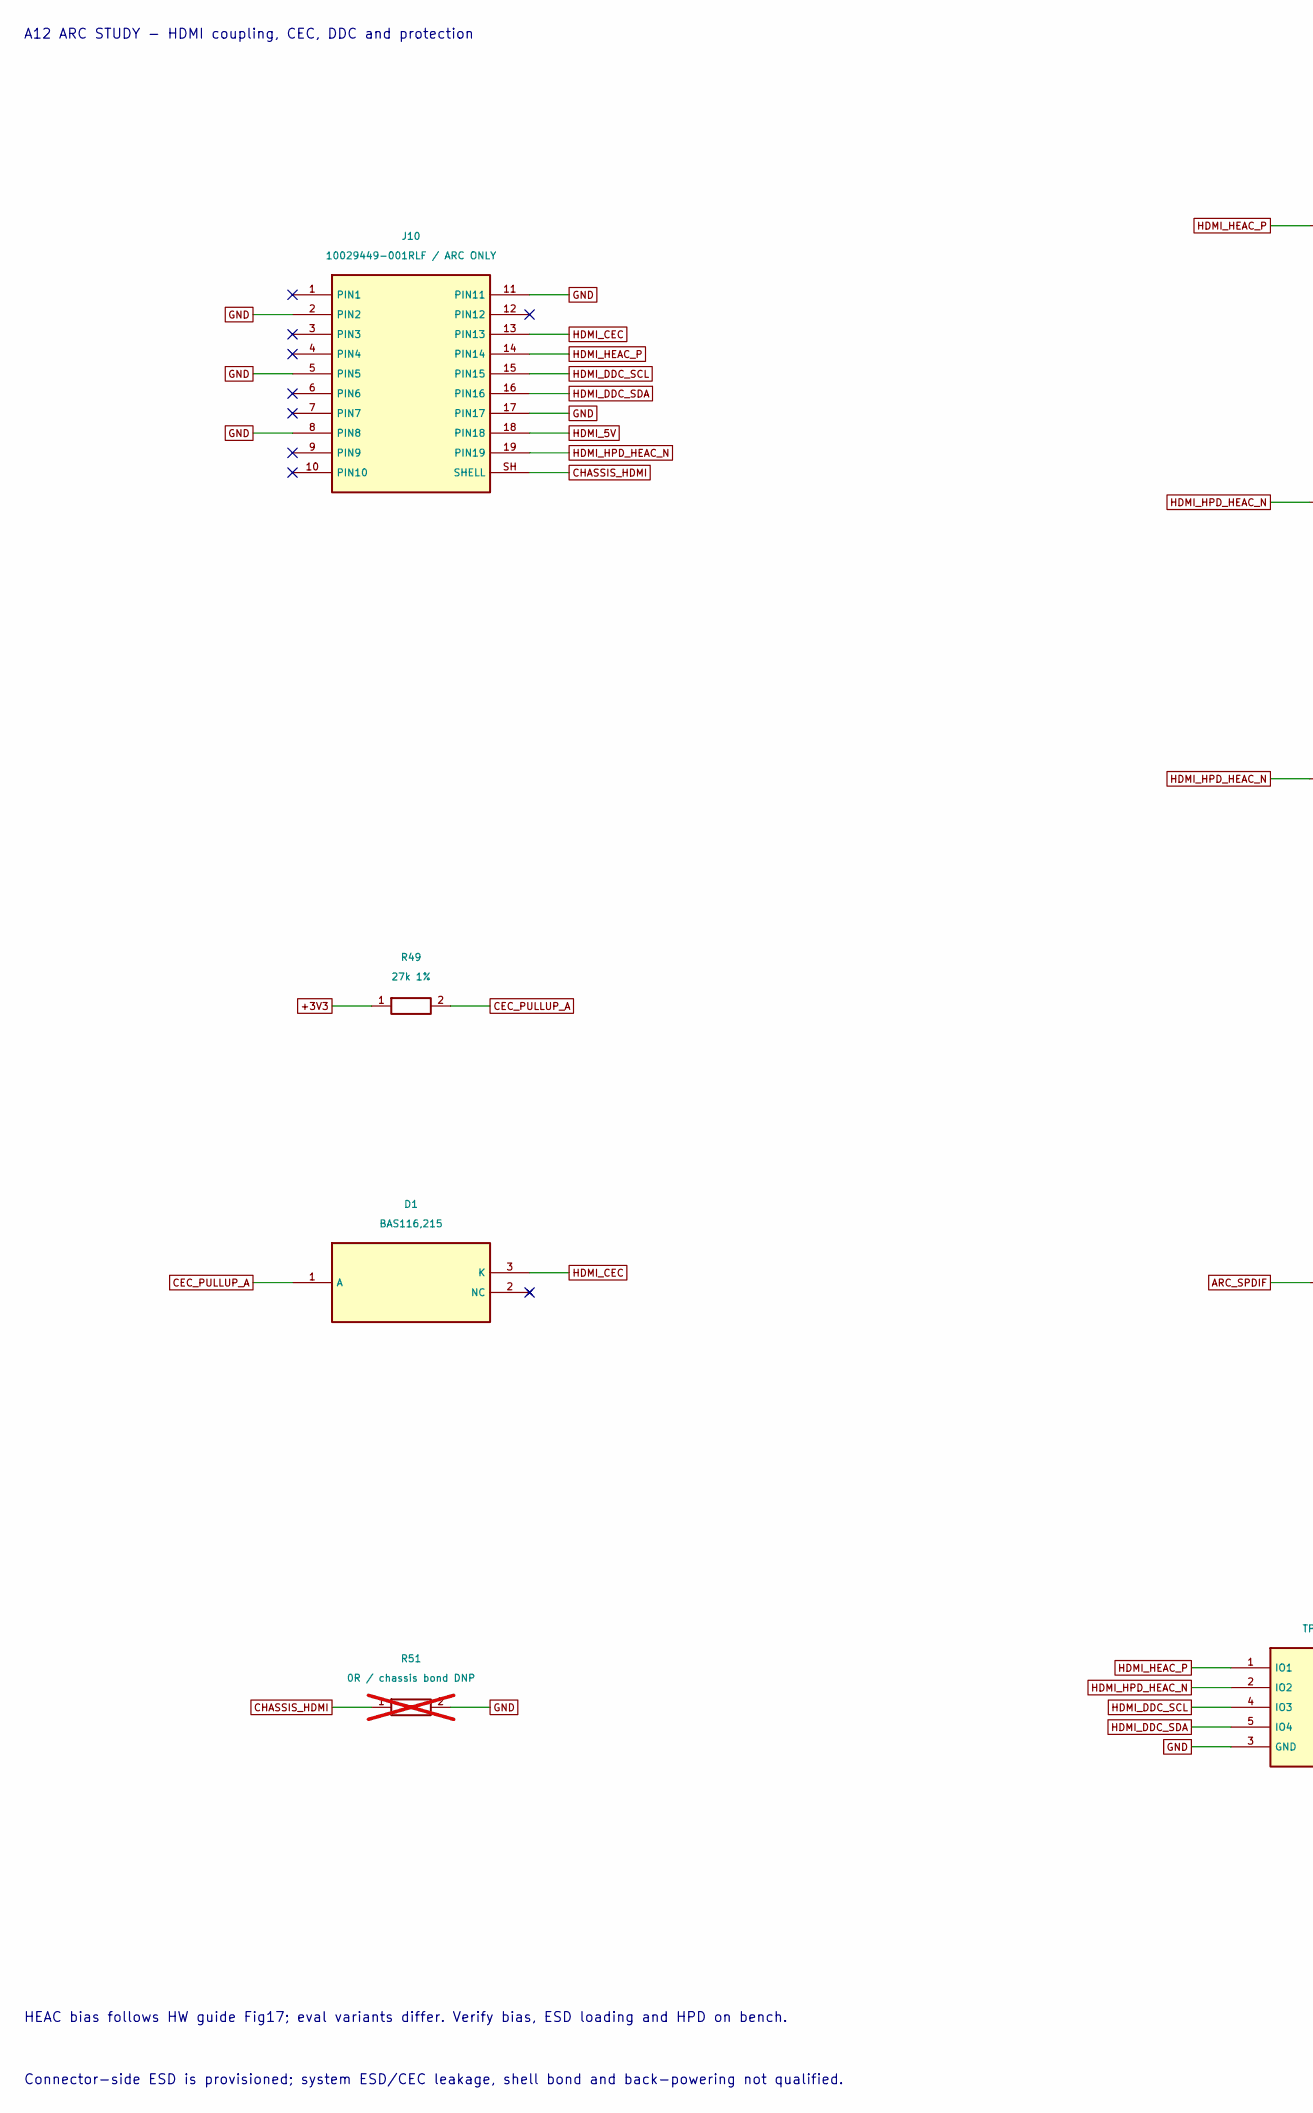
[picture p114: schematic arc-connector.kicad_sch, Open Cinema - arc-connector, part in row 1, column 1]

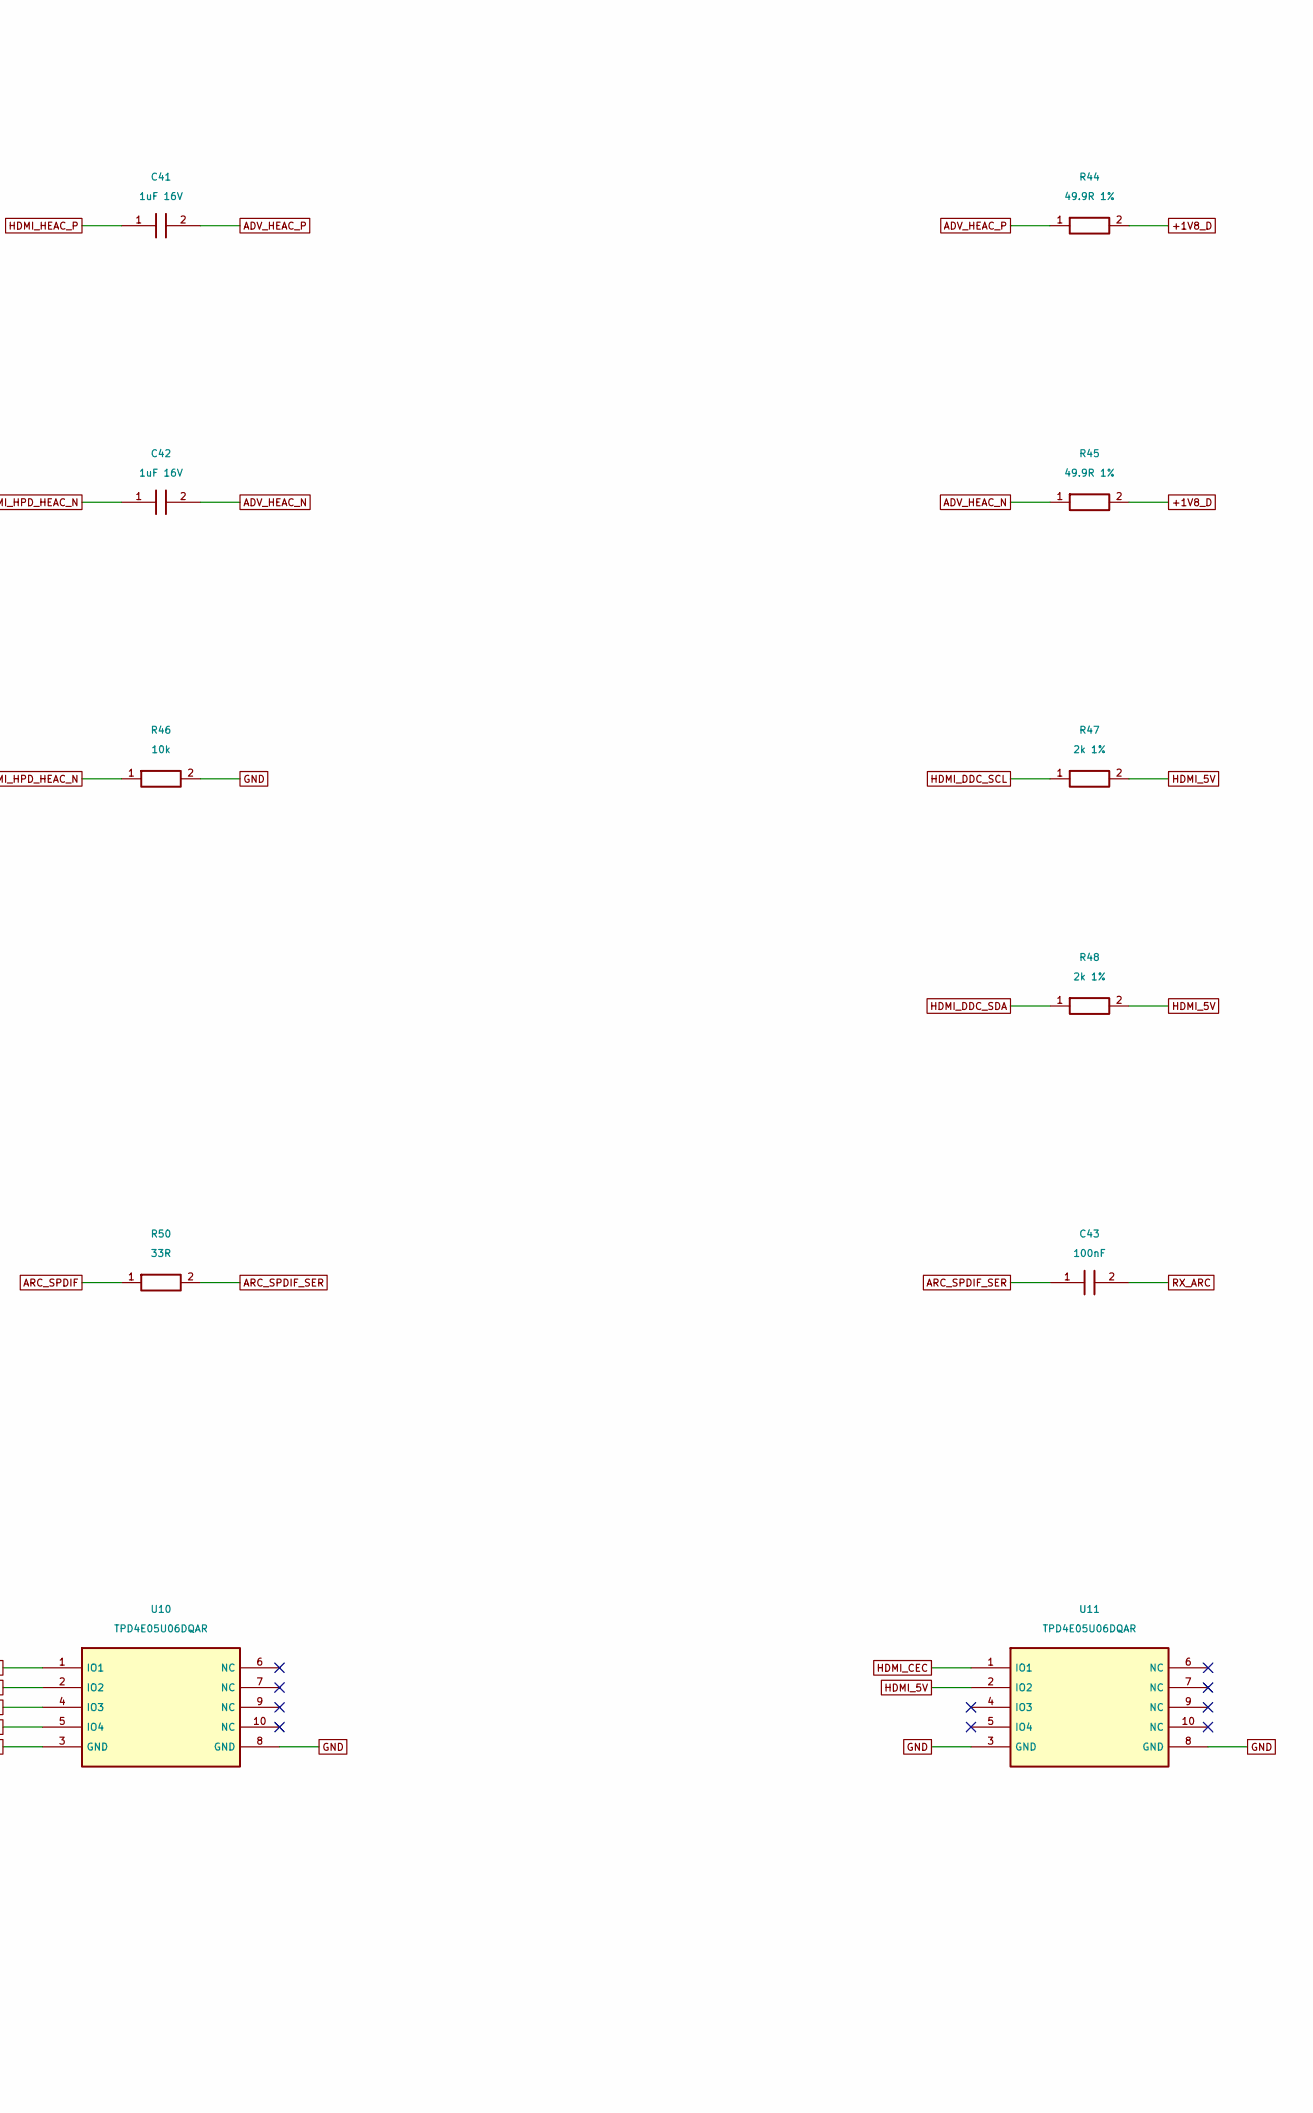
[picture p115: schematic arc-connector.kicad_sch, Open Cinema - arc-connector, part in row 1, column 2]

Parts:
C41, C42: 1uF 16V; C_0603_1608Metric; MPN CL10B105KO8NNNC
C43: 100nF; C_0603_1608Metric; MPN CL10B104KB8NNNC
D1: BAS116,215; SOT-23; MPN BAS116,215
J10: 10029449-001RLF / ARC ONLY; HDMI_A_Amphenol_10029449-x01xLF_Horizontal; MPN 10029449-001RLF
R44, R45: 49.9R 1%; R_0603_1608Metric; MPN RC0603FR-0749R9L
R46: 10k; R_0603_1608Metric; MPN RC0603FR-0710KL
R47, R48: 2k 1%; R_0603_1608Metric; MPN RC0603FR-072KL
R49: 27k 1%; R_0603_1608Metric; MPN RC0603FR-0727KL
R50: 33R; R_0603_1608Metric; MPN RC0603FR-0733RL
R51: 0R / chassis bond DNP; R_0603_1608Metric; MPN RC0603JR-070RL; not fitted
U10, U11: TPD4E05U06DQAR; USON-10_2.5x1.0mm_P0.5mm; MPN TPD4E05U06DQAR

Connections:
+1V8_D: R44.2, R45.2; also elsewhere on the board
+3V3: R49.1; also elsewhere on the board
ADV_HEAC_N: C42.2, R45.1; also elsewhere on the board
ADV_HEAC_P: C41.2, R44.1; also elsewhere on the board
ARC_SPDIF: R50.1; also elsewhere on the board
ARC_SPDIF_SER: C43.1, R50.2
CEC_PULLUP_A: D1.1 (A), R49.2
CHASSIS_HDMI: J10.SH (SHELL), R51.1
GND: J10.2 (PIN2), J10.5 (PIN5), J10.8 (PIN8), J10.11 (PIN11), J10.17 (PIN17), R46.2, R51.2, U10.3 (GND), U10.8 (GND), U11.3 (GND), U11.8 (GND); also elsewhere on the board
HDMI_5V: J10.18 (PIN18), R47.2, R48.2, U11.2 (IO2); also elsewhere on the board
HDMI_CEC: D1.3 (K), J10.13 (PIN13), U11.1 (IO1); also elsewhere on the board
HDMI_DDC_SCL: J10.15 (PIN15), R47.1, U10.4 (IO3); also elsewhere on the board
HDMI_DDC_SDA: J10.16 (PIN16), R48.1, U10.5 (IO4); also elsewhere on the board
HDMI_HEAC_P: C41.1, J10.14 (PIN14), U10.1 (IO1)
HDMI_HPD_HEAC_N: C42.1, J10.19 (PIN19), R46.1, U10.2 (IO2); also elsewhere on the board
RX_ARC: C43.2; also elsewhere on the board

Notes on the sheet:
A12 ARC STUDY - HDMI coupling, CEC, DDC and protection
HEAC bias follows HW guide Fig17; eval variants differ. Verify bias, ESD loading and HPD on bench.
Connector-side ESD is provisioned; system ESD/CEC leakage, shell bond and back-powering not qualified.

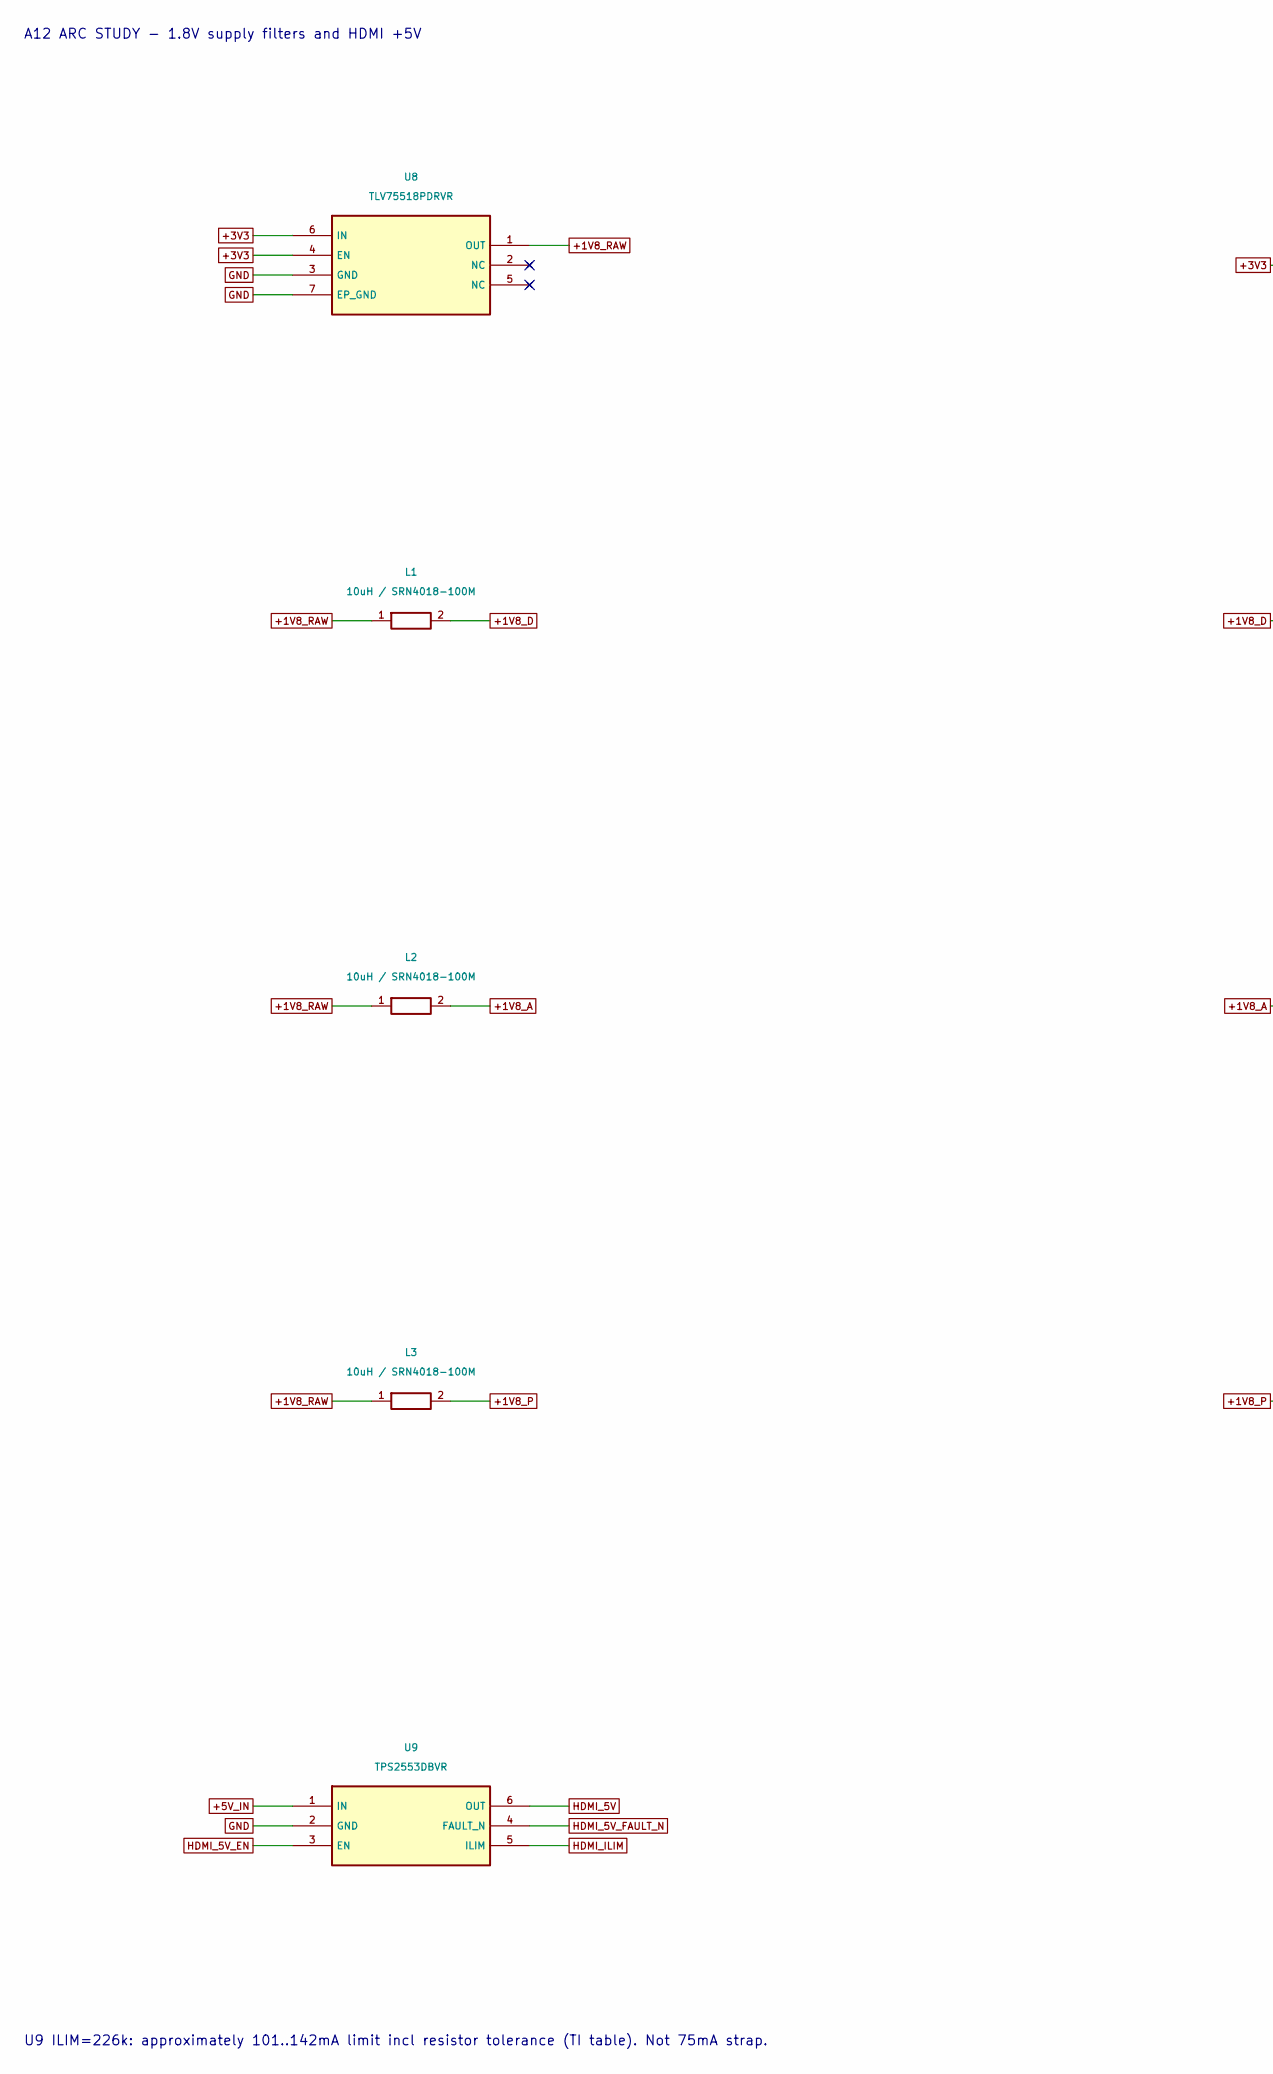
[picture p116: schematic arc-power.kicad_sch, Open Cinema - arc-power, part in row 1, column 1]

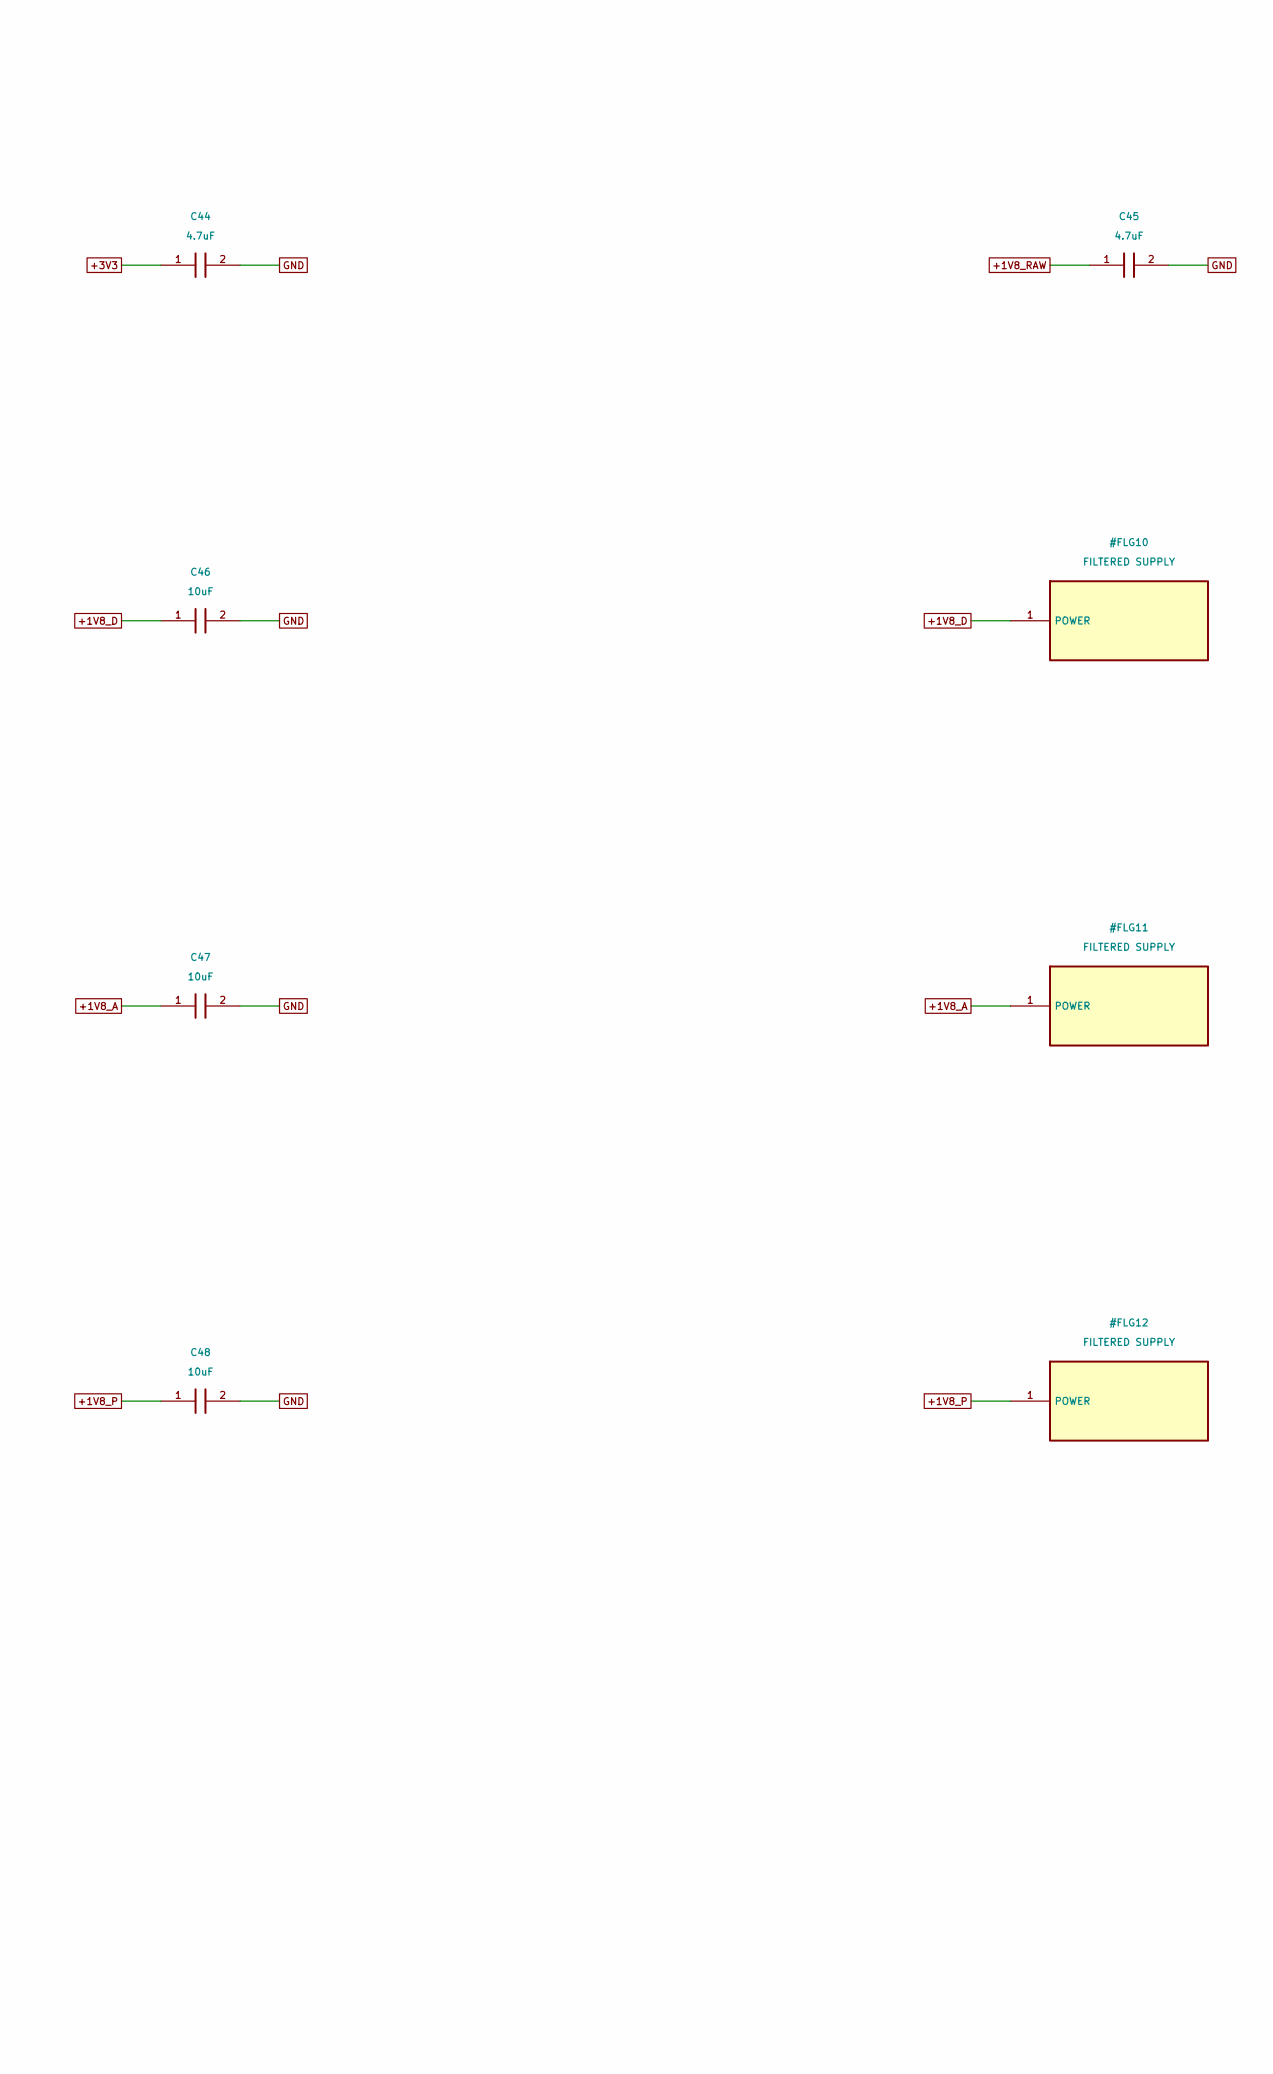
[picture p117: schematic arc-power.kicad_sch, Open Cinema - arc-power, part in row 1, column 2]

Parts:
C44, C45: 4.7uF; C_0603_1608Metric; MPN CL10A475KO8NNNC
C46, C47, C48: 10uF; C_0603_1608Metric; MPN CL10A106KP8NNNC
L1, L2, L3: 10uH / SRN4018-100M; L_Bourns-SRN4018; MPN SRN4018-100M
U8: TLV75518PDRVR; WSON-6-1EP_2x2mm_P0.65mm_EP1x1.6mm; MPN TLV75518PDRVR
U9: TPS2553DBVR; SOT-23-6; MPN TPS2553DBVR

Connections:
+1V8_A: C47.1, L2.2; also elsewhere on the board
+1V8_D: C46.1, L1.2; also elsewhere on the board
+1V8_P: C48.1, L3.2; also elsewhere on the board
+1V8_RAW: C45.1, L1.1, L2.1, L3.1, U8.1 (OUT)
+3V3: C44.1, U8.4 (EN), U8.6 (IN); also elsewhere on the board
+5V_IN: U9.1 (IN); also elsewhere on the board
GND: C44.2, C45.2, C46.2, C47.2, C48.2, U8.3 (GND), U8.7 (EP_GND), U9.2 (GND); also elsewhere on the board
HDMI_5V: U9.6 (OUT); also elsewhere on the board
HDMI_5V_EN: U9.3 (EN); also elsewhere on the board
HDMI_5V_FAULT_N: U9.4 (FAULT_N); also elsewhere on the board
HDMI_ILIM: U9.5 (ILIM); also elsewhere on the board

Notes on the sheet:
A12 ARC STUDY - 1.8V supply filters and HDMI +5V
U9 ILIM=226k: approximately 101..142mA limit incl resistor tolerance (TI table). Not 75mA strap.
