k3rnL/open-cinema-hardware/boards/rear-io-A12/rear-io-A12.kicad_pcb

## KiCad design boards/rear-io-A12/rear-io-A12.kicad_pcb (continued)

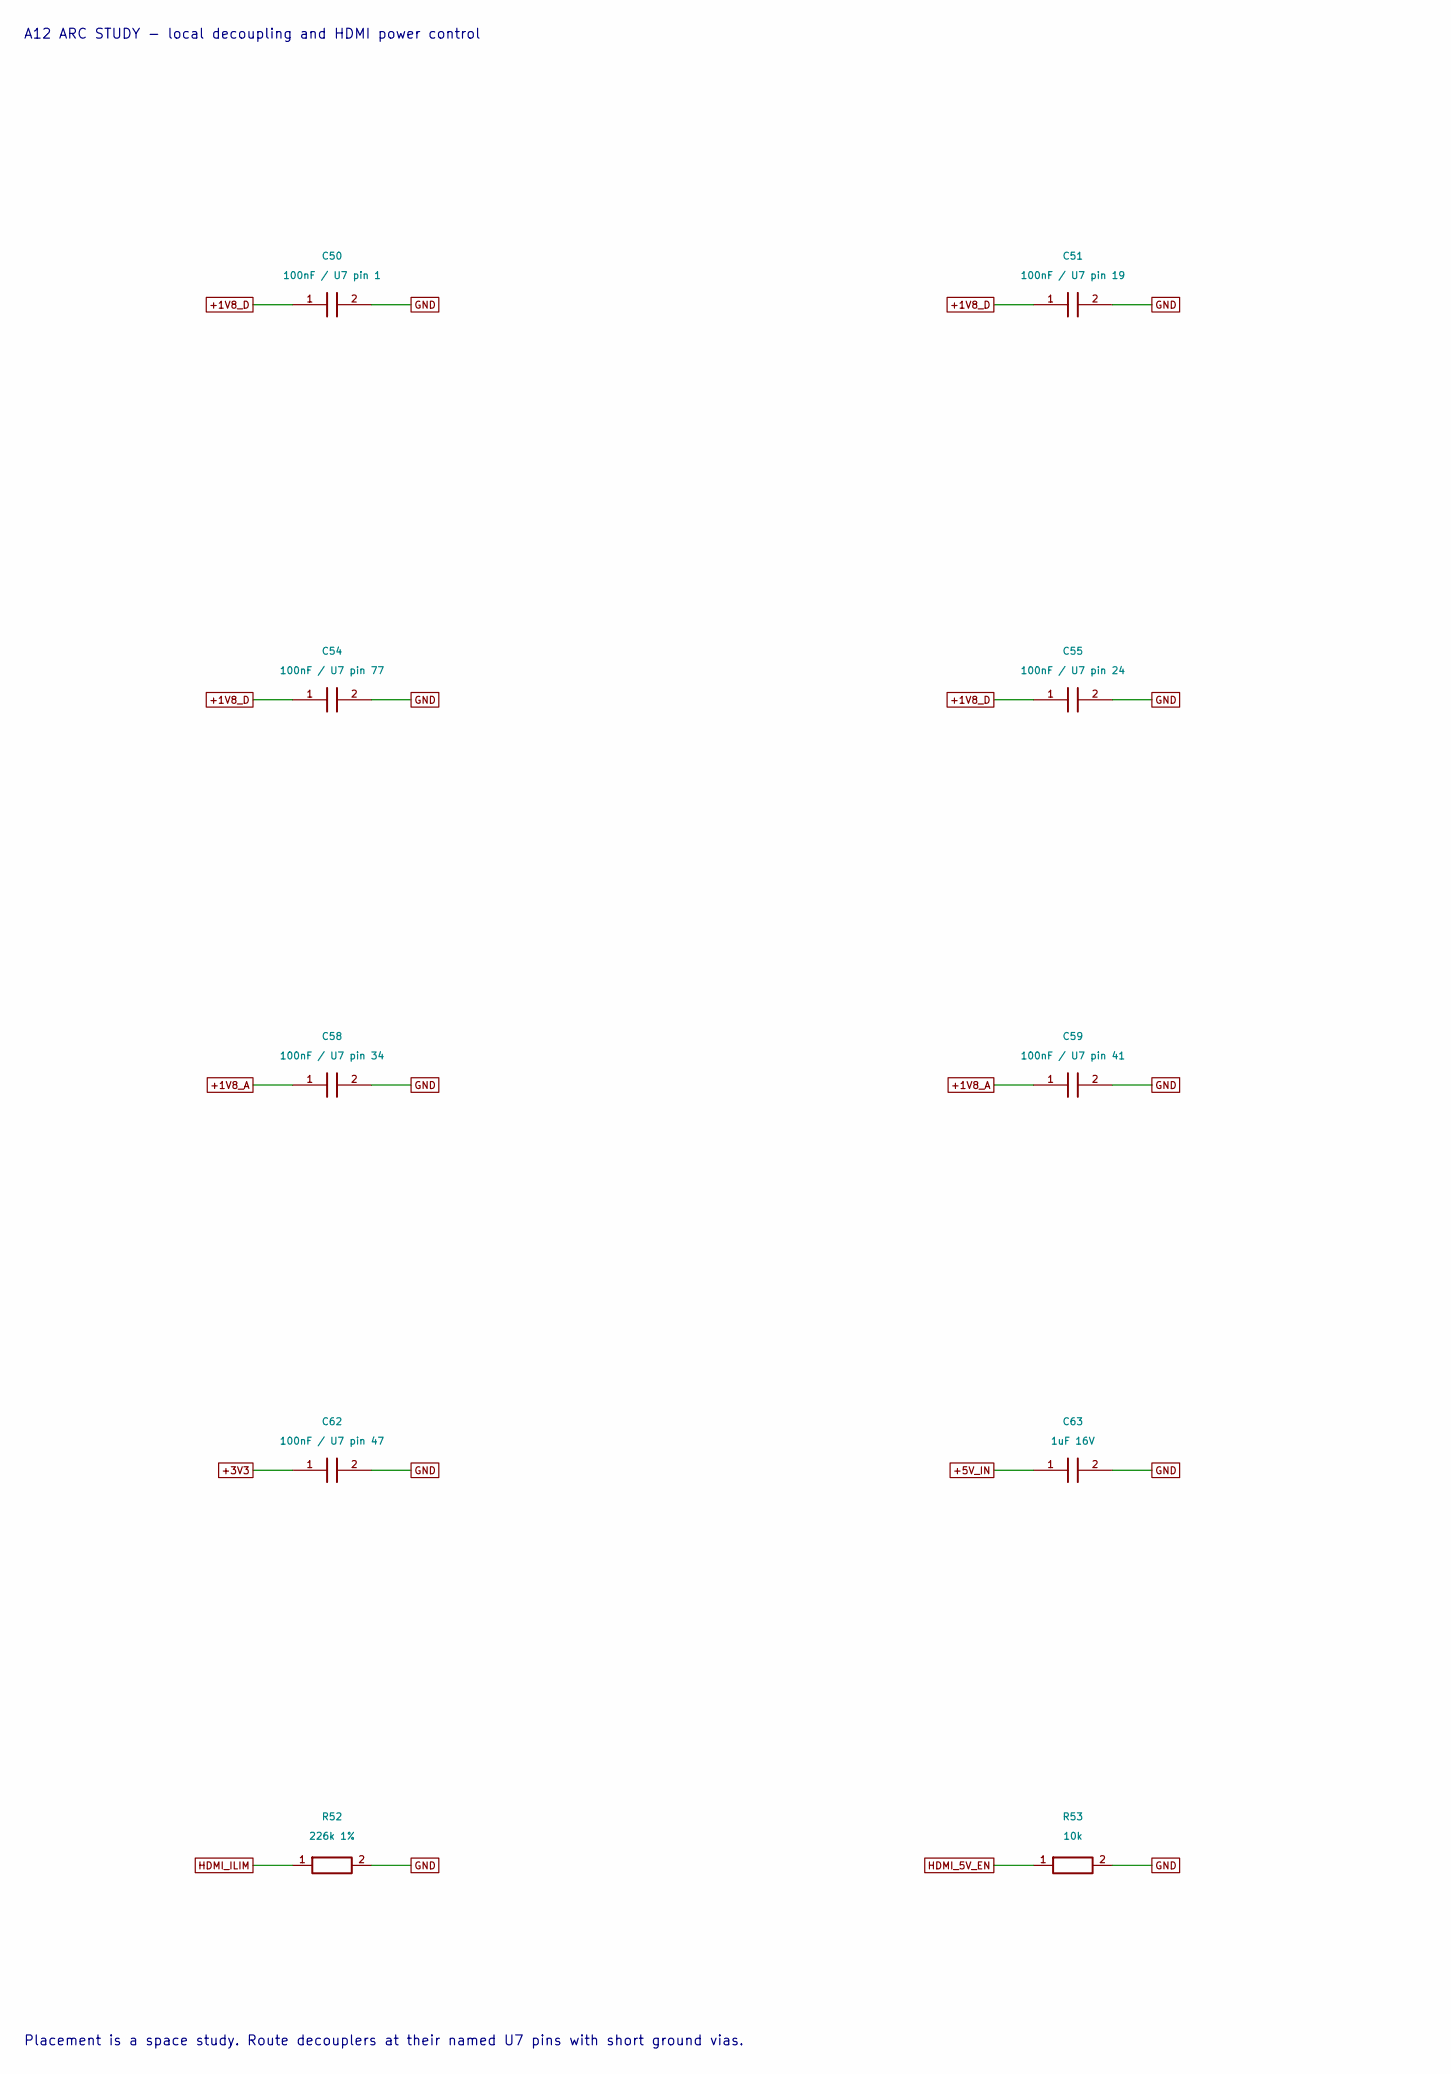
[picture p118: schematic arc-decoupling.kicad_sch, Open Cinema - arc-decoupling, part in row 1, column 1]

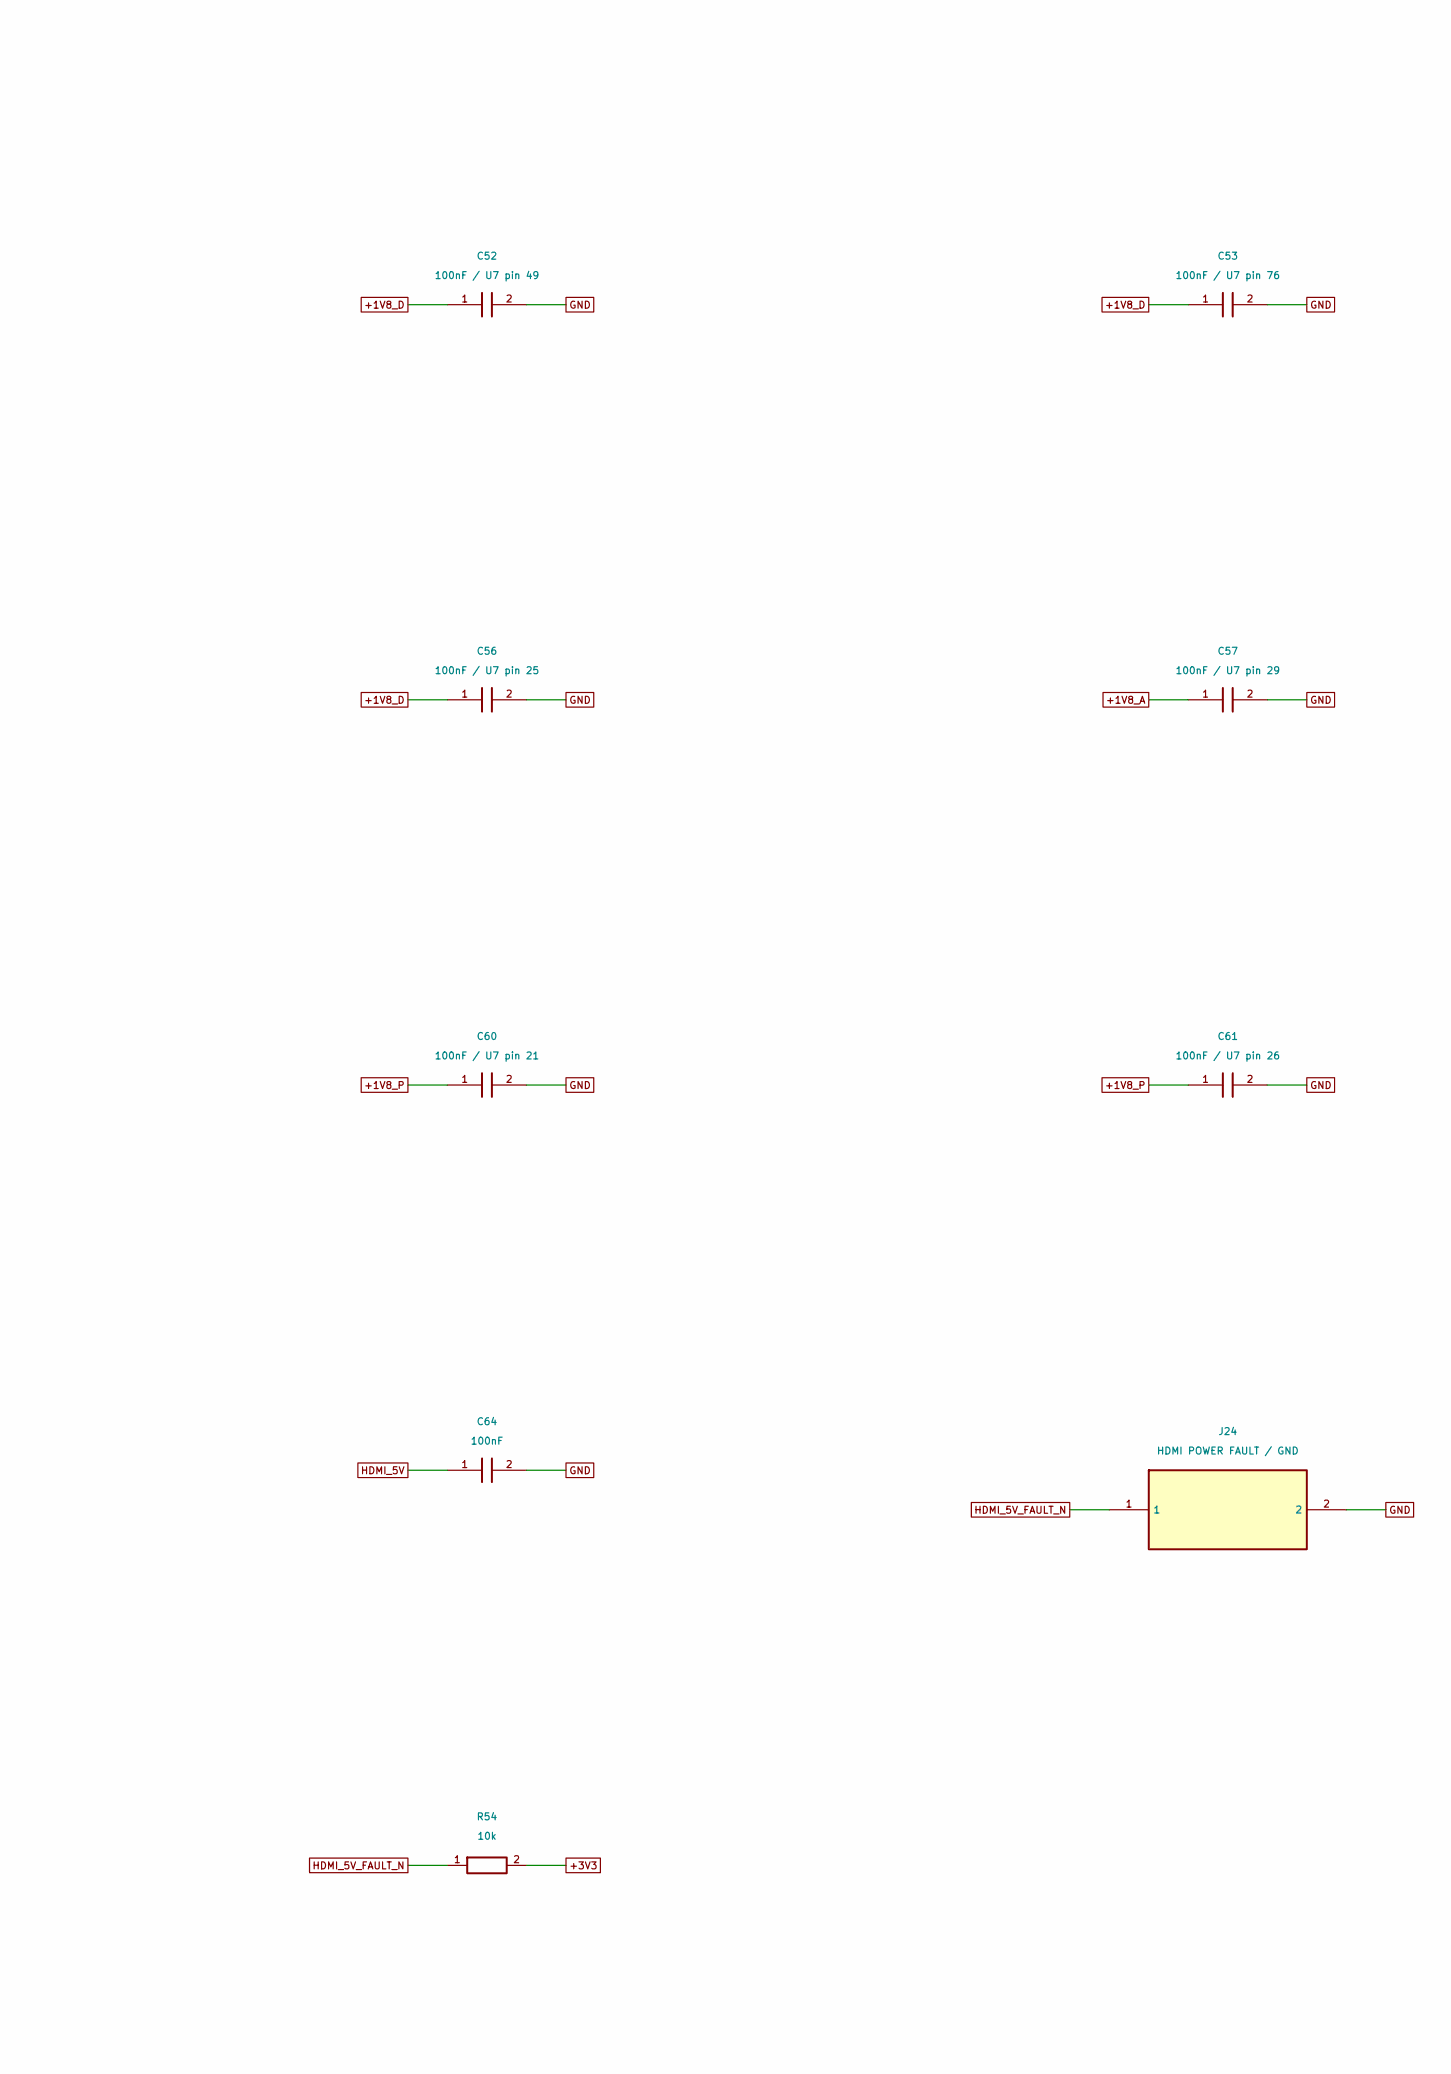
[picture p119: schematic arc-decoupling.kicad_sch, Open Cinema - arc-decoupling, part in row 1, column 2]

Parts:
C50: 100nF / U7 pin 1; C_0603_1608Metric; MPN CL10B104KB8NNNC
C51: 100nF / U7 pin 19; C_0603_1608Metric; MPN CL10B104KB8NNNC
C52: 100nF / U7 pin 49; C_0603_1608Metric; MPN CL10B104KB8NNNC
C53: 100nF / U7 pin 76; C_0603_1608Metric; MPN CL10B104KB8NNNC
C54: 100nF / U7 pin 77; C_0603_1608Metric; MPN CL10B104KB8NNNC
C55: 100nF / U7 pin 24; C_0603_1608Metric; MPN CL10B104KB8NNNC
C56: 100nF / U7 pin 25; C_0603_1608Metric; MPN CL10B104KB8NNNC
C57: 100nF / U7 pin 29; C_0603_1608Metric; MPN CL10B104KB8NNNC
C58: 100nF / U7 pin 34; C_0603_1608Metric; MPN CL10B104KB8NNNC
C59: 100nF / U7 pin 41; C_0603_1608Metric; MPN CL10B104KB8NNNC
C60: 100nF / U7 pin 21; C_0603_1608Metric; MPN CL10B104KB8NNNC
C61: 100nF / U7 pin 26; C_0603_1608Metric; MPN CL10B104KB8NNNC
C62: 100nF / U7 pin 47; C_0603_1608Metric; MPN CL10B104KB8NNNC
C63: 1uF 16V; C_0603_1608Metric; MPN CL10B105KO8NNNC
C64: 100nF; C_0603_1608Metric; MPN CL10B104KB8NNNC
J24: HDMI POWER FAULT / GND; PinHeader_1x02_P2.54mm_Vertical; MPN TSW-102-07-G-S
R52: 226k 1%; R_0603_1608Metric; MPN RC0603FR-07226KL
R53, R54: 10k; R_0603_1608Metric; MPN RC0603FR-0710KL

Connections:
+1V8_A: C57.1, C58.1, C59.1; also elsewhere on the board
+1V8_D: C50.1, C51.1, C52.1, C53.1, C54.1, C55.1, C56.1; also elsewhere on the board
+1V8_P: C60.1, C61.1; also elsewhere on the board
+3V3: C62.1, R54.2; also elsewhere on the board
+5V_IN: C63.1; also elsewhere on the board
GND: C50.2, C51.2, C52.2, C53.2, C54.2, C55.2, C56.2, C57.2, C58.2, C59.2, C60.2, C61.2, C62.2, C63.2, C64.2, J24.2, R52.2, R53.2; also elsewhere on the board
HDMI_5V: C64.1; also elsewhere on the board
HDMI_5V_EN: R53.1; also elsewhere on the board
HDMI_5V_FAULT_N: J24.1, R54.1; also elsewhere on the board
HDMI_ILIM: R52.1; also elsewhere on the board

Notes on the sheet:
A12 ARC STUDY - local decoupling and HDMI power control
Placement is a space study. Route decouplers at their named U7 pins with short ground vias.

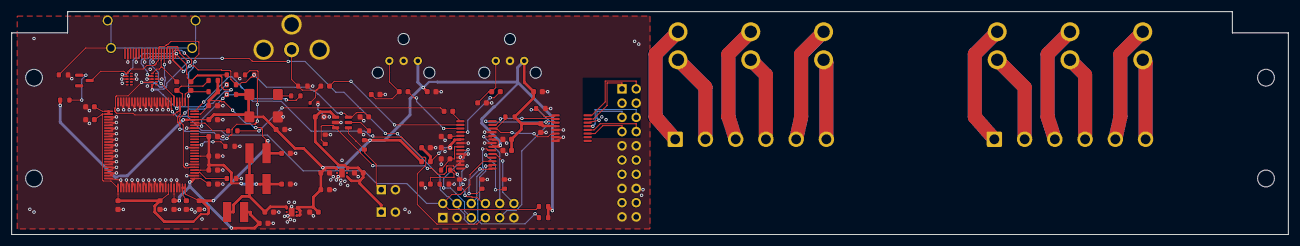
[picture p120: board rear-io-A12.kicad_pcb from above]

Board: 4 copper layers, 228.0 x 39.8 mm, 98 parts (0 on the bottom side), 69 nets.

Other parts of the board:
H1, H2, H3, H4: D3 reference; MountingHole_D3_Reference_A8
