k3rnL/open-cinema-hardware/(commit log)

2026-11-03 Add rear I/O mechanical KiCad study
    [coax.step, connector-placement.csv, hdmi.step, optical.step, rear-io-A0-board-only.step, rear-io-A0-envelopes.step, rear-io-A0-outline.dxf, rear-io.kicad_pcb]
2026-11-03 Select rear connectors and model vertical carrier with optical daughterboards
    [10078837-001LF.step, 1732496.step, FCR684205R.step, RCJ-021.step, connector-placement.csv, optical-daughterboard-assembly.step, optical-input-A1.step, optical-input.kicad_pcb]
2026-11-03 Replace industrial speaker terminals with red-black clip fit study
    [KLS1-WP-6P-03B.step, connector-placement.csv, rear-io-A2-assembly.step, rear-io-A2-board-only.step, rear-io-A2-outline.dxf, rear-io.kicad_pcb]
2026-11-03 Use straight speaker terminals in the 220 mm rear opening
    [DragonCity_PT-603B.step, connector-placement.csv, rear-io-A3-assembly.step, rear-io-A3-board-only.step, rear-io-A3-outline.dxf, rear-io.kicad_pcb]
2026-11-03 Restore plate alignment holes in the rear PCB and STEP model
    [rear-io-A4-assembly.step, rear-io-A4-board-only.step, rear-io-A4-outline.dxf, rear-io.kicad_pcb]
2026-11-03 Add matching rear alignment holes on both sides
    [rear-io-A5-assembly.step, rear-io-A5-board-only.step, rear-io-A5-outline.dxf, rear-io.kicad_pcb]
2026-11-03 Support optical boards and export rigid Fusion integration model
    [optical-cradle-A6.step, optical-cradle-A6.stl, optical-cradle-with-fasteners-A6.step, optical-daughterboard-supported-A6.step, optical-input-A6.step, optical-input.kicad_pcb, rear-io-A6-assembly.step, rear-io-A6-board-only.step]
2026-11-03 Record 4 ohm speaker constraint and reject 3 A substitute
2026-11-03 Select Cliff FE6930 blocks and verify eight-pair A7 fit model
    [Cliff_FE6930.step, connector-placement.csv, optical-input-A7.step, rear-io-A7-assembly.step, rear-io-A7-board-only.step, rear-io-A7-outline.dxf, rear-io-A7-rigid.f3d, rear-io-A7-rigid.step]
2026-11-03 Build horizontal A8 rear connector fit study and record integration limits
    [HDMI_A_Amphenol_10029449-x01xLF_Horizontal.step, KLS1-WP-6P-03B_horizontal_A8.step, RCJ-011_A8.step, connector-placement.csv, rear-io-A8-assembly.step, rear-io-A8-board-only.step, rear-io-A8-board-rigid.step, rear-io-A8-connection-plate.step]
2026-11-03 Remove backplate and L brackets from PCB integration model
    [rear-io-A9-legacy-frame.step, rear-io-A9-rigid.f3d, rear-io-A9-rigid.step]
2026-11-03 Add A10 optical/coax and LVDS electrical draft with integration exports
    [C_0603_1608Metric.step, L_0603_1608Metric.step, PinHeader_1x02_P2.54mm_Vertical.step, PinHeader_2x06_P2.54mm_Vertical.step, PinHeader_2x10_P2.54mm_Vertical.step, R_0603_1608Metric.step, SOT-23-5.step, TSSOP-16_4.4x5mm_P0.65mm.step]
2026-11-04 Add A11 ARC receiver schematic, source selection and rigid integration draft
    [C_0603_1608Metric.step, LQFP-100_14x14mm_P0.5mm.step, L_0603_1608Metric.step, L_Bourns-SRN4018.step, Oscillator_SMD_Abracon_ASV-4Pin_7.0x5.1mm.step, PinHeader_1x02_P2.54mm_Vertical.step, PinHeader_2x06_P2.54mm_Vertical.step, PinHeader_2x10_P2.54mm_Vertical.step]
2026-11-04 Route A12 ARC prototype and add manufacturing review package
    [C_0603_1608Metric.step, D_SOD-523.step, LQFP-100_14x14mm_P0.5mm.step, L_0603_1608Metric.step, L_Bourns-SRN4018.step, Oscillator_SMD_Abracon_ASV-4Pin_7.0x5.1mm.step, PinHeader_1x02_P2.54mm_Vertical.step, PinHeader_2x06_P2.54mm_Vertical.step]
