k3rnL/open-cinema-hardware/(notices)

Notices in the files:
boards/rear-io-A12/models/PinHeader_2x06_P2.54mm_Vertical.step:
Copyright (C) 2017, kicad StepUp
This work is licensed under the [Creative Commons CC-BY-SA 4.0 License](https://creativecommons.org/licenses/by-sa/4.0/legalcode),
with the following exception:
To the extent that the creation of electronic designs that use 'Licensed Material' can be considered to be 'Adapted Material',
You are free to use the library data in your own projects without the obligation to share your project files under this or any other license agreement.
boards/rear-io-A12/models/R_0603_1608Metric.step:
Copyright (C) 2018, kicad StepUp
boards/rear-io-A12/models/USON-10_2.5x1.0mm_P0.5mm.step:
This program is free software: you can redistribute it and/or modify
it under the terms of the GNU General Public License as published by
the Free Software Foundation, either version 3 of the License, or
any later version.
itself might be covered by the GNU General Public License.
boards/rear-io-A12/models/WSON-6-1EP_2x2mm_P0.65mm_EP1x1.6mm.step:
Copyright (C) 2020, kicad StepUp
boards/rear-io-A12/models/SOT-23-6.step:
Copyright (C) 2025, KiCAD
This work is licensed under the
[Creative Commons CC-BY-SA 4.0 License](https://creativecommons.org/licenses/by-sa/4.0/legalcode),
project files under this or any other license agreement. However, if you wish to distribute
